kubiq/n-gauge/README.md

# N Gauge

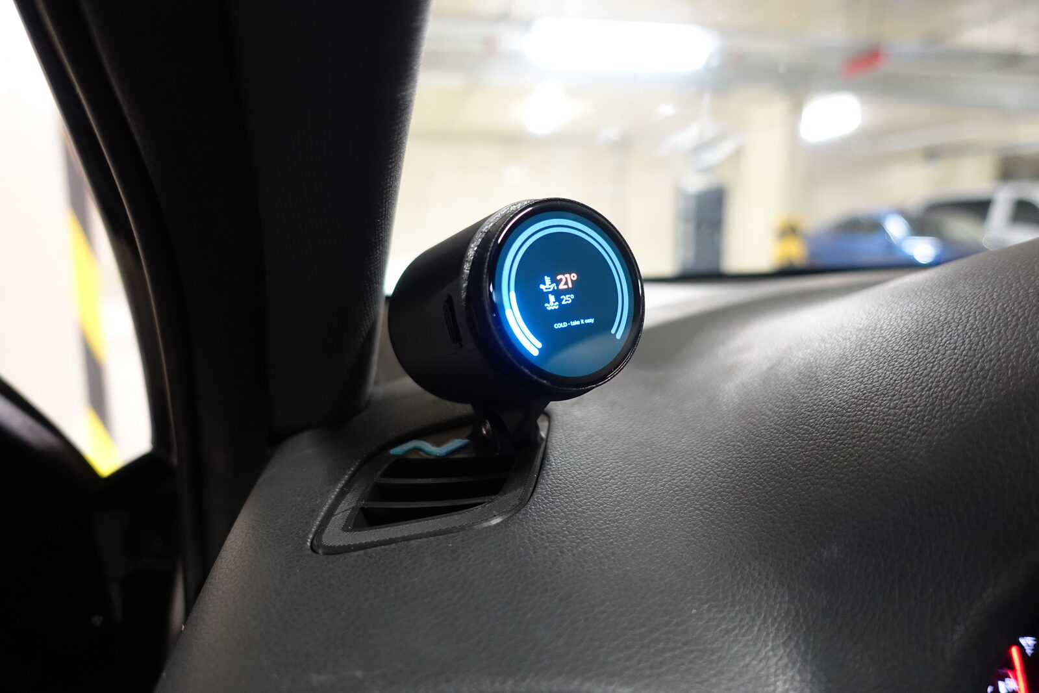
[picture p1: docs/photos/pod-on.jpg]
The pod on the dash, showing oil and coolant on a cold engine


A round AMOLED gauge that lives in the driver-side air vent of a **Hyundai
i30 N**, reading the car live over the OBD-II port: **oil temperature** - the
number the car's own dashboard hides behind a menu - plus coolant, boost, tyre
pressures, a g-meter, GPS speed and a lap timer. It logs every drive to an SD
card, uploads the logs home by itself as the car starts - over the phone's
hotspot and a WireGuard VPN - and a phone app pulls them off it and shows
each drive on a map.

Everything here was built for one car and is in daily use in it. It is a
hobby project, published in case the findings, the code or the approach help
someone with the same car or the same board.

<p>
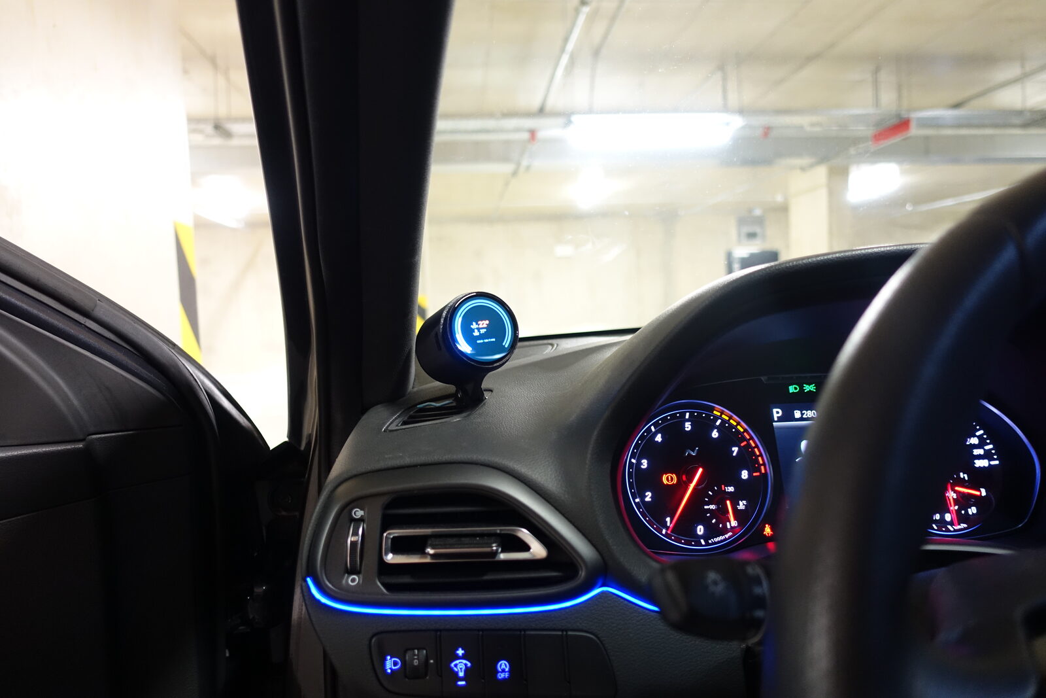
[picture p2: docs/photos/driver-view.jpg]
The driver's view: the pod above the left vent, beside the cluster

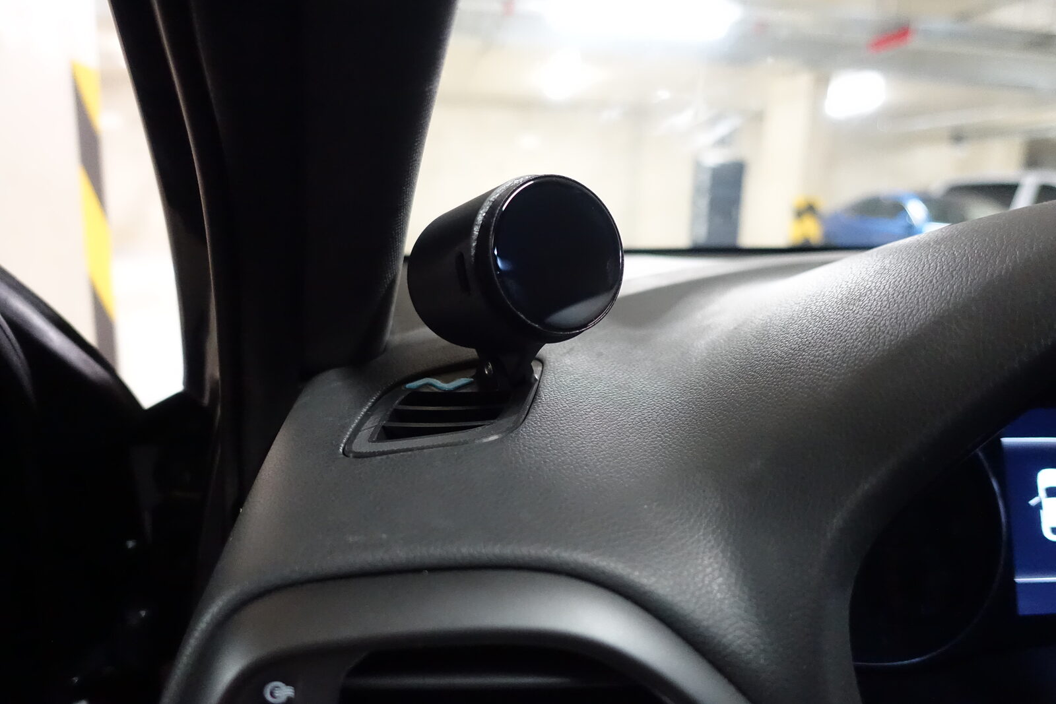
[picture p3: docs/photos/pod-off.jpg]
The pod switched off - a printed housing on the vent

</p>

*From the driver's seat, beside the car's own cluster; and switched off - the
3D-printed housing replaces the left air vent's surround.*

<p>
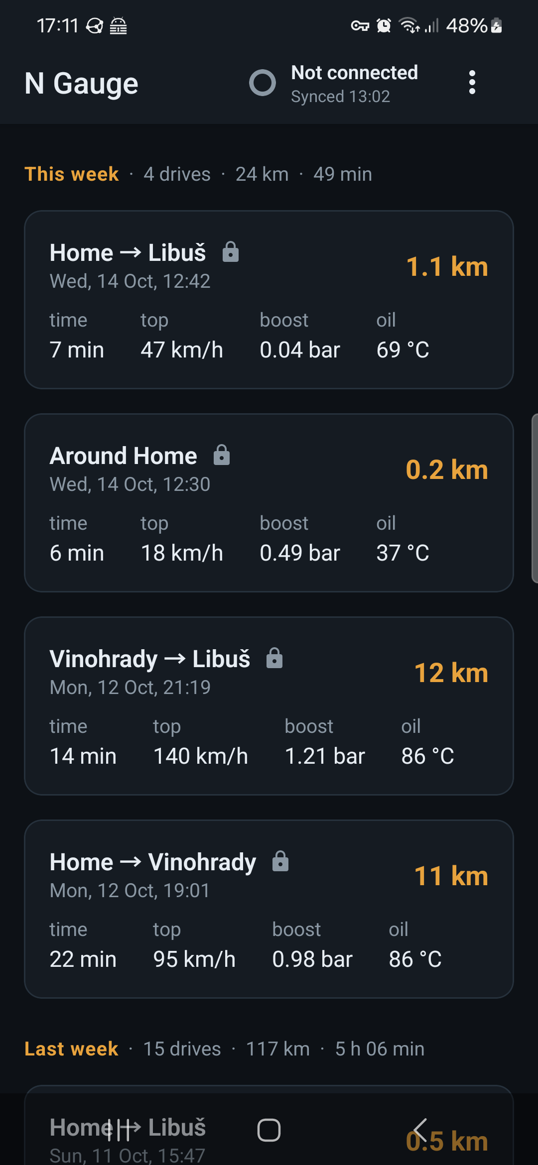
[picture p4: mobile/docs/screenshots/01-trips.png]

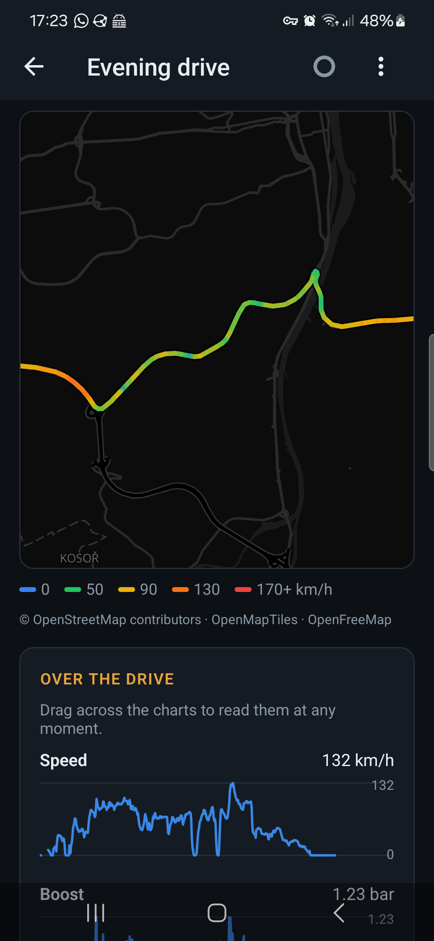
[picture p5: mobile/docs/screenshots/03-trip-map.png]

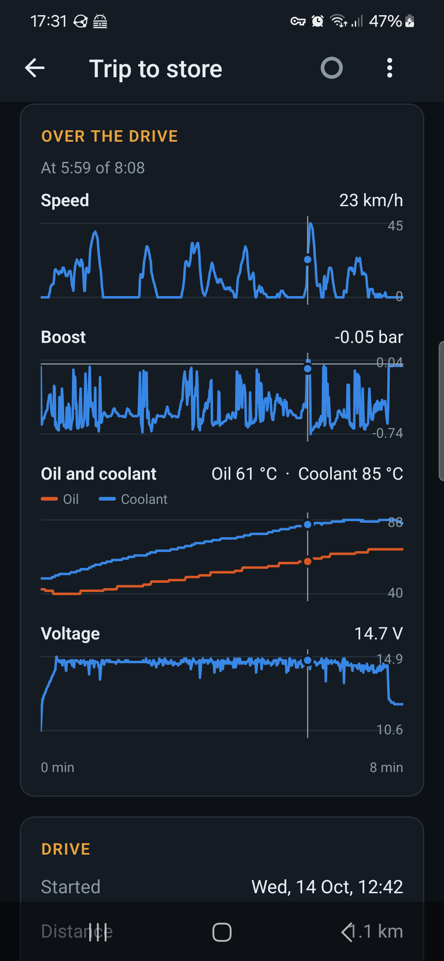
[picture p6: mobile/docs/screenshots/07-drive-charts.png]

</p>

*The phone app: every drive, named after where it went and grouped by week,
with the gauge in the header - its last sync, like a watch in Garmin
Connect; a tap on it syncs, then the phone is back on the internet. A drive
on the map, coloured by speed, and its speed, boost, temperatures and
voltage over time. More in [mobile/](mobile).*

<p>
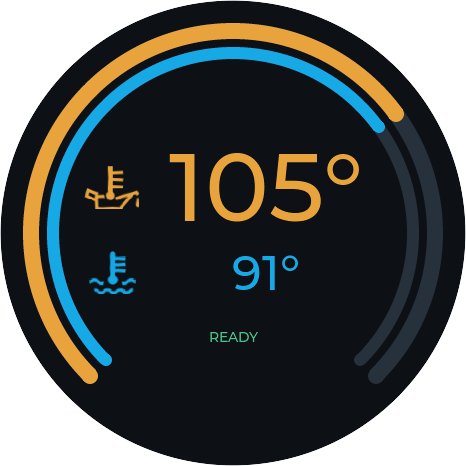
[picture p7: docs/gauge/01-oil.png]
Oil and coolant

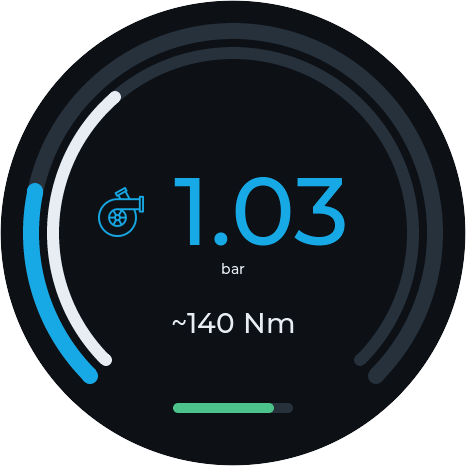
[picture p8: docs/gauge/02-boost.png]
Boost and torque

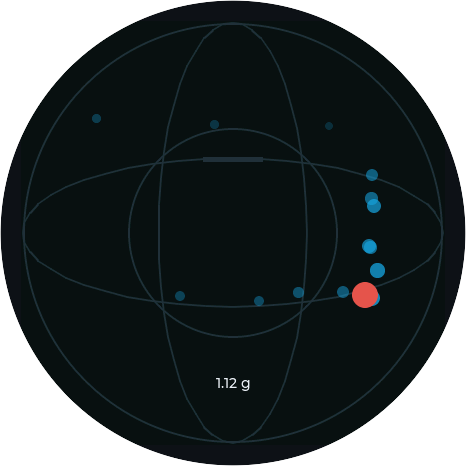
[picture p9: docs/gauge/03-gmeter.png]
The g-meter

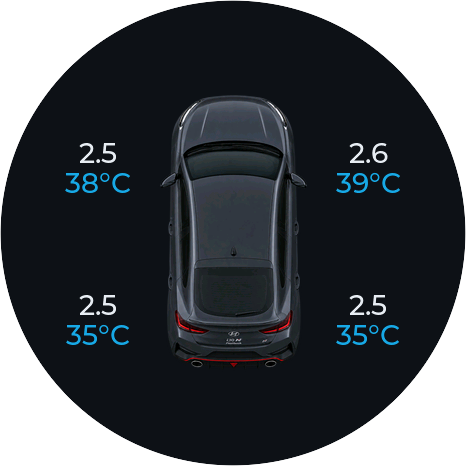
[picture p10: docs/gauge/04-tyres.png]
Tyre pressures and temperatures

</p>
<p>
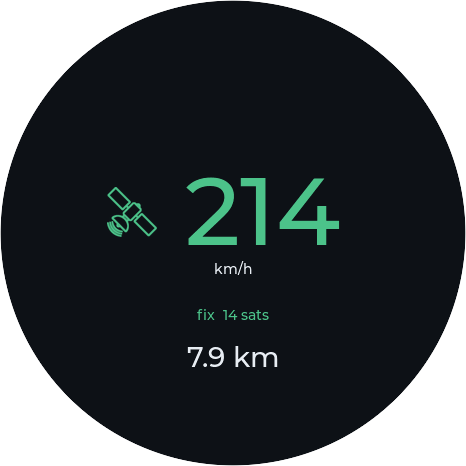
[picture p11: docs/gauge/05-gps.png]
GPS speed and trip

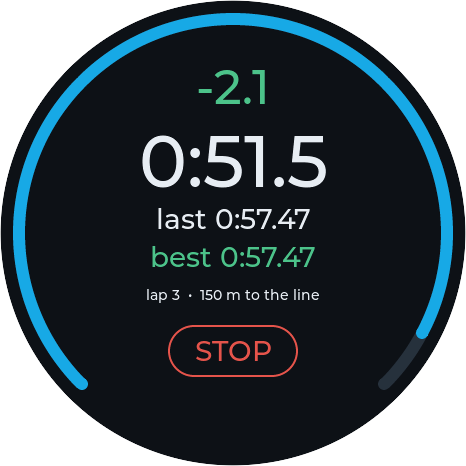
[picture p12: docs/gauge/06-track.png]
The lap timer, with the delta to the best lap

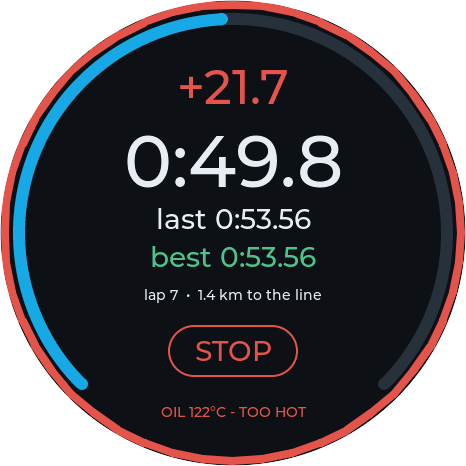
[picture p13: docs/gauge/07-oilhot.png]
The lap timer with the oil over-temperature warning around it

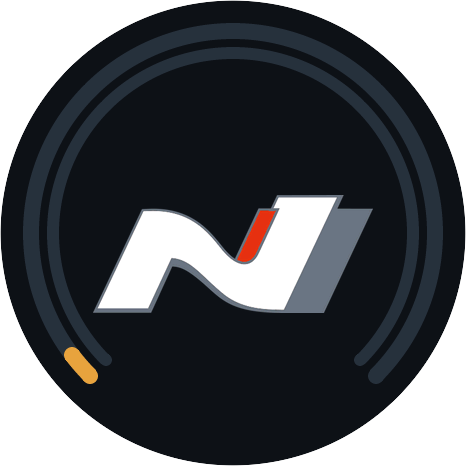
[picture p14: docs/gauge/00-wake.png]
Waking up: the N badge until the car answers

</p>

*The gauge's screens - oil and coolant, boost, the g-meter, tyres, GPS, and
the lap timer 1.8 s up on the best lap, the arc filling up to the line - then
the oil over its warning on the in-lap, a red rim over whichever screen is
up, and the N badge it wakes up with. Swiped through on the gauge; these are
from the [simulator](sim) on a made-up track session (`sim/screenshots.sh`).*

## What it does

- **Gauges:** oil and coolant (concentric arcs, with a cold-engine "not
  ready" state, and over-temperature warnings on every screen), boost, a
  g-meter, the four tyre pressures and temperatures, GPS speed and trip
  distance, a lap timer that finds the start/finish line by itself (tap START
  in the pit, then drive), with how far the line is and the live delta to the
  best lap.
- **Logging:** a CSV of every drive (2 Hz, decoded values - battery voltage,
  fuel rate, lambda, catalyst and fuel rail among them), a GPX track at
  25 Hz, a sleep log, and for each track session a Racelogic `.vbo` with
  every channel, which lap analysers open (HackTheTrack, Circuit Tools).
  Logs can be encrypted to a key only the phone holds, so a card taken out of
  the gauge gives nothing away. GPS points are kept only while the car talks
  or really moves, so a parked car's GPS drift is not a drive.
- **Upload home:** as the car starts - in the garage or setting off, where
  the GPS matters least - the gauge joins the phone's hotspot (a phone
  routine turns it on when it connects to the car's Bluetooth), opens a
  WireGuard tunnel into the home network and sends a small service on the
  home server ([server/](server)) whatever it lacks, resuming where the last
  upload stopped. The logs go as encrypted as they are on the card. Set up
  once in the app: the hotspot, the VPN (the gauge makes its own key; the app
  shows its public half for the router) and the server, with a time limit
  for how long the hotspot is the gauge's. Measured first, with a test build:
  transmitting costs ~6 dB of GNSS signal at any WiFi power, so it happens
  in the seconds an upload takes, not the whole drive. An optional status
  screen shows where it is - the hotspot, the VPN, the firmware download,
  the logs sent - and what came of the last one.
- **Waking up:** the N badge until the car answers, so the gauges never
  show a row of dashes; with a PC on USB, a status page for the desk.
- **Power:** deep sleep when the car goes quiet, ~11 mA parked (about 57
  days on the battery); wakes on CAN activity, the button, or the door
  opening (the IMU's wake-on-motion).
- **Firmware updates:** from the phone, the SD card or - by itself, after
  each upload of the logs, resuming a download that was cut off - the home
  server, signed (Ed25519) so it installs nothing else; on probation, rolled
  back if the new one fails.
- **Phone:** its own WiFi access point - with the upload set up, only once
  swiped to on the gauge, so the radio is free otherwise - with settings
  pages, OTA firmware
  updates with rollback, and an Android app ([mobile/](mobile)) that joins it
  from a QR code on the gauge, syncs the logs by itself and then lets go of
  the gauge's WiFi, so the phone is back on the internet. Each drive is
  named after where it started and ended (offline, from GeoNames - your own
  places like "Home" win), grouped by week, with its track on a map and its
  speed, boost, temperatures and voltage as charts. Delete a drive and it
  goes from the gauge too. A notification says when the gauge has a new
  drive (it puts a mark in its WiFi beacon), the synced drives can be saved
  to a folder by themselves, and the gauge's System card shows which part of
  it holds the internal RAM. English or Czech; dark themes or light.
- **Diagnostics:** a line per boot on the card (GPS rate, clock, CAN, RAM,
  why it last reset - and after a watchdog reset, which task it was), and
  the gauge's own WiFi repairs a join that got no address.

## Hardware

| Part | |
|---|---|
| Waveshare ESP32-S3-Touch-AMOLED-1.75 | 466×466 round AMOLED, touch, IMU, PMU, SD slot |
| SN65HVD230 | CAN transceiver, on OBD pins 6 and 14 |
| u-blox NEO-M9N | GNSS, 25 Hz |
| TPS5430 buck | 12 V → 5 V from OBD pin 16 |
| 3D-printed vent pod | replaces the left air vent; STLs in [mechanical/pod](mechanical/pod) |
| carrier PCB | KiCad, in [hardware/carrier](hardware/carrier) - replaces the breakout boards |

## Things worked out about the i30 N

Most of this took real drives and a lot of wrong turns; the reasoning, and
the wrong turns, are in [DECISIONS.md](DECISIONS.md).

- **Oil temperature is byte 34** of the Mode 22 reply to DID `0xE001` (engine
  ECU, `0x7E0`): `°C = raw × 0.7435 − 49.2`, matched against the dashboard up
  to 100 °C. Mode 01 PID `0x5C` is not supported. Byte 25 of the same reply
  *looks* like oil but is coolant-derived - and correlating bytes against the
  coolant curve picks it, which is how it was wrongly used for weeks.
- **Coolant as the dashboard shows it** is byte 25 of that reply, a few
  degrees below PID `0x05`.
- **Tyre pressures and temperatures** come from the TPMS module (`0x7A0`,
  DID `0xC00B`), not the ECU.
- **The OBD port is behind a gateway:** no broadcast traffic reaches it, only
  replies to requests - so brake, pedal and steering cannot be read passively
  there.
- **Gear** is derived from rpm ÷ speed; the measured ratios are in
  `config.h`.
- **Battery / charging voltage** is plain Mode 01 PID `0x42`: 14.4-15.0 V
  running, 9.9-10.6 V cranking, 12.1-12.7 V just after switching off. Then
  the ECU answers **0.00 V** for a few seconds before going quiet - drop
  it, it is not the battery.

## Repository

| Path | |
|---|---|
| [firmware/car_gauge_v1](firmware/car_gauge_v1) | the gauge firmware (Arduino, ESP32 core 3.x, LVGL 9) |
| [mobile](mobile) | the Android app (Expo / React Native) |
| [server](server) | the upload service the gauge sends its logs to (Python, Docker) |
| [sim](sim) | the gauge firmware on a PC: its screens in a window, fed a recorded drive |
| [tests](tests) | host tests of the firmware's pure logic |
| [hardware](hardware), [mechanical](mechanical) | carrier PCB, 3D-printed parts |
| [DECISIONS.md](DECISIONS.md) | why things are the way they are |
| [docs/flows.md](docs/flows.md) | how it decides, as diagrams: the logs' way, the upload, the WiFi, updates, screens, sleep |
| [PROTOTYPE_GUIDE.md](PROTOTYPE_GUIDE.md), [PRINTING_GUIDE.md](PRINTING_GUIDE.md) | wiring the prototype; printing the pod |

## Building

Firmware ([details](firmware/car_gauge_v1/README.md)):

```sh
./scripts/setup-libs.sh          # Arduino core, pinned libraries, lv_conf
./scripts/build.sh gauge flash   # compile and flash over USB
./scripts/test.sh                # host tests
./scripts/check.sh               # before a commit: tests, both firmware builds, the sim, the server
```

GitHub Actions ([.github/workflows/ci.yml](.github/workflows/ci.yml)) runs the
same checks but the simulator (it needs SDL2 from Ubuntu's mirrors, which
the runners could not reach for days), and the app's, on every push and pull
request. A version tag
(`git tag v2026.11.09 && git push --tags`) also makes a release: the firmware
as an update, and a full image for a first flash over USB. Releases carry the
public half of an update signing key if the repository variable `FW_SIGN_PUB`
holds one, and are signed if the secret `FW_SIGN_KEY` holds its private half
(64 hex digits) - the app then fetches the newest release by itself, checks
its signature against the gauge's key, and offers it in Gauge settings.

The upload server ([details](server/README.md)), on the home server:

```sh
cd server && echo "UPLOAD_TOKEN=$(openssl rand -hex 16)" > .env
docker compose up -d --build
```

With `FW_GITHUB_REPO=owner/name` in its `.env` it also passes that
repository's latest signed release on to the gauge, which then updates itself
([details](server/README.md#firmware-updates)). The signing key, once:

```sh
scripts/release-fw.py --init                 # then FW_SIGN_KEY and FW_SIGN_PUB on GitHub
```

The gauge on a PC ([details](sim/README.md)) - needs SDL2 and CMake:

```sh
sim/run.sh                       # the newest drive in data/, in a window
scripts/make_track_gpx.py        # a made-up track session to drive it with
sim/screenshots.sh               # these screenshots, into docs/gauge/
```

App ([details](mobile/README.md)):

```sh
cd mobile && ./scripts/build-apk.sh install   # release APK onto a phone over adb
```

## Caveats

- **Not affiliated with Hyundai.** "Hyundai", "i30 N" and the N badge used in
  the boot screen and the app icon are Hyundai's trademarks; they appear here
  only to say which car this is for.
- The gauge only **reads** - standard OBD and diagnostic requests, nothing
  that writes to the car. Still: it is your car, your OBD port and your
  responsibility, and a device on the dash must not distract from driving or
  sit in an airbag's path.
- Built and tested on one car, a European i30 N Fastback. Other model years
  or markets may answer differently.

## Licence

[MIT](LICENSE). Third-party assets keep their own licences - see
[firmware/assets/README.md](firmware/assets/README.md). The place names in
the app (`mobile/assets/places`) are from [GeoNames](https://www.geonames.org),
CC BY 4.0.
