kubiq/n-gauge/firmware/assets/coolant_temp.webp

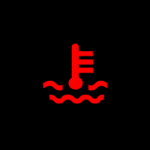
firmware/assets/coolant_temp.webp
