kubiq/n-gauge/firmware/assets/fastback.png

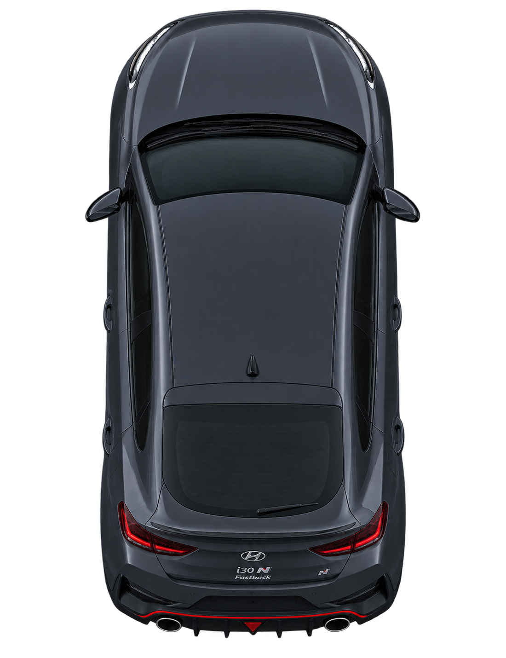
firmware/assets/fastback.png
