kubiq/n-gauge/firmware/assets/oil_temp.png

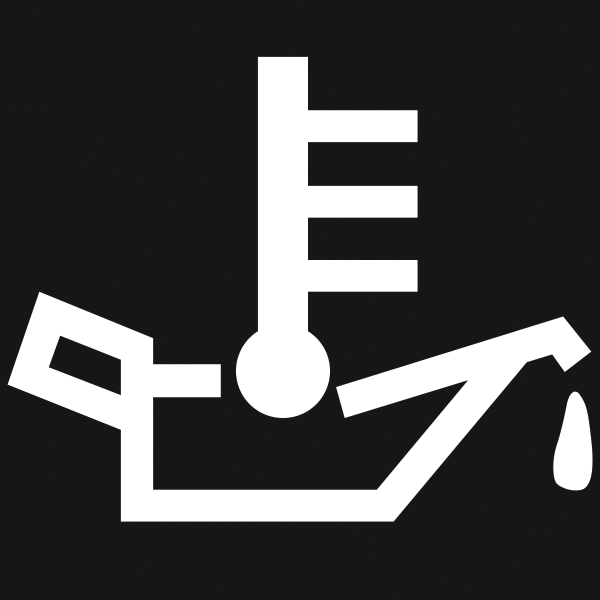
firmware/assets/oil_temp.png
