kubiq/n-gauge/firmware/assets/satellite.jpg

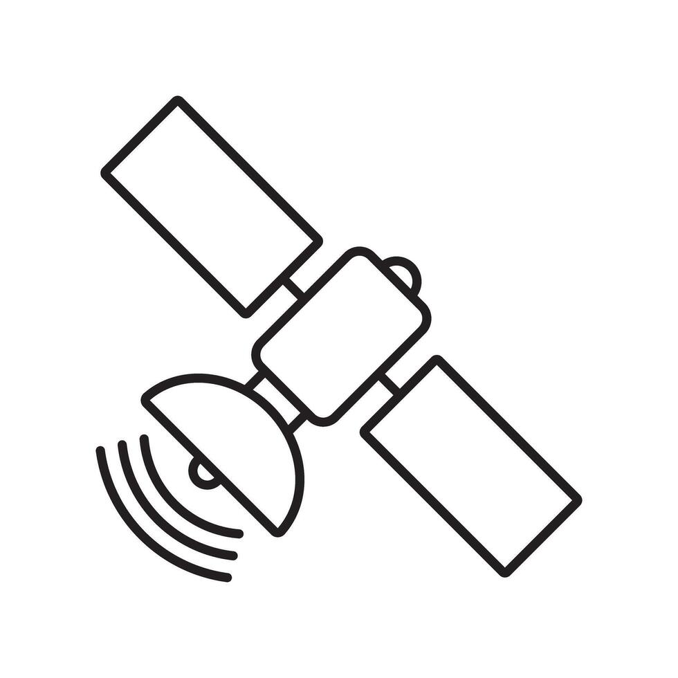
firmware/assets/satellite.jpg
