kubiq/n-gauge/firmware/assets/turbo.jpg

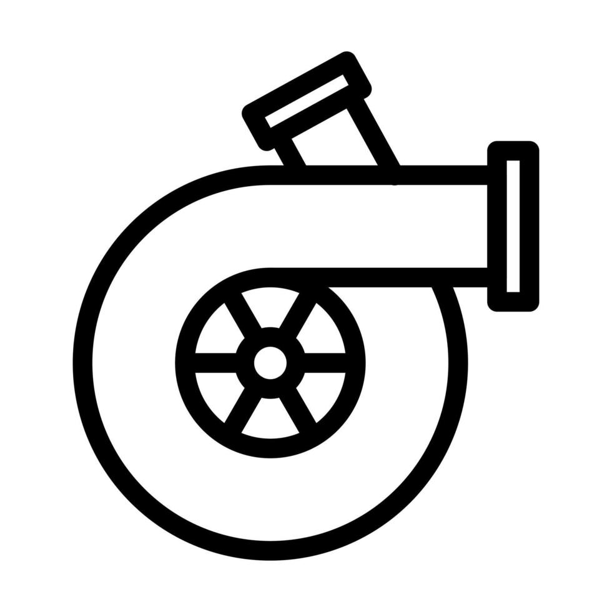
firmware/assets/turbo.jpg
