kubiq/n-gauge/mobile/docs/screenshots/01-pod.png

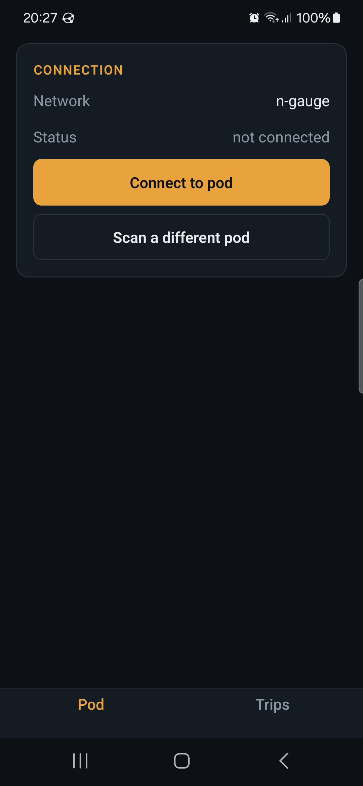
mobile/docs/screenshots/01-pod.png
