kubiq/n-gauge/mobile/docs/screenshots/02-server.png

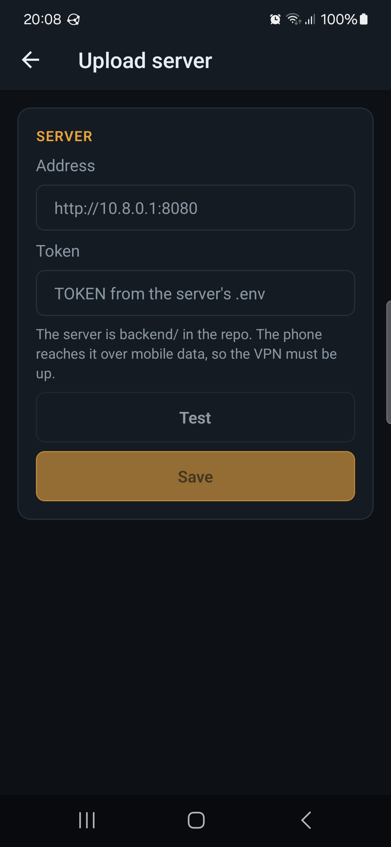
mobile/docs/screenshots/02-server.png
