kubiq/n-gauge/mobile/docs/screenshots/02-trips-menu.png

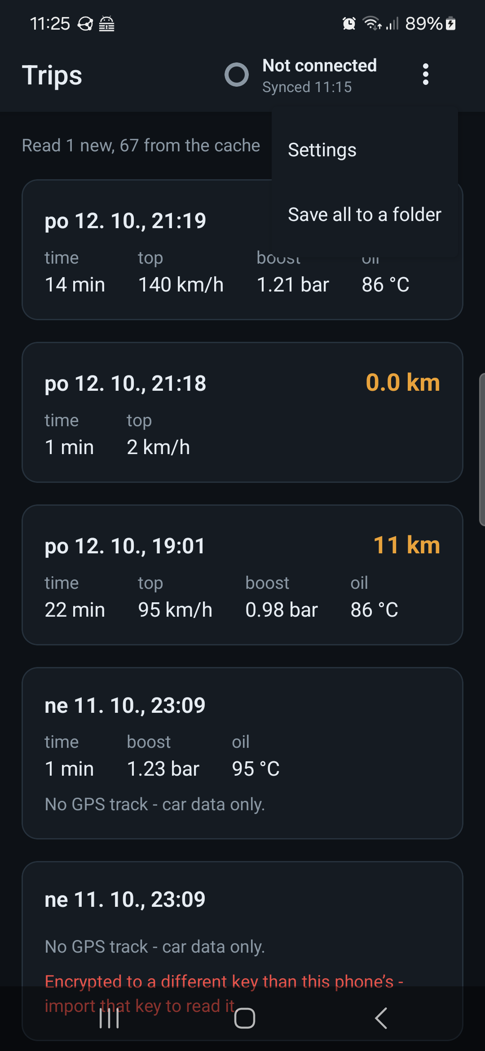
mobile/docs/screenshots/02-trips-menu.png
