kubiq/n-gauge/mobile/docs/screenshots/03-trips.png

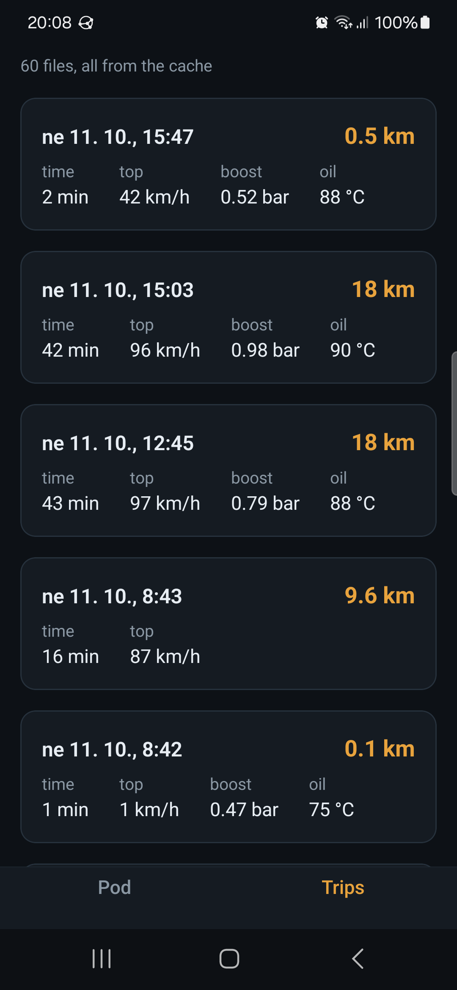
mobile/docs/screenshots/03-trips.png
