kubiq/n-gauge/mobile/docs/screenshots/04-gauge.png

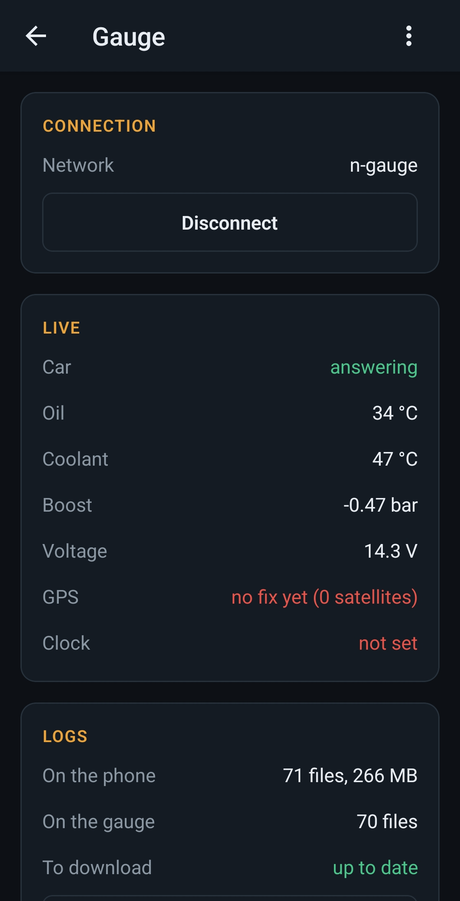
mobile/docs/screenshots/04-gauge.png
