kubiq/n-gauge/mobile/docs/screenshots/04-trip-map.png

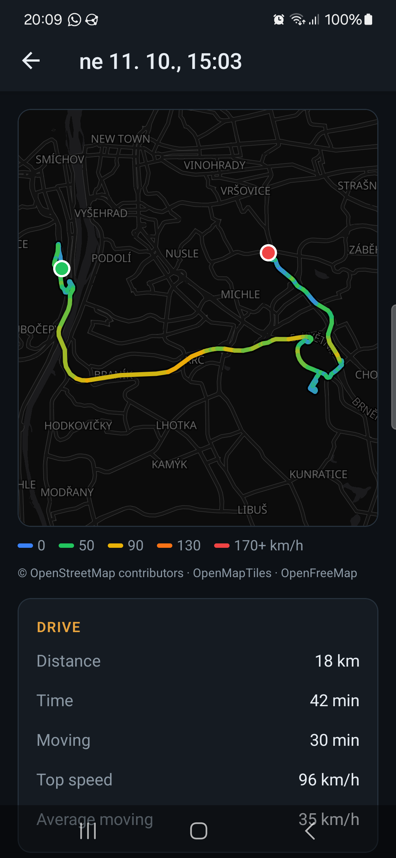
mobile/docs/screenshots/04-trip-map.png
