kubiq/n-gauge/mobile/docs/screenshots/05-settings.png

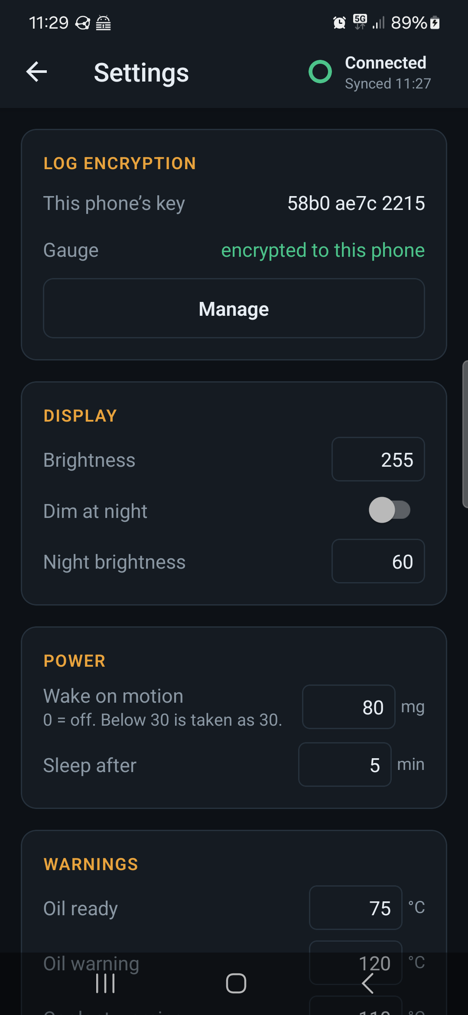
mobile/docs/screenshots/05-settings.png
