kubiq/n-gauge/mobile/docs/screenshots/05-trip-stats.png

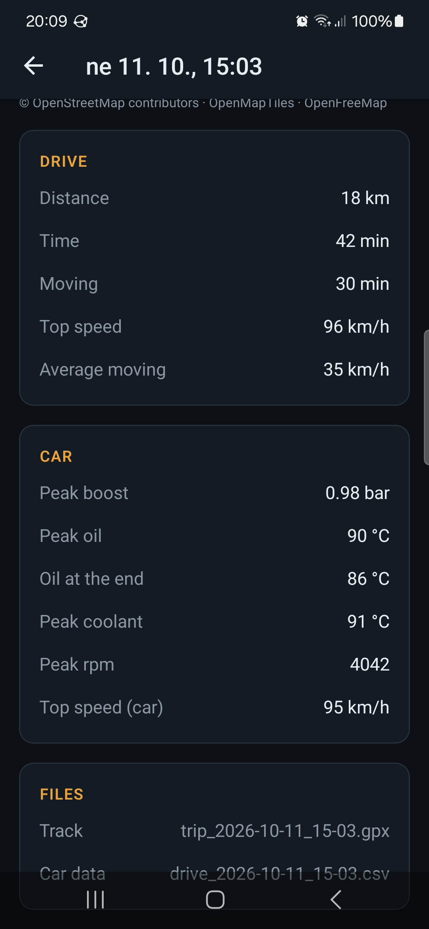
mobile/docs/screenshots/05-trip-stats.png
