kubiq/n-gauge/mobile/docs/screenshots/06-pod-live.png

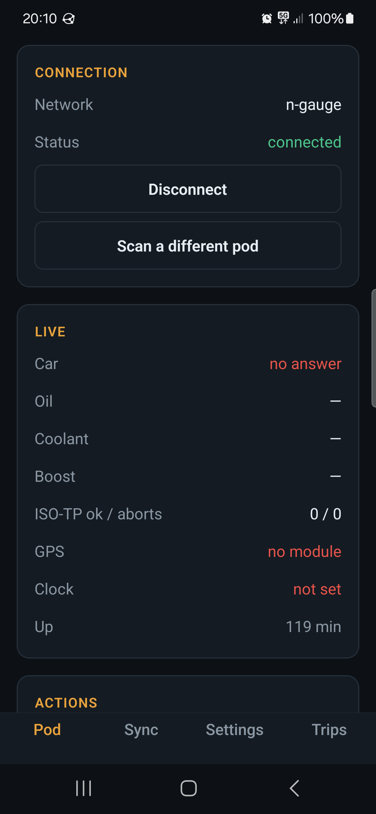
mobile/docs/screenshots/06-pod-live.png
