kubiq/n-gauge/mobile/docs/screenshots/06-settings-logging.png

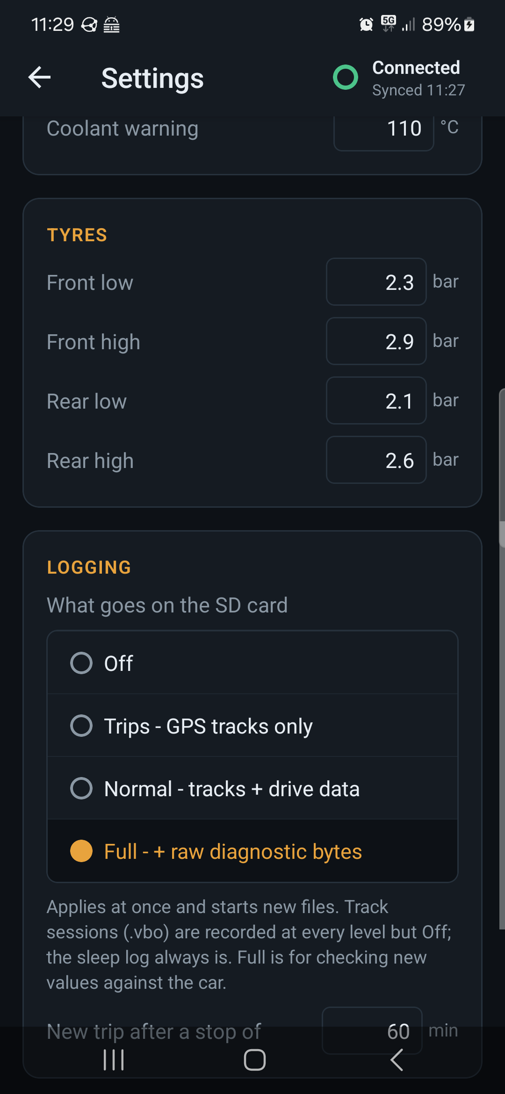
mobile/docs/screenshots/06-settings-logging.png
