kubiq/n-gauge/mobile/docs/screenshots/07-sync.png

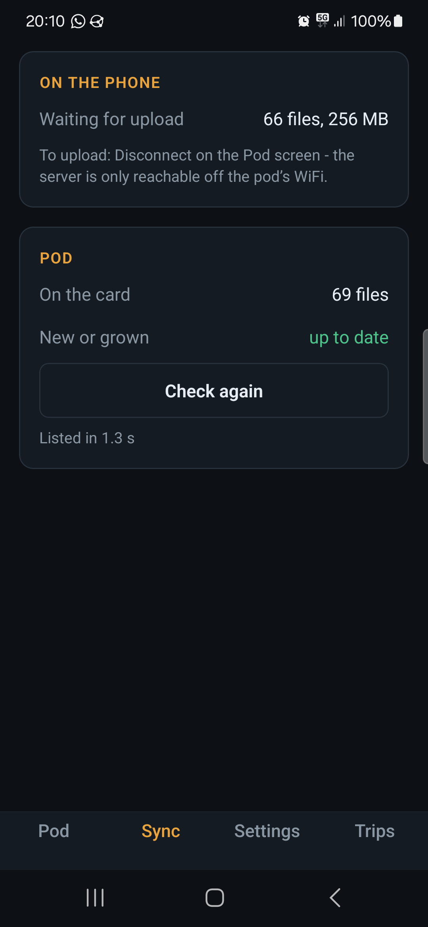
mobile/docs/screenshots/07-sync.png
