kubiq/n-gauge/mobile/docs/screenshots/08-settings.png

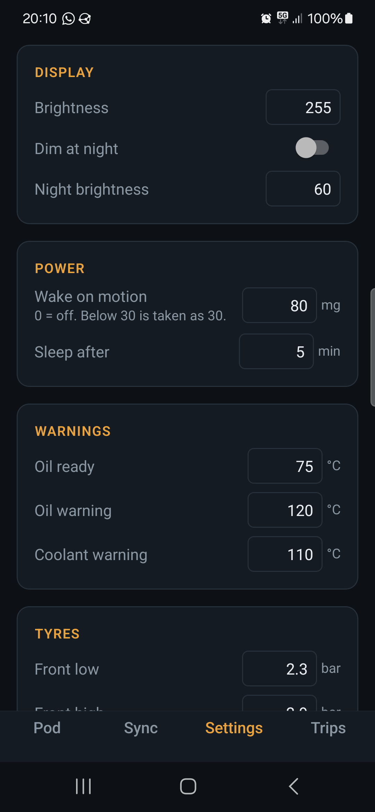
mobile/docs/screenshots/08-settings.png
