kubiq/n-gauge/mobile/docs/screenshots/09-settings-logging.png

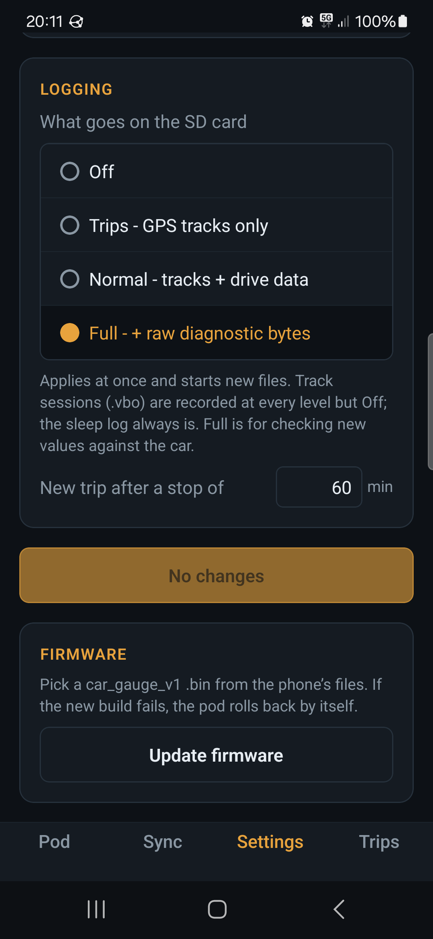
mobile/docs/screenshots/09-settings-logging.png
