kubiq/n-gauge/mechanical/grille_cover_v1.stl

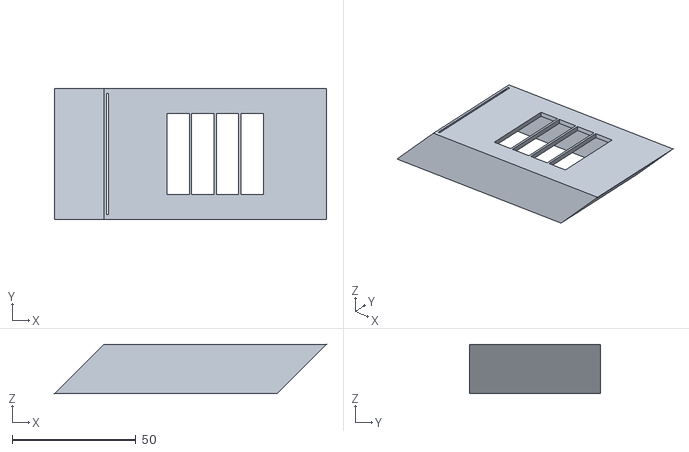
[picture p34: CAD file, 2026-10-11]
mechanical/grille_cover_v1.stl
110.0 x 53.0 x 20.0
