kubiq/n-gauge/mechanical/pod/i30n_internals.stl

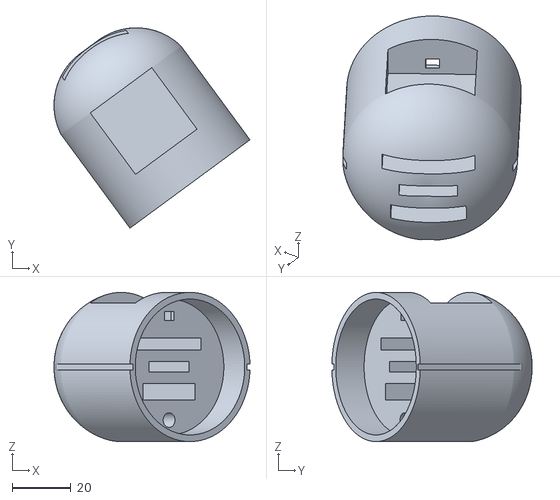
[picture p35: CAD file, 2026-10-11]
mechanical/pod/i30n_internals.stl
66.7 x 68.2 x 50.8
