kubiq/n-gauge/mechanical/pod/i30n_vent_left.stl

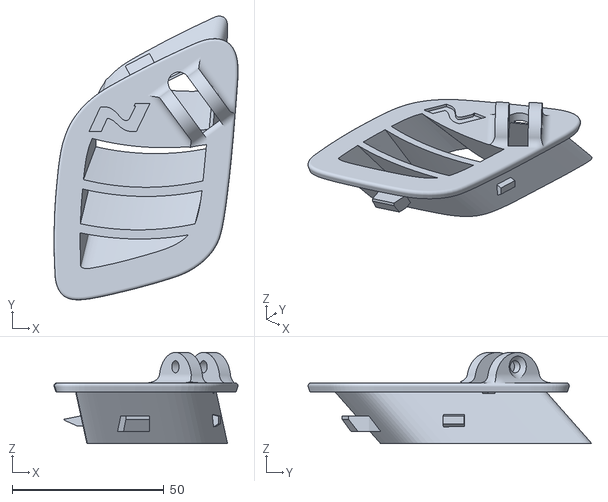
[picture p36: CAD file, 2026-10-11]
mechanical/pod/i30n_vent_left.stl
60.6 x 93.5 x 30.0
