kubiq/n-gauge/mechanical/pod/i30n_pod_left.stl

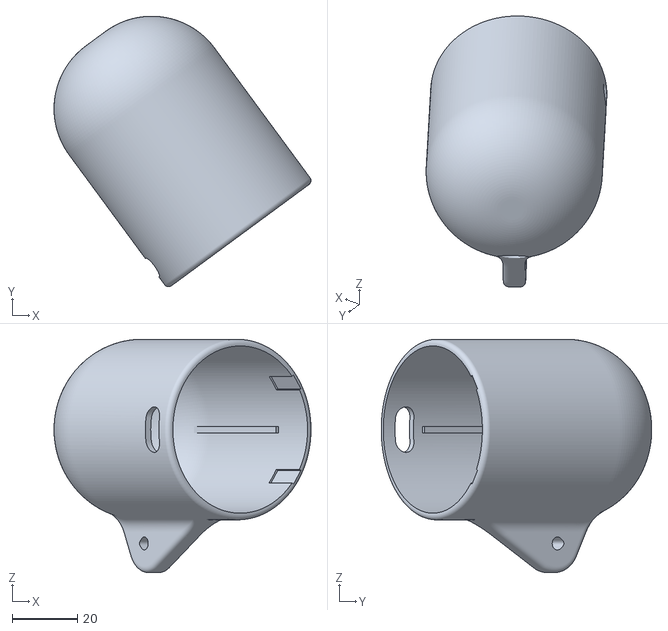
[picture p37: CAD file, 2026-10-11]
mechanical/pod/i30n_pod_left.stl
79.0 x 83.1 x 71.8
