kubiq/n-gauge/prototype-guide.html

Hyundai i30 N · Build Log

# Driver-Vent OBD Gauge — Prototype Guide

A round AMOLED reading oil temperature and boost live from the OBD-II port over CAN. This is the prototype phase — prove the values on a cheap ESP32 before buying the display.

Primary: Oil temp Secondary: Boost Bus: CAN 500 kbit/s MCU: ESP32 → ESP32-S3

98°C

Oil Temp

1.2 bar

Boost

Order list

Order now · in stock

- ✓ Classic ESP32 dev board (have)
- ✓ SN65HVD230 transceiver, 2-pack (ordered · remove 120 Ω)
- ✓ OBD-II male pigtail (flying leads)
- USB power bank (optional — laptop USB powers the ESP32)

Final build

- ✓ Waveshare ESP32-S3 1.75" AMOLED 466×466 — Standard (~$50 · ordered)
- ✓ 12 V→5 V buck (ordered) — ≥36 V input (TPS5430-based); not MP1584 (27 V max). Not needed to prototype.
- ✓ Inline blade-fuse holder (pigtail) + 2 A fuse for the OBD 12 V line (ordered · not an add-a-fuse tap)
- Filament: PETG / ASA (not PLA)

Later · v2

- ✓ GNSS — track pick: u-blox NEO-M9N (~$25–40 · ordered): 25 Hz, 4-constellation, ~1.5 m (≈1 m w/ EGNOS)
- Budget: NEO-M8N (10 Hz). Pro: ZED-F9P (cm, needs RTK feed). Use an active antenna + set dynamic model "Automotive". Wire: VCC · GND · TX→GPIO18

## 01 Parts for the prototype

Everything you need to read real values off the car before spending ~$50 on the round display.

Part | Notes
Classic ESP32 dev board | Has the built-in TWAI/CAN controller
SN65HVD230 transceiver (blue "VP230") | 3.3 V logic. Remove the 120 Ω terminator — see check 1
OBD-II male pigtail (flying leads) | Taps CAN-H / CAN-L / GND
USB power bank | Powers the ESP32 in the car, isolated
Multimeter | For the two checks below

## 02 Before wiring — two checks

Two minutes with a multimeter now saves a confusing first session in the car.

Check 1 · Remove the 120 Ω terminator

The car's CAN bus is already terminated; an extra 120 Ω can corrupt it. Measure resistance across CANH ↔ CANL on the transceiver board alone:

- ~120 Ω → it has a terminator (marked 121) → desolder that resistor.
- Open / very high → no terminator → leave it as is.

Both board variants work: AliExpress = header pins + CTX/CRX labels; Waveshare/Botland = screw terminal + CAN TX/CAN RX labels. Same SN65HVD230 chip, same wiring.

Check 2 · Find OBD pins 6 & 14 — don't trust wire colors

Cheap pigtails use random colors. In continuity / beep mode, touch one probe to a flying wire and the other to each metal pin in the OBD plug. Pin numbers are molded in: 1–8 top row, 9–16 bottom. Label the CAN-H and CAN-L wires once found.

OBD-II pin | Signal | Goes to
6 | CAN-H | transceiver CANH
14 | CAN-L | transceiver CANL
4 / 5 | Ground | ESP32 GND
16 | +12 V (optional, later) | —

## 03 Wiring

Bus speed 500 kbit/s · no extra terminator on our side · power the ESP32 from the power bank during testing.

wiring.txtESP32 GPIO5 (CAN TX) ──►  SN65HVD230 CTX
ESP32 GPIO4 (CAN RX) ──►  SN65HVD230 CRX
ESP32 3.3V           ──►  SN65HVD230 3V3
ESP32 GND            ──►  SN65HVD230 GND
SN65HVD230 CANH      ──►  OBD-II pin 6   (CAN-H)
SN65HVD230 CANL      ──►  OBD-II pin 14  (CAN-L)
ESP32 GND            ──►  OBD-II pin 4 or 5  (GND)

## 04 Flashing the sniffer

Sketch: firmware/can_sniffer/can_sniffer.ino

1. Arduino IDE with the ESP32 board package (Boards Manager → "esp32" by Espressif).
2. Tools → Board → ESP32 Dev Module (or your specific board).
3. Select the correct Port.
4. Open the sketch → Upload.
5. Open Serial Monitor at 115200 baud, line ending = Newline.

If GPIO4/5 clash with your board, change CAN_TX_GPIO / CAN_RX_GPIO at the top of the sketch. Avoid strapping pins 0 / 2 / 12 / 15 and input-only 34–39.

## 05 Test session in the car

1. Plug the pigtail into the OBD-II port (under the dash, driver side).
2. Power the ESP32 from your laptop's USB (the same cable shows the Serial Monitor).
3. Ignition ON (engine off is fine for sniffing; run it for real oil/boost values).
4. Open Serial Monitor.

### What you should see

A stream of [RX] xxx [8] .. lines = CAN frames. ✓ This confirms your tap works. If nothing streams, jump to Troubleshooting.

### Built-in commands

Type a command in the Serial Monitor and press Enter:

Command | Does
s | Toggle the live frame dump on/off (turn OFF to read replies clearly)
oil | Request standard oil temp (Mode 01 PID 5C)
boost | Request manifold pressure (Mode 01 PID 0B)
01 0C | Request RPM — sanity-check the request path
22 XXXX | Enhanced request, 2-byte DID (the real i30 N oil-temp DID)
help | Reprint commands

If oil returns a sensible temperature — great, standard PID works. If it returns a NEGATIVE response, the i30 N doesn't expose 015C → use the enhanced Mode 22 DID below.

## 06 The real oil temp — enhanced Mode 22

The i30 N's true oil temp (and true boost) live in enhanced PIDs requested with Mode 22 to ECU header 7E0. Don't guess the DID — use a community-validated list.

- Car Scanner ELM OBD2 app → the "Hyundai i30 N" custom-PID profile.
- Torque Pro extended-PID CSVs shared on i30 N forums / Reddit.

Each entry gives the request bytes (e.g. 22 XXXX) and a scaling formula. In the Serial Monitor, send the DID; the sketch prints the raw response bytes. Apply the formula — commonly A − 40 or (A·256 + B)/scale — to get °C.

Bring this back

Send me the raw bytes + the formula and we'll bake the oil-temp DID straight into the final firmware.

## 07 Troubleshooting

Symptom | Likely cause / fix
No [RX] frames at all | CAN-H / CAN-L swapped → swap pins 6/14. Or ignition off. Or GND not connected.
twai_start failed on boot | Wrong TX/RX GPIOs for your board, or pins already in use. Change them in the sketch.
Frames garbled / error bursts | Wrong bus speed (must be 500 kbit/s) or the 120 Ω terminator wasn't removed.
NEGATIVE (7F) responses | That PID/DID isn't supported → use the enhanced Mode 22 DID from the list.
A few frames, then silence | Bus went to sleep → turn ignition on / wake the car.

## 08 Power plan — Option B chosen

Powered from OBD-II pin 16 (+12 V) via a 12 V→5 V buck — the whole gauge stays a single OBD-port plug, no fuse-box wiring.

Pin 16 is constant battery power, so the firmware manages sleep to avoid parked drain:

- CAN bus watched → no frames for ~30 s → AMOLED off + esp_deep_sleep.
- Ignition on wakes the bus → ESP32 wakes and resumes the gauge.
- The i30 N diagnostic CAN bus sleeps after ignition-off, so this triggers cleanly.

⚠ Open TODO · measure quiescent draw

Once sleep is implemented, measure actual parked current on the 12 V feed — including the buck's own quiescent draw (cheap bucks pull several mA at no load). Target a few mA or less; if too high, use a low-Iq buck or a hard cutoff. Fallback: Option A — switched 12 V from a cabin fuse, which cuts power fully with the car.

## 09 After the prototype succeeds

1. Confirm oil temp + boost read correctly and update fast enough.
2. Order the Waveshare ESP32-S3 1.75" AMOLED Round Touch (466×466, ~$50).
3. Move CAN to the S3 header: GPIO17 = CAN TX, GPIO16 = CAN RX (GPIO18 free).
4. Build the LVGL gauge UI — oil-temp + boost, touch to switch, brightness.
5. Add sleep-on-bus-idle power management, then measure quiescent draw.
6. 3D-print the vent panel in PETG / ASA (not PLA — dash heat), keeping OEM louvers working.
7. Final power: OBD pin 16 → 12 V→5 V buck → display 5 V pin.

## 10 Mounting — vent cover + display pod

Location: the driver-side fixed side-window demister grille on the dash top by the A-pillar (part 97383-G3000-TRY). It blows up/out at the glass, so a pod mounted in front, angled inboard at the driver, sits out of the airflow path. Full demist kept, no trade-off.

1. Pop off the OEM demister grille (clips) and study its mounting + the grille opening.
2. Measure with calipers or 3D-scan the opening and the dash-top curvature.
3. Model a replacement cover that recreates the fixed grille slots (or reuses the OEM grille insert) — demist airflow to the side window untouched.
4. Add a low-profile display pod on the driver/inboard side, in front of the grille, angled at the eyes, with a recessed circular pocket + lip/gasket for the round AMOLED. Keep it clear of the outboard airflow.
5. Route the display FPC + wiring down behind the A-pillar trim / into the dash to the ESP32 and power.
6. Print in ASA / PETG (dash heat + UV); matte finish or wrap to match the dash.

⚠ Near the windscreen — keep it low

This spot is at the windscreen base: too tall blocks forward view and reflects in the glass. Keep the pod low, angle the face slightly down, and use auto-dim (day/night) + an anti-glare film to kill windscreen reflection.

### OEM part number (confirmed — PD / Elantra GT catalog)

Target = the fixed side-window demister grille: Nozzle Assy-Side Defroster, LH = 97383-G3000-TRY (driver side). RH = 97393-G3000-TRY.

- Single variant (-TRY, black) — no colour-suffix ambiguity.
- Order one as a donor to 3D-scan; keep the fitted one intact.
- Not this build: the adjustable louvered corner vent lower down = 97480-G3000-[color].

### Custom pod — fully bespoke

No usable OEM-vent STL exists, and off-the-shelf holders are RHD-only and sized for 52/60 mm gauges. So this is modeled from scratch, exactly for our ~46 mm display — which is the point: it's our part. (See References for a RHD holder worth eyeballing for the approach.)

1. Remove the OEM demister grille; note how it clips in and the grille opening pattern.
2. Capture geometry — phone 3D-scan of the removed grille + opening; fallback calipers + photos with a scale marker.
3. Design a two-part piece: a cover that recreates the fixed grille slots (keeps demist airflow), and a pod holding the ~46 mm AMOLED at driver angle with a bezel lip and rear cable exit.
4. Print test rings of just the opening profile first to dial in fit before the full part.
5. Final print in ASA / PETG, matte or wrapped to match the dash.

### 3D scanning (phone → cloud)

Using the RealityScan phone app (Epic cloud) — the Linux desktop build needs an NVIDIA ≥8 GB GPU we don't have, so cloud is the path. Photos, not video — ~40–60 stills, 70–80 % overlap, 3 heights all around, tap-to-focus.

⚠ Monotone black = blobby mesh → add features

Stipple the show face with a white paint marker (POSCA): many small ~1–2 mm dots, RANDOM spacing (never a grid), densely all over. White-on-black is ideal contrast; a grid confuses the matcher.

It's your car's part, so use a water-based paint pen → wipes off with isopropyl alcohol (test an edge first). Keep dots off the mounting/clip faces. Use soft diffuse light to avoid gloss hotspots. Avoid uniform white "scanning spray" — that's for laser scanners, not photogrammetry.

- Alignment/scale: textured background + a couple of printed coded targets; set scale from two dots a known distance apart.
- Flip the part to capture the mounting/clip side.
- Hybrid — don't scan the slots: caliper the grille slot width/spacing/count + mounting dims and model them parametrically; use the scan only for the curved shell. Export OBJ (meshes ~0.2–0.5 mm noisy).

### CAD on Linux

Fusion 360 isn't native on Linux → model in FreeCAD (parametric, native — pod + snap-fit, mesh as reference) or Blender (mesh cleanup / organic surfaces).

## 11 Feature roadmap

What the gauge grows into. Oil temp, cold-engine warning, boost and the over-temp guard are the v1 core; connectivity and the GPS track come much later.

Hardware note · GPS — buy the Standard version

The GPS variant is out of stock, and you don't need it. Add a GNSS module later (see order list — NEO-M9N for track), read-only into GPIO18 over UART. It sits in the tube by the vent opening near the windscreen → good sky view. CAN stays on GPIO16/17; buttons are onboard. Nothing about v1 changes.

v1 Core gauge · build first

- Oil temperature (Mode 22 DID) — the main goal
- Cold-engine warning — "take it easy" until oil ~90 °C, then green "ready"
- Boost gauge
- Audible over-temp guard — speaker alarm on oil/coolant limit
- G-force meter from the IMU (stretch)
- Buttons to switch screens without touching the display

v2 Data & connectivity · later

- Log OBD + GPS to TF card as GPX / CSV per drive
- Phone app over WiFi to download session files
- Google Maps track — the drive as a route, colored by speed / boost / oil-temp

v3 Nice-to-have

- DTC read & clear
- Shift light
- OTA updates
- Gauge themes · lap timer

## 12 Safety notes

- Reading CAN is passive/low-risk — but never leave anything transmitting garbage while driving.
- Don't power the display from OBD pin 16 (constant 12 V = battery drain) — use switched 12 V.
- Be careful pulling dash trim near the airbag; disconnect the battery for deeper work.
- Keep the screen glanceable and dimmable — driver-distraction rules.

## 13 Local sourcing (CZ / EU)

Fast options — days, not weeks. The prototype parts are all sourceable now; only the round display is a long-lead item, and it isn't needed to prototype.

### Prototype parts — order now

Part | Source | Price / stock
SN65HVD230 | Botland · Waveshare 3945 (https://botland.store/can-bus-modules/6960-sn65hvd230-can-board-waveshare-3945-5904422300715.html) | €4.50 · ✓ 24 h dispatch
SN65HVD230 (CZ alt) | pajenicko (https://pajenicko.cz/prevodnik-sn65hvd230-can-bus) | 58 Kč · ✗ out
OBD-II plug (solder-your-own) | GME · MOLEX 51115-1601 (https://www.gme.cz/v/1496582/molex-51115-1601-konektor-obd-ii-16pin) | verify on page
OBD-II ready cable | easydiag.cz (https://www.easydiag.cz/obd2-16-pin-male-female-60-cm-rozdvojka-konektor-obd-plne-zapojen) | 140 Kč · ✓ (min 2)

Not stocked: LaskaKit, Dratek, GME (bare TI chip only) — for the module.

### Later parts — no rush

Part | Where
Round AMOLED display | Not local — Waveshare direct / AliExpress, or ask LaskaKit to special-order
Compact buck (Recom R-78 / Pololu) | TME.eu or GME
GNSS M9N + antenna | AliExpress / Botland

### Shop search links

Swap the query at the end for any part:

- LaskaKit — laskakit.cz/vyhledavani/?string=…
- Dratek — dratek.cz/hledani.php?heureka=…
- GME — gme.cz/vyhledavani?query=… (https://www.gme.cz/vyhledavani?query=SN65HVD230)
- Botland — botland.store/search?s=… (https://botland.store/search?s=SN65HVD230)
- TME (buck/connectors) — tme.eu/en/katalog/?search=… (https://www.tme.eu/en/katalog/?search=recom%20r-78)

## 14 References & inspiration

Link | Why
Boosted Intl · Demister Vent Gauge Holder (https://boostedintl.com/product/hyundai-i30-i30n-demister-vent-gauge-holder/) | RHD / 52–60 mm — not usable, but good reference for the airflow-retaining, driver-angled vent replacement
PartSouq · i30 parts catalog (https://partsouq.com/en/catalog/genuine/pick?c=Hyundai&model=i30) | Verify the vent part number by VIN
OEM RH vent 97490-G4000 (https://www.ebay.co.uk/itm/387308639005) | Part reference — mirror of our LH part
Car Scanner "i30 N" profile · Torque Pro CSVs | Community-validated enhanced oil-temp & boost DIDs (Mode 22)

i30 N OBD Gauge · prototype phase · pairs with can_sniffer.ino and PROTOTYPE_GUIDE.md
