kubiq/n-gauge/hardware/carrier/carrier.kicad_pcb

## KiCad design hardware/carrier/carrier.kicad_pcb (2026-10-15)

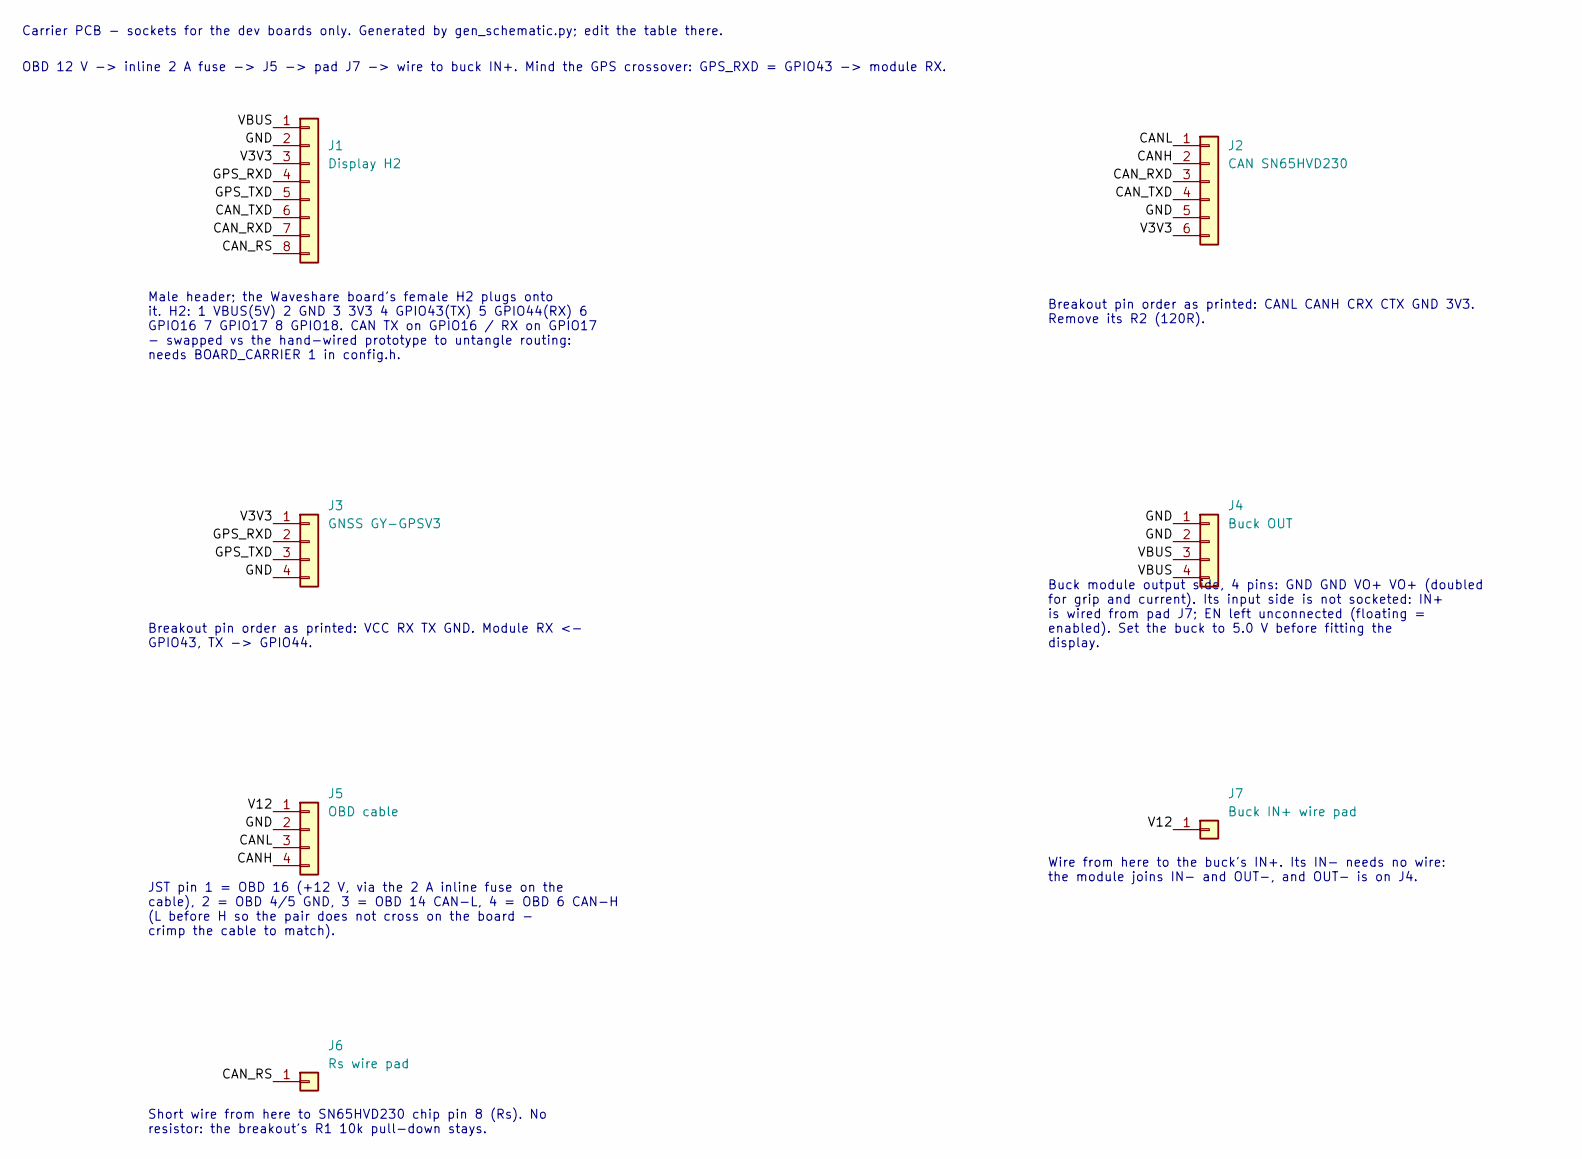
[picture p38: schematic carrier.kicad_sch, i30 N gauge pod - carrier]

Parts:
J1: Display H2; PinHeader_1x08_P2.54mm_Vertical
J2: CAN SN65HVD230; PinSocket_1x06_P2.54mm_Vertical
J3: GNSS GY-GPSV3; PinSocket_1x04_P2.54mm_Vertical
J4: Buck OUT; PinSocket_1x04_P2.54mm_Vertical
J5: OBD cable; JST_XH_B4B-XH-A_1x04_P2.50mm_Vertical
J6: Rs wire pad; TestPoint_THTPad_D2.0mm_Drill1.0mm
J7: Buck IN+ wire pad; TestPoint_THTPad_D2.0mm_Drill1.0mm

Connections:
CANH: J2.2, J5.4
CANL: J2.1, J5.3
CAN_RS: J1.8, J6.1
CAN_RXD: J1.7, J2.3
CAN_TXD: J1.6, J2.4
GND: J1.2, J2.5, J3.4, J4.1, J4.2, J5.2
GPS_RXD: J1.4, J3.2
GPS_TXD: J1.5, J3.3
V3V3: J1.3, J2.6, J3.1
V12: J5.1, J7.1
VBUS: J1.1, J4.3, J4.4

Notes on the sheet:
Male header; the Waveshare board's female H2 plugs onto it. H2: 1 VBUS(5V) 2 GND 3 3V3 4 GPIO43(TX) 5 GPIO44(RX) 6 GPIO16 7 GPIO17 8 GPIO18. CAN TX on GPIO16 / RX on GPIO17 - swapped vs the hand-wired prototype to untangle routing: needs BOARD_CARRIER 1 in config.h.
Breakout pin order as printed: CANL CANH CRX CTX GND 3V3. Remove its R2 (120R).
Breakout pin order as printed: VCC RX TX GND. Module RX <- GPIO43, TX -> GPIO44.
Buck module output side, 4 pins: GND GND VO+ VO+ (doubled for grip and current). Its input side is not socketed: IN+ is wired from pad J7; EN left unconnected (floating = enabled). Set the buck to 5.0 V before fitting the display.
JST pin 1 = OBD 16 (+12 V, via the 2 A inline fuse on the cable), 2 = OBD 4/5 GND, 3 = OBD 14 CAN-L, 4 = OBD 6 CAN-H (L before H so the pair does not cross on the board - crimp the cable to match).
Wire from here to the buck's IN+. Its IN- needs no wire: the module joins IN- and OUT-, and OUT- is on J4.
Short wire from here to SN65HVD230 chip pin 8 (Rs). No resistor: the breakout's R1 10k pull-down stays.
Carrier PCB - sockets for the dev boards only. Generated by gen_schematic.py; edit the table there.
OBD 12 V -> inline 2 A fuse -> J5 -> pad J7 -> wire to buck IN+. Mind the GPS crossover: GPS_RXD = GPIO43 -> module RX.

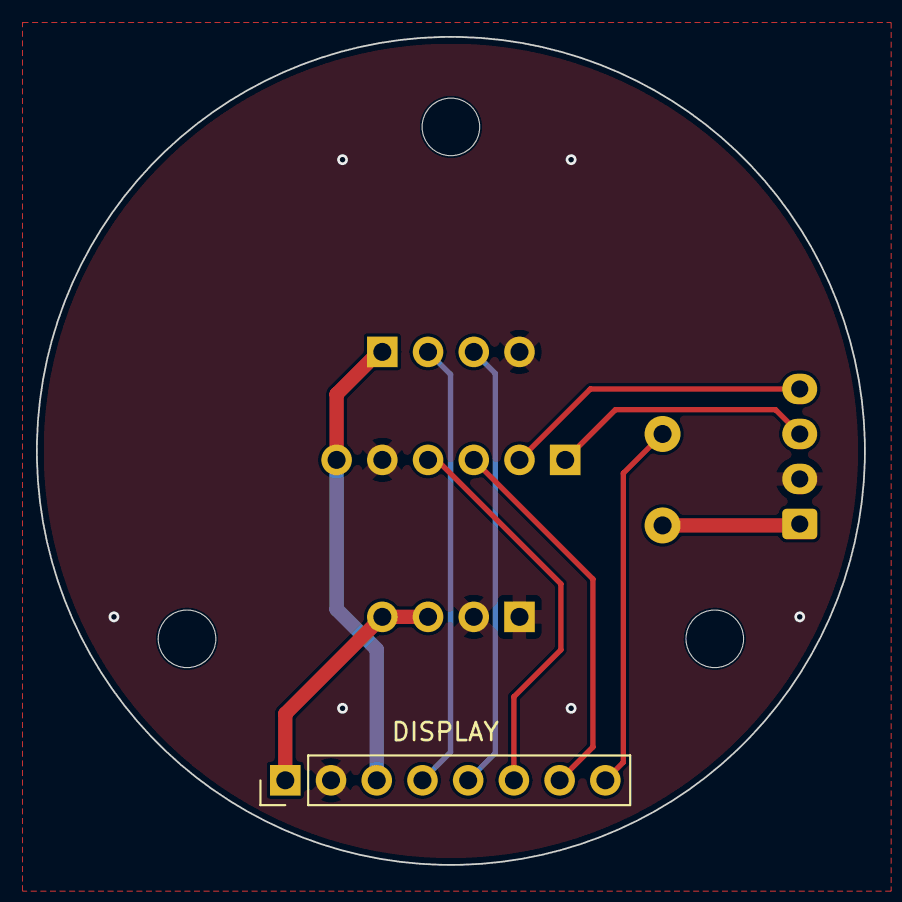
[picture p39: board carrier.kicad_pcb from above]

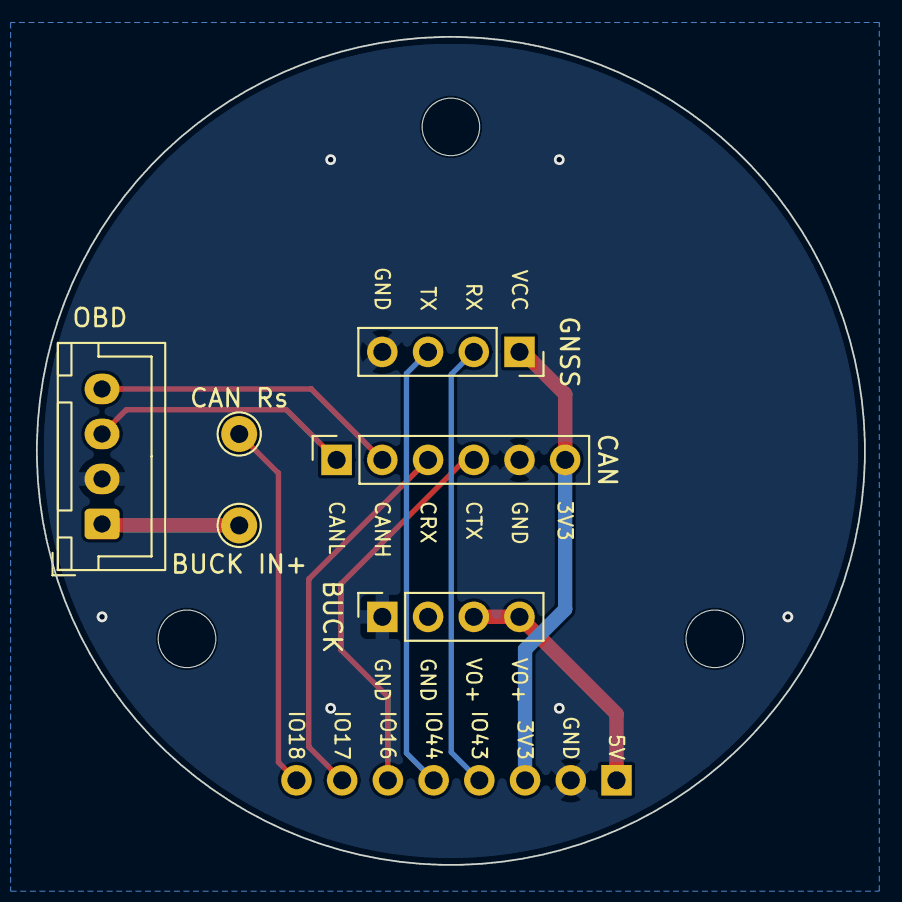
[picture p40: board carrier.kicad_pcb from below]

Board: 2 copper layers, 46.0 x 46.0 mm, 10 parts (6 on the bottom side), 11 nets.

Other parts of the board:
H1, H2, H3: M3 to pod; MountingHole_3.2mm_M3
