kubiq/n-gauge/firmware/car_gauge_v1/upload.cpp

// ============================================================================
// upload.cpp  —  see upload.h.
// ============================================================================
#include <Arduino.h>
#include <HTTPClient.h>
#include <Preferences.h>
#include <SD_MMC.h>
#include <WiFi.h>
#include <WireGuard-ESP32.h>
#include <esp_app_desc.h>   // the running firmware's hash: is the server's newer?
#include <esp_heap_caps.h>
#include <esp_ota_ops.h>    // the app slot's size: the most a firmware may be
#include <esp_random.h>
#include <esp_system.h>     // esp_reset_reason: no upload in a wake begun by a crash
#include <lwip/dns.h>    // dns_setserver: the server's name by public resolvers
#include <lwip/tcpip.h>  // LOCK_TCPIP_CORE around it
#include <lwip/netif.h>  // netif_set_down: the hotspot's interface, before the radio goes
#include <esp_netif.h>   // ... found by its key
#include <esp_netif_net_stack.h>  // esp_netif_get_netif_impl: its lwIP netif
#include <mbedtls/base64.h>
#include <mbedtls/sha256.h>  // the downloaded firmware's, for its signature
#include <time.h>
#include "upload.h"
#include "config.h"     // OTA_SD_PATH, OTA_SD_NEW: where a firmware from the server goes
#include "logger.h"    // LoggerSdLock, logger_card_ok, logger_note_boot
#include "monocypher.h" // crypto_x25519_public_key: the gauge's WireGuard key
#include "monocypher-ed25519.h" // crypto_ed25519_check: a firmware's signature
#include "ota.h"        // ota_sign_pub: who a firmware from the server must be signed by
#include "podstate.h"   // the car is on: the time to go
#include "rtc.h"        // clock_valid: the handshake carries a timestamp
#include "webapi.h"     // web_is_up, web_clients

// ---- timings ---------------------------------------------------------------
#define UP_JOIN_MS       90000   // the hotspot comes up after the phone's BT does
#define UP_HANDSHAKE_MS  30000   // the tunnel's first request waits for it
// The whole upload, at most: a setting (upMaxMin, the app's Upload card),
// so the phone's hotspot is not held longer than its owner wants. What is
// left goes the next time, from where this one stopped.
#define UP_MAX_MIN_DEFAULT  10
#define UP_MAX_MIN_TOP      60
#define UP_HTTP_MS       10000
// A failed try (no hotspot yet, no answer) is tried again this much later,
// up to UP_TRIES per wake. A minute (asked 2026-11-11; was 5 min, 3
// tries): the garage's signal fails the tunnel's handshake, and leaving it
// takes about a minute - by the third try at 5 min apart the phone's
// hotspot, up ~10 min after the car starts, was gone. A try takes ~1-2
// min itself (a join, the 30 s handshake wait), so 8 cover those 10 min
// and a little more; a failed one costs a few KB of mobile data.
#define UP_RETRY_MS      60000
#define UP_TRIES             8
#define UP_CHUNK          4096   // a card read, under the lock (internal: SD DMA)
#define UP_PLAN_MAX    (48 * 1024)
#define UP_TASK_STACK     8192

// ---- the settings, NVS namespace "upload" ----------------------------------
struct UpConfig {
  char     ssid[33], pass[64];        // the hotspot
  char     url[96];                   // the server, as seen inside the tunnel
  char     token[65];
  char     wgAddr[16];                // the gauge's address in the tunnel
  char     wgPeer[45];                // the router's public key, base64
  char     wgHost[64];                // the router, from outside
  char     wgDns[16];                 // a DNS inside the tunnel, for the server's name; "" = the hotspot's
  uint16_t wgPort;
  uint8_t  maxMin;                    // the time limit, minutes
  uint8_t  autoUpdate;                // firmware from the server after the logs (1 = yes)
  uint8_t  wgPriv[32];                // made here, never leaves
};
static UpConfig cfg;
static char wgPub[45];                // its public half, base64

static const char *NS = "upload";
const char *const UPLOAD_KEYS[] = {"upSsid", "upPass", "upUrl", "upToken", "wgAddr",
                                   "wgPeer", "wgHost", "wgPort", "wgDns", "upMaxMin", "upAuto", "wgNewKey", nullptr};

static void b64(char *out, size_t n, const uint8_t *in, size_t len) {
  size_t olen = 0;
  if (mbedtls_base64_encode((unsigned char *)out, n, &olen, in, len) != 0) olen = 0;
  out[olen] = '\0';
}

static void newKey() {
  esp_fill_random(cfg.wgPriv, sizeof(cfg.wgPriv));
  cfg.wgPriv[0] &= 248;                // Curve25519's clamping, as wg genkey
  cfg.wgPriv[31] = (cfg.wgPriv[31] & 127) | 64;
}

static void derivePub() {
  uint8_t pub[32];
  crypto_x25519_public_key(pub, cfg.wgPriv);
  b64(wgPub, sizeof(wgPub), pub, sizeof(pub));
}

static void save() {
  Preferences p;
  if (!p.begin(NS, false)) return;
  p.putString("ssid", cfg.ssid);
  p.putString("pass", cfg.pass);
  p.putString("url", cfg.url);
  p.putString("token", cfg.token);
  p.putString("wgAddr", cfg.wgAddr);
  p.putString("wgPeer", cfg.wgPeer);
  p.putString("wgHost", cfg.wgHost);
  p.putString("wgDns", cfg.wgDns);
  p.putUShort("wgPort", cfg.wgPort);
  p.putUChar("maxMin", cfg.maxMin);
  p.putUChar("auto", cfg.autoUpdate);
  p.putBytes("wgPriv", cfg.wgPriv, sizeof(cfg.wgPriv));
  p.end();
}

static void getStr(Preferences &p, const char *k, char *out, size_t n) {
  String s = p.getString(k, "");
  strlcpy(out, s.c_str(), n);
}

// WireGuard.cpp's step in end(), kept across a reset: 0x5747000N.
extern volatile uint32_t wg_end_step;
static uint8_t endStepSeen = 0;         // printed from upload_task, after USB is up

// The gauge's own WiFi is asked for (upload_give_way): every wait in the
// upload stops on it, and it ends with UP_STOPPED - not a failed try.
static volatile bool giveWay = false;
#define UP_STOPPED "stopped for the gauge's WiFi"

// No upload in a wake that began with a crash (2026-11-12): two in a row
// came closing a failed upload's tunnel, and each fresh boot tried again -
// a loop holding the radio, the gauge's WiFi never up.
static bool afterCrash = false;

// ---- the result, for /api/upload and the boot log --------------------------
struct UpResult {
  uint32_t at;                        // epoch s, 0 = none yet / no clock
  bool     ok;
  uint16_t files;
  uint32_t bytes, ms;
  char     msg[72];
};
// The last try's result, kept in NVS ("last") since 2026-11-07: in RAM only,
// it was gone by the time the app could ask - the gauge sleeps after the
// drive the upload was tried on.
static UpResult last = {};

static void saveLast() {
  Preferences p;
  if (!p.begin(NS, false)) return;
  p.putBytes("last", &last, sizeof(last));
  p.end();
}

void upload_init() {
  if ((wg_end_step & 0xFFFFFFF0u) == 0x57470000u) endStepSeen = wg_end_step & 0xF;
  wg_end_step = 0;
  afterCrash = esp_reset_reason() == ESP_RST_PANIC;
  if (afterCrash) Serial.println(F("[..] upload: none this wake - it began with a crash"));
  memset(&cfg, 0, sizeof(cfg));
  cfg.wgPort = 51820;
  cfg.maxMin = UP_MAX_MIN_DEFAULT;
  cfg.autoUpdate = 1;                  // on, once a server is set up (asked 2026-11-09)
  bool haveKey = false;
  Preferences p;
  if (p.begin(NS, true)) {
    getStr(p, "ssid", cfg.ssid, sizeof(cfg.ssid));
    getStr(p, "pass", cfg.pass, sizeof(cfg.pass));
    getStr(p, "url", cfg.url, sizeof(cfg.url));
    getStr(p, "token", cfg.token, sizeof(cfg.token));
    getStr(p, "wgAddr", cfg.wgAddr, sizeof(cfg.wgAddr));
    getStr(p, "wgPeer", cfg.wgPeer, sizeof(cfg.wgPeer));
    getStr(p, "wgHost", cfg.wgHost, sizeof(cfg.wgHost));
    getStr(p, "wgDns", cfg.wgDns, sizeof(cfg.wgDns));
    cfg.wgPort = p.getUShort("wgPort", 51820);
    cfg.maxMin = p.getUChar("maxMin", UP_MAX_MIN_DEFAULT);
    cfg.autoUpdate = p.getUChar("auto", 1);
    haveKey = p.getBytes("wgPriv", cfg.wgPriv, sizeof(cfg.wgPriv)) == sizeof(cfg.wgPriv);
    if (p.getBytes("last", &last, sizeof(last)) != sizeof(last)) last = {};
    last.msg[sizeof(last.msg) - 1] = '\0';
    p.end();
  }
  if (!haveKey) {                      // first boot with this: the gauge's own key
    newKey();
    save();
    Serial.println(F("[OK] upload: made the gauge's WireGuard key"));
  }
  derivePub();
}

static bool configured() {
  return cfg.ssid[0] && cfg.url[0] && cfg.wgAddr[0] && cfg.wgPeer[0] && cfg.wgHost[0];
}

// Saved whatever it is (2026-11-06: refusing a value made it typed again
// and again) - cleaned up where the usual forms differ, and a word on what
// still looks wrong. Spaces and newlines at the ends go (a pasted key often
// has one); too long is cut; a character outside printable ASCII is dropped.
static void put(char *field, size_t n, const char *v) {
  while (*v == ' ' || *v == '\t') v++;
  size_t len = strlen(v);
  while (len && (v[len - 1] == ' ' || v[len - 1] == '\n' || v[len - 1] == '\r' || v[len - 1] == '\t')) len--;
  size_t o = 0;
  for (size_t i = 0; i < len && o + 1 < n; i++)
    if ((uint8_t)v[i] >= 32 && (uint8_t)v[i] <= 126) field[o++] = v[i];
  field[o] = '\0';
}

const char *upload_setting(const char *key, const char *v) {
  const char *note = nullptr;
  if (!strcmp(key, "upSsid")) {
    put(cfg.ssid, sizeof(cfg.ssid), v);
  } else if (!strcmp(key, "upPass")) {
    put(cfg.pass, sizeof(cfg.pass), v);
    if (strlen(cfg.pass) < 8) note = "the hotspot password is under 8 characters";
  } else if (!strcmp(key, "upUrl")) {
    // "192.168.1.10:8650" is taken as http://; a trailing / goes.
    char u[sizeof(cfg.url)];
    put(u, sizeof(u), v);
    if (u[0] && !strstr(u, "://")) snprintf(cfg.url, sizeof(cfg.url), "http://%s", u);
    else strlcpy(cfg.url, u, sizeof(cfg.url));
    size_t l = strlen(cfg.url);
    while (l && cfg.url[l - 1] == '/') cfg.url[--l] = '\0';
    if (cfg.url[0] && strncmp(cfg.url, "http://", 7)) note = "the server must be http:// (the tunnel encrypts)";
  } else if (!strcmp(key, "upToken")) {
    put(cfg.token, sizeof(cfg.token), v);
  } else if (!strcmp(key, "wgAddr")) {
    put(cfg.wgAddr, sizeof(cfg.wgAddr), v);
    char *slash = strchr(cfg.wgAddr, '/');      // "10.0.0.7/32", as the router shows it
    if (slash) *slash = '\0';
    IPAddress ip;
    if (cfg.wgAddr[0] && !ip.fromString(cfg.wgAddr)) note = "the tunnel address is not an IP address";
  } else if (!strcmp(key, "wgPeer")) {
    put(cfg.wgPeer, sizeof(cfg.wgPeer), v);
    if (cfg.wgPeer[0] && strlen(cfg.wgPeer) != 44) note = "the router's public key is not 44 characters";
  } else if (!strcmp(key, "wgDns")) {
    put(cfg.wgDns, sizeof(cfg.wgDns), v);
    IPAddress ip;
    if (cfg.wgDns[0] && !ip.fromString(cfg.wgDns)) note = "the DNS in the tunnel is not an IP address";
  } else if (!strcmp(key, "wgHost")) {
    put(cfg.wgHost, sizeof(cfg.wgHost), v);
    char *colon = strrchr(cfg.wgHost, ':');     // "vpn.example.org:51820": the port goes to wgPort
    if (colon && atol(colon + 1) > 0) {
      cfg.wgPort = (uint16_t)atol(colon + 1);
      *colon = '\0';
    }
  } else if (!strcmp(key, "wgPort")) {
    const long port = atol(v);
    if (port > 0 && port < 65536) cfg.wgPort = (uint16_t)port;
    else note = "the router port is not 1-65535";
  } else if (!strcmp(key, "upAuto")) {
    cfg.autoUpdate = (!strcmp(v, "0") || !strcmp(v, "false")) ? 0 : 1;
  } else if (!strcmp(key, "upMaxMin")) {
    const long m = atol(v);
    cfg.maxMin = (uint8_t)(m < 1 ? 1 : m > UP_MAX_MIN_TOP ? UP_MAX_MIN_TOP : m);
    if (m < 1 || m > UP_MAX_MIN_TOP) note = "the time limit is 1-60 minutes";
  } else if (!strcmp(key, "wgNewKey")) {
    newKey();
    derivePub();
  } else {
    return nullptr;
  }
  save();
  return note;
}

// ---- the result, for /api/upload (UpResult, above) -------------------------
static const char *jsonSafe(const char *s, char *out, size_t n) {
  size_t o = 0;
  for (; *s && o + 2 < n; s++) {
    if (*s == '"' || *s == '\\') out[o++] = '\\';
    out[o++] = *s;
  }
  out[o] = '\0';
  return out;
}

int upload_json(char *out, size_t n) {
  char ssid[70], url[200], host[130], msg[150], addr[34], peer[92], dns[34];
  const int len = snprintf(out, n,
      "{\"configured\":%s,\"ssid\":\"%s\",\"passSet\":%s,\"url\":\"%s\",\"tokenSet\":%s,"
      "\"wgAddr\":\"%s\",\"wgPeer\":\"%s\",\"wgHost\":\"%s\",\"wgPort\":%u,\"wgDns\":\"%s\","
      "\"maxMin\":%u,\"autoUpdate\":%s,\"fwKey\":%s,\"wgPub\":\"%s\","
      "\"last\":{\"at\":%lu,\"ok\":%s,\"files\":%u,\"bytes\":%lu,\"ms\":%lu,\"msg\":\"%s\"}}",
      configured() ? "true" : "false", jsonSafe(cfg.ssid, ssid, sizeof(ssid)),
      cfg.pass[0] ? "true" : "false", jsonSafe(cfg.url, url, sizeof(url)),
      cfg.token[0] ? "true" : "false", jsonSafe(cfg.wgAddr, addr, sizeof(addr)),
      jsonSafe(cfg.wgPeer, peer, sizeof(peer)),
      jsonSafe(cfg.wgHost, host, sizeof(host)), cfg.wgPort, jsonSafe(cfg.wgDns, dns, sizeof(dns)),
      cfg.maxMin, cfg.autoUpdate ? "true" : "false", ota_sign_pub()[0] ? "true" : "false", wgPub,
      (unsigned long)last.at, last.ok ? "true" : "false", last.files,
      (unsigned long)last.bytes, (unsigned long)last.ms, jsonSafe(last.msg, msg, sizeof(msg)));
  return (len > 0 && (size_t)len < n) ? len : 0;
}

// ---- the card, read a chunk at a time under the logger's lock ---------------
// For HTTPClient's PUT: the logger keeps writing the drive's files meanwhile.
class CardStream : public Stream {
 public:
  CardStream(File &f, uint32_t len, uint8_t *buf) : f_(f), left_(len), buf_(buf) {}
  // What is still to come. -1 once a read failed: HTTPClient's send loop
  // runs while this is > -1, and 0 would keep it waiting.
  int available() override { return failed_ ? -1 : (int)(have_ - pos_ + left_); }
  int read() override { return fill() ? buf_[pos_++] : -1; }
  int peek() override { return fill() ? buf_[pos_] : -1; }
  size_t readBytes(char *out, size_t n) override {
    size_t got = 0;
    while (got < n && fill()) {
      const size_t take = min(n - got, have_ - pos_);
      memcpy(out + got, buf_ + pos_, take);
      pos_ += take;
      got += take;
    }
    return got;
  }
  size_t write(uint8_t) override { return 0; }
  bool failed() const { return failed_; }
 private:
  bool fill() {
    if (pos_ < have_) return true;
    if (!left_ || failed_) return false;
    if (giveWay) { failed_ = true; return false; }   // a file mid-way stops too
    size_t got;
    {
      LoggerSdLock lock(SD_LOCK_WEB_MS);
      if (!lock || logger_card_shared()) { failed_ = true; return false; }
      got = f_.read(buf_, left_ < UP_CHUNK ? left_ : UP_CHUNK);
    }
    // The lock let go, and the turn given away: the logger, and the other
    // upload workers, wait for it at the same priority (listCard's lesson).
    taskYIELD();
    if (!got) { failed_ = true; return false; }
    have_ = got;
    pos_ = 0;
    left_ -= got;
    return true;
  }
  File &f_;
  uint32_t left_;
  uint8_t *buf_;
  size_t have_ = 0, pos_ = 0;
  bool failed_ = false;
};

// The logs: what the gauge writes, by their endings. Not firmware.bin, not
// a folder, nothing a name the server would refuse.
static bool isLog(const char *n) {
  const size_t len = strlen(n);
  if (!len || len > 95 || n[0] == '.') return false;
  for (size_t i = 0; i < len; i++)
    if (!isalnum((unsigned char)n[i]) && n[i] != '_' && n[i] != '.' && n[i] != '-') return false;
  static const char *const ends[] = {".nge", ".csv", ".gpx", ".vbo", ".txt"};
  for (const char *e : ends) {
    const size_t el = strlen(e);
    if (len > el && !strcmp(n + len - el, e)) return true;
  }
  return false;
}

// "name size" per line, into plan; its length, 0 if the card was not there.
static size_t listCard(char *plan, size_t cap, uint16_t *count) {
  size_t n = 0;
  *count = 0;
  File root;
  {
    LoggerSdLock lock(SD_LOCK_WEB_MS);
    if (!lock || !logger_card_ok() || logger_card_shared()) return 0;
    root = SD_MMC.open("/");
  }
  if (!root) return 0;
  // A tick between entries, with the lock let go: the logger waits for it
  // at the same priority on the same core, and a lock given back and taken
  // again at once never let it in - ~230 files of openNextFile() starved it
  // past the watchdog (2026-11-07: "wdt: logger", the upload's resets).
  for (;;) {
    bool more = false;
    {
      LoggerSdLock lock(SD_LOCK_WEB_MS);
      if (!lock) break;
      File e = root.openNextFile();
      if (e) {
        more = true;
        if (!e.isDirectory() && isLog(e.name()) && n + 120 < cap) {
          n += snprintf(plan + n, cap - n, "%s %lu\n", e.name(), (unsigned long)e.size());
          (*count)++;
        }
        e.close();
      }
    }
    if (!more) break;
    vTaskDelay(1);
  }
  LoggerSdLock lock(SD_LOCK_WEB_MS);
  root.close();
  return n;
}

// ---- the upload, on its own task ------------------------------------------
// IDLE -> WAIT_AP (the radio asked for; apTask takes the AP down) -> RUNNING
// (the task has it) -> IDLE once the task says done. Loop-side only, but
// the task's `taskDone`.
enum UpState : uint8_t { UP_IDLE, UP_WAIT_AP, UP_RUNNING };
static UpState state = UP_IDLE;
static volatile bool taskDone = false;
static bool requested = false;
// Per wake: done (uploaded, or stopped by its time limit - the rest goes
// next time), or how many tries failed and when the next may start. A
// failure used to end it for the wake: on 2026-11-07 a try at the door,
// before the phone's hotspot was up, left the drive with none.
static bool doneThisWake = false;
static uint8_t triesFailed = 0;
static uint32_t retryAtMs = 0;

// Where a running upload is, for the status screen (upload_status): set by
// the task as it goes, read by the loop.
enum UpStep : uint8_t { STEP_JOIN, STEP_TUNNEL, STEP_SERVER, STEP_FW, STEP_PLAN, STEP_LOGS, STEP_CLOSE };
static volatile uint8_t step = STEP_JOIN;
static volatile uint32_t fwGot = 0, fwTotal = 0;   // bytes of the firmware download

static void finish(UpResult &r, uint32_t t0, bool ok, const char *msg) {
  r.ok = ok;
  r.ms = millis() - t0;
  r.at = clock_valid() ? (uint32_t)time(nullptr) : 0;
  strlcpy(r.msg, msg, sizeof(r.msg));
}

static void authorise(HTTPClient &http, const UpConfig &c) {
  if (!c.token[0]) return;
  char h[80];
  snprintf(h, sizeof(h), "Bearer %s", c.token);
  http.addHeader("Authorization", h);
}

// ---- the server's address ---------------------------------------------------
// Looked up once per upload, before the tunnel, by public resolvers - not
// the hotspot's. On mobile data (2026-11-07) the carrier's DNS answered the
// server's name with a public address, 1.1.1.1 and 8.8.8.8 with the LAN one
// the home DNS gives: through the tunnel only the LAN one leads to the
// server, so four uploads ended "tunnel up, server not reached". At home,
// on a hotspot sharing the home WiFi, the router answered - and it worked.
// Then each request connects to that address itself and hands HTTPClient
// the open connection with the name: the name still goes as Host (a proxy
// in front of the server routes by it), and no lookup happens inside the
// tunnel. HTTPClient will not take a Host header otherwise.
struct UpServer {
  char host[64];
  char base[48];                      // a path the URL has after the host, or ""
  IPAddress ip;
  uint16_t port;
};
static UpServer server;

// "http://host[:port][/base]" -> server, false if there is no host.
static bool parseServer(const char *url) {
  memset(&server, 0, sizeof(server));
  const char *p = strstr(url, "://");
  p = p ? p + 3 : url;
  size_t n = strcspn(p, ":/");
  if (!n || n >= sizeof(server.host)) return false;
  memcpy(server.host, p, n);
  p += n;
  server.port = 80;
  if (*p == ':') {
    server.port = (uint16_t)atoi(p + 1);
    p += 1 + strcspn(p + 1, "/");
  }
  strlcpy(server.base, p, sizeof(server.base));
  size_t b = strlen(server.base);
  while (b && server.base[b - 1] == '/') server.base[--b] = '\0';
  return server.port != 0;
}

// Through the tunnel, by `dns` - a DNS on the VPN's side (the Upload card's
// "DNS in the tunnel"), which knows the server's LAN address - or by the
// hotspot's DNS where none is set. Not by public resolvers before the
// tunnel (tried 2026-11-07): the router's own name then came out its public
// address, which from inside the home network (a hotspot sharing the home
// WiFi) does not answer - "no handshake from the router".
static bool resolveServer(const char *dns) {
  if (dns[0]) {
    ip_addr_t d;
    if (!ipaddr_aton(dns, &d)) return false;
    LOCK_TCPIP_CORE();
    dns_setserver(0, &d);
    dns_setserver(1, nullptr);
    UNLOCK_TCPIP_CORE();
  }
  return WiFi.hostByName(server.host, server.ip) == 1;
}

static bool isLan(const IPAddress &ip) {
  return ip[0] == 10 || (ip[0] == 192 && ip[1] == 168) || (ip[0] == 172 && (ip[1] & 0xF0) == 16);
}

// A request to the server: the connection to its address, the name as Host.
static bool openRequest(HTTPClient &http, NetworkClient &tcp, const char *path,
                        int32_t connectMs = UP_HTTP_MS) {
  if (!tcp.connect(server.ip, server.port, connectMs)) return false;
  char uri[180];
  snprintf(uri, sizeof(uri), "%s%s", server.base, path);
  http.setReuse(true);
  return http.begin(tcp, server.host, server.port, uri);
}

// POST /plan once: the HTTP code (200: `todo` is the answer), -1 without
// a connection.
static int askPlan(const UpConfig &c, const char *plan, size_t len, String &todo, int32_t connectMs);

// One file's missing bytes [from, size now). 0 on success, else a reason.
static const char *putFile(const UpConfig &c, const char *name, uint32_t from, uint8_t *buf,
                           uint32_t *sent) {
  char path[100];
  snprintf(path, sizeof(path), "/%s", name);
  File f;
  uint32_t size = 0;
  {
    LoggerSdLock lock(SD_LOCK_WEB_MS);
    if (!lock || logger_card_shared()) return "card busy";
    f = SD_MMC.open(path, FILE_READ);
    if (f) size = f.size();
    if (f && from && !f.seek(from)) { f.close(); return "seek failed"; }
  }
  if (!f) return "file gone";
  const char *err = nullptr;
  if (size > from) {
    char path[140];
    snprintf(path, sizeof(path), "/f/%s?offset=%lu", name, (unsigned long)from);
    NetworkClient tcp;
    HTTPClient http;
    http.setConnectTimeout(UP_HTTP_MS);
    http.setTimeout(UP_HTTP_MS);
    CardStream s(f, size - from, buf);
    int code = -1;
    if (openRequest(http, tcp, path)) {
      authorise(http, c);
      http.addHeader("Content-Type", "application/octet-stream");
      code = http.sendRequest("PUT", &s, size - from);
    }
    if (code == 200 && !s.failed()) *sent += size - from;
    else err = code == 409 ? "server holds another size" : s.failed() ? "card read failed" : "PUT failed";
    http.end();
  }
  LoggerSdLock lock(SD_LOCK_WEB_MS);
  f.close();
  return err;
}

// ---- several files at once ----------------------------------------------------
// A TCP connection here keeps at most the stack's send buffer in flight
// (~5.7 KB, fixed in the core's build of lwIP), so its speed is that over
// the round trip: through the tunnel on mobile data ~90 ms, ~64 KB/s -
// measured so, 2026-11-07, against several MB/s from the gauge's own WiFi.
// UP_WORKERS files go at once, each its own connection: that many times
// as much in flight. Each worker takes the next "name offset" line of the
// plan, under a lock, until there are none, the time is up, or one failed.
// Three, not more: five (2026-11-07) took free internal RAM down to 8 KB -
// each connection's own buffers in lwIP - and one PUT failed. The workers'
// stacks are in PSRAM (they read the card and talk to the network, and
// never write flash, the one thing a PSRAM stack must not).
#define UP_WORKERS        3
#define UP_WORKER_STACK   6144

static struct {
  const UpConfig *c;
  const String *todo;
  int from;                           // where the next plan line starts
  uint32_t deadline;                  // millis()
  bool stop;                          // a worker failed: no new files
  uint16_t files;
  uint16_t total;                     // files in the plan: the status screen's n / total
  uint32_t bytes;
  char err[72];                       // the first failure, "name: why"
  uint8_t running;                    // workers not done yet; all of it under lock
  SemaphoreHandle_t lock;
} work;

static uint8_t workersRunning() {
  xSemaphoreTake(work.lock, portMAX_DELAY);
  const uint8_t n = work.running;
  xSemaphoreGive(work.lock);
  return n;
}

// The next file to send, false when there is none (or no more is wanted).
static bool nextFile(char *name, size_t n, uint32_t *offset) {
  xSemaphoreTake(work.lock, portMAX_DELAY);
  bool got = false;
  const String &todo = *work.todo;
  while (!work.stop && !giveWay && !got && work.from < (int)todo.length() &&
         (int32_t)(millis() - work.deadline) < 0) {
    int nl = todo.indexOf('\n', work.from);
    if (nl < 0) nl = todo.length();
    const String l = todo.substring(work.from, nl);
    work.from = nl + 1;
    const int sp = l.indexOf(' ');
    if (sp <= 0 || sp >= (int)n || !isLog(l.substring(0, sp).c_str())) continue;
    strlcpy(name, l.substring(0, sp).c_str(), n);
    *offset = (uint32_t)l.substring(sp + 1).toInt();
    got = true;
  }
  xSemaphoreGive(work.lock);
  return got;
}

static void workerTask(void *) {
  uint8_t *buf = (uint8_t *)heap_caps_malloc(UP_CHUNK, MALLOC_CAP_INTERNAL | MALLOC_CAP_DMA);
  char name[100];
  uint32_t offset;
  while (buf && nextFile(name, sizeof(name), &offset)) {
    uint32_t sent = 0;
    const char *err = putFile(*work.c, name, offset, buf, &sent);
    xSemaphoreTake(work.lock, portMAX_DELAY);
    if (err) {
      if (!work.err[0]) snprintf(work.err, sizeof(work.err), "%s: %s", name, err);
      work.stop = true;
    } else {
      work.files++;
      work.bytes += sent;
    }
    xSemaphoreGive(work.lock);
  }
  free(buf);
  xSemaphoreTake(work.lock, portMAX_DELAY);
  if (!buf && !work.err[0]) {
    strlcpy(work.err, "no memory for a worker", sizeof(work.err));
    work.stop = true;
  }
  work.running = (uint8_t)(work.running - 1);   // under the lock: workers run on either core
  xSemaphoreGive(work.lock);
  // Not deleting itself: its stack is in PSRAM, and vTaskDeleteWithCaps()
  // is to be called from another task - sendAll() does, once it is here.
  vTaskSuspend(nullptr);
}

// The plan's files, UP_WORKERS at a time, until done; into r.
static void sendAll(const UpConfig &c, const String &todo, uint32_t t0, UpResult &r) {
  memset(&work, 0, sizeof(work));
  work.c = &c;
  work.todo = &todo;
  work.deadline = t0 + c.maxMin * 60000UL;
  for (int i = 0; i < (int)todo.length(); i++)
    if (todo[i] == '\n' || i == (int)todo.length() - 1) work.total++;
  step = STEP_LOGS;
  work.lock = xSemaphoreCreateMutex();
  if (!work.lock) { finish(r, t0, false, "no memory"); return; }
  TaskHandle_t worker[UP_WORKERS] = {};
  for (int i = 0; i < UP_WORKERS; i++) {
    xSemaphoreTake(work.lock, portMAX_DELAY);
    work.running = (uint8_t)(work.running + 1);
    xSemaphoreGive(work.lock);
    if (xTaskCreatePinnedToCoreWithCaps(workerTask, "upwork", UP_WORKER_STACK, nullptr, 1, &worker[i],
                                        tskNO_AFFINITY, MALLOC_CAP_SPIRAM | MALLOC_CAP_8BIT) != pdPASS) {
      worker[i] = nullptr;
      xSemaphoreTake(work.lock, portMAX_DELAY);
      work.running = (uint8_t)(work.running - 1);
      xSemaphoreGive(work.lock);
    }
  }
  while (workersRunning()) delay(100);
  // Each has suspended itself (workerTask); deleted from here, stacks freed.
  for (TaskHandle_t h : worker) {
    if (!h) continue;
    while (eTaskGetState(h) != eSuspended) delay(10);
    vTaskDeleteWithCaps(h);
  }
  vSemaphoreDelete(work.lock);
  r.files = work.files;
  r.bytes = work.bytes;
  if (giveWay) finish(r, t0, false, UP_STOPPED);
  else if (work.err[0]) finish(r, t0, false, work.err);
  else if (work.from < (int)todo.length()) finish(r, t0, false, "time limit - the rest goes next time");
  else finish(r, t0, true, "");
}

static int askPlan(const UpConfig &c, const char *plan, size_t len, String &todo, int32_t connectMs) {
  NetworkClient tcp;
  HTTPClient http;
  http.setConnectTimeout(connectMs);
  http.setTimeout(UP_HTTP_MS);
  if (!openRequest(http, tcp, "/plan", connectMs)) return -1;
  authorise(http, c);
  http.addHeader("Content-Type", "text/plain");
  const int code = http.POST((uint8_t *)plan, len);
  if (code == 200) todo = http.getString();
  http.end();
  return code;
}

// ---- a new firmware from the server (2026-11-09) ------------------------------
// After the logs (before them until 2026-11-11), when time is left and the
// Upload card's "Automatic updates" is on (the
// default) and the build has a signing key (ota_sign_pub): the server's
// /fw/latest says which firmware it holds ("<app hash> <size> <build time> <commit>",
// the latest GitHub release's, passed through by the server). One built after this one (no downgrade to an
// older signed release), not tried before, is downloaded to OTA_SD_NEW,
// checked against its signature and only then renamed to OTA_SD_PATH -
// where ota_check_sd() installs it, before the next sleep (power.cpp) or at
// the next boot, with the usual probation and rollback. Nothing here ever
// fails the upload: the logs go either way.
// The signature (/fw/sig, 64 bytes): standard Ed25519 (RFC 8032 - what
// minisign, signify, OpenSSL and Python make) over 40 bytes: the image's
// SHA-256, then its build time as 8 bytes little-endian. The build time is
// signed, so a server cannot pass an old release off as a new one.
static bool fwStaged = false;           // OTA_SD_PATH holds a checked one, this wake
static uint8_t fwStagedHash[32];
static char fwStagedName[16];           // its commit, as the status screen says it

bool upload_fw_staged() { return fwStaged; }

static bool unhex(const char *s, uint8_t *out, size_t n) {
  for (size_t i = 0; i < n; i++) {
    unsigned v;
    if (!isxdigit((unsigned char)s[2 * i]) || !isxdigit((unsigned char)s[2 * i + 1]) ||
        sscanf(s + 2 * i, "%2x", &v) != 1) return false;
    out[i] = (uint8_t)v;
  }
  return true;
}

// GET a small answer (at most n bytes) into out: the HTTP code, -1 without
// a connection; *len what came - short of the whole answer, 0.
static int getSmall(const UpConfig &c, const char *path, uint8_t *out, size_t n, size_t *len) {
  NetworkClient tcp;
  HTTPClient http;
  http.setConnectTimeout(UP_HTTP_MS);
  http.setTimeout(UP_HTTP_MS);
  *len = 0;
  if (!openRequest(http, tcp, path)) return -1;
  authorise(http, c);
  const int code = http.GET();
  const int size = http.getSize();
  if (code == 200 && size > 0 && (size_t)size <= n &&
      http.getStreamPtr()->readBytes(out, size) == (size_t)size) *len = size;
  http.end();
  return code;
}

// /fw/bin into OTA_SD_NEW, `size` bytes, its SHA-256 into digest: "" or a reason.
// A download cut off goes on next time from where it stopped (asked
// 2026-11-11): the garage's mobile signal cut two in a row, and each try
// started the 2 MB over. OTA_SD_NEW stays on the card, and NVS "fwPart"
// says which release it is of - another release, and it starts over.
// The upload's time limit, for the download (millis()): it comes after the
// logs, with what time they left; stopped there, it goes on next time.
static uint32_t fwDeadlineMs = 0;

static bool partOf(const uint8_t hash[32]) {
  uint8_t h[32];
  Preferences p;
  if (!p.begin(NS, true)) return false;
  const bool is = p.getBytes("fwPart", h, sizeof(h)) == sizeof(h) && !memcmp(h, hash, 32);
  p.end();
  return is;
}

static void setPart(const uint8_t *hash) {   // nullptr: none
  Preferences p;
  if (!p.begin(NS, false)) return;
  if (hash) p.putBytes("fwPart", hash, 32);
  else      p.remove("fwPart");
  p.end();
}

// /fw/bin into OTA_SD_NEW, `size` bytes, its SHA-256 into digest: "" or a
// reason. What the card already holds of this release is read back into the
// hash - the signature is over the whole image - and only the rest asked for
// (Range); *from says how much that was.
static const char *downloadFirmware(const UpConfig &c, uint32_t size, uint8_t *buf, uint8_t digest[32],
                                    const uint8_t hash[32], uint32_t *from) {
  mbedtls_sha256_context sha;
  mbedtls_sha256_init(&sha);
  mbedtls_sha256_starts(&sha, 0);
  File f;
  uint32_t had = 0;
  {
    LoggerSdLock lock(SD_LOCK_WEB_MS);
    if (!lock || logger_card_shared()) { mbedtls_sha256_free(&sha); return "card busy"; }
    if (partOf(hash) && SD_MMC.exists(OTA_SD_NEW)) {
      f = SD_MMC.open(OTA_SD_NEW, FILE_READ);
      had = f ? f.size() : 0;
    }
  }
  if (had > size) had = 0;              // not this image after all
  for (uint32_t left = had; left;) {
    size_t got = 0;
    {
      LoggerSdLock lock(SD_LOCK_WEB_MS);
      if (lock && !logger_card_shared()) got = f.read(buf, left < UP_CHUNK ? left : UP_CHUNK);
    }
    if (!got) {                         // unreadable: from the start
      had = 0;
      mbedtls_sha256_starts(&sha, 0);
      break;
    }
    mbedtls_sha256_update(&sha, buf, got);
    left -= got;
    taskYIELD();
  }
  {
    LoggerSdLock lock(SD_LOCK_WEB_MS);
    if (f) f.close();
    if (lock && !logger_card_shared()) {
      if (!had) SD_MMC.remove(OTA_SD_NEW);
      f = SD_MMC.open(OTA_SD_NEW, had ? FILE_APPEND : FILE_WRITE);
    }
  }
  *from = had;
  fwGot = had;
  if (!f) { mbedtls_sha256_free(&sha); return "card not writable"; }
  setPart(hash);
  if (had == size) {                    // all there already: only the signature was missing
    mbedtls_sha256_finish(&sha, digest);
    mbedtls_sha256_free(&sha);
    LoggerSdLock lock(SD_LOCK_WEB_MS);
    f.close();
    return "";
  }
  NetworkClient tcp;
  HTTPClient http;
  http.setConnectTimeout(UP_HTTP_MS);
  http.setTimeout(UP_HTTP_MS);
  const char *err = "";
  uint32_t got = had;
  if (!openRequest(http, tcp, "/fw/bin")) {
    err = "server not reached";
  } else {
    authorise(http, c);
    if (had) {
      char range[32];
      snprintf(range, sizeof(range), "bytes=%lu-", (unsigned long)had);
      http.addHeader("Range", range);
    }
    const int code = http.GET();
    if (code != (had ? 206 : 200)) err = "download refused";
    else if (http.getSize() != (int)(size - had)) err = "the server's size differs";
    else {
      NetworkClient *s = http.getStreamPtr();
      uint32_t lastData = millis();
      while (got < size && millis() - lastData < UP_HTTP_MS) {
        if ((int32_t)(millis() - fwDeadlineMs) >= 0) { err = "time limit"; break; }
        if (giveWay) { err = UP_STOPPED; break; }
        const int avail = s->available();
        if (avail <= 0) {
          if (!s->connected()) break;
          delay(5);
          continue;
        }
        uint32_t want = size - got;
        if (want > (uint32_t)avail) want = avail;
        if (want > UP_CHUNK) want = UP_CHUNK;
        const int n = s->read(buf, want);
        if (n <= 0) continue;
        mbedtls_sha256_update(&sha, buf, n);
        {
          LoggerSdLock lock(SD_LOCK_WEB_MS);
          if (!lock || logger_card_shared() || f.write(buf, n) != (size_t)n) { err = "card write failed"; break; }
        }
        got += n;
        fwGot = got;
        lastData = millis();
        taskYIELD();                    // the logger has the card next
      }
      if (!err[0] && got != size) err = "download cut short";
    }
    http.end();
  }
  mbedtls_sha256_finish(&sha, digest);
  mbedtls_sha256_free(&sha);
  LoggerSdLock lock(SD_LOCK_WEB_MS);
  f.close();
  // Cut short, it stays for next time. Refused, or of another size: what
  // the card holds is no good - from the start then.
  if (err[0] && strcmp(err, "download cut short") && strcmp(err, "server not reached") &&
      strcmp(err, "card write failed") && strcmp(err, "time limit") && strcmp(err, UP_STOPPED)) {
    SD_MMC.remove(OTA_SD_NEW);
    setPart(nullptr);
  }
  return err;
}

// The whole step: a few words for the result line in note, "" when there
// was nothing new.
static void fetchFirmware(const UpConfig &c, uint8_t *buf, char *note, size_t n) {
  note[0] = '\0';
  const char *pubHex = ota_sign_pub();
  uint8_t pub[32];
  if (!c.autoUpdate || strlen(pubHex) != 64 || !unhex(pubHex, pub, 32)) return;

  char latest[100];
  size_t len = 0;
  const int code = getSmall(c, "/fw/latest", (uint8_t *)latest, sizeof(latest) - 1, &len);
  if (code == 404) return;              // the server holds none
  latest[len] = '\0';
  uint8_t hash[32];
  char *rest = nullptr;
  const unsigned long size = len > 65 ? strtoul(latest + 65, &rest, 10) : 0;
  char *after = nullptr;
  const unsigned long long built = rest ? strtoull(rest, &after, 10) : 0;
  if (code != 200 || len < 66 || latest[64] != ' ' || !unhex(latest, hash, 32) || !size || !built) {
    snprintf(note, n, "firmware check failed (%d)", code);
    return;
  }
  // What it is called where people see it: its git commit, the fourth
  // field (release-fw.py since 2026-11-11) - the same as the build stamp
  // the gauge's settings show. Without one, the image hash's first digits.
  char name[16];
  if (!after || sscanf(after, " %15s", name) != 1) {
    memcpy(name, latest, 8);
    name[8] = '\0';
  }

  // Not the one running, nor one handled before: installed and rolled back
  // (ota.cpp's "seen" - put there before each install), refused here
  // (a bad signature, "fwBad"), or downloaded already this wake.
  if (!memcmp(hash, esp_app_get_description()->app_elf_sha256, 32)) return;
  if (built <= ota_build_time()) return;  // older: this one is newer (a USB build, say)
  if (fwStaged && !memcmp(hash, fwStagedHash, 32)) return;
  uint8_t seen[32];
  Preferences p;
  if (p.begin("ota", true)) {
    const bool tried = p.getBytes("seen", seen, sizeof(seen)) == sizeof(seen) && !memcmp(seen, hash, 32);
    p.end();
    if (tried) return;
  }
  if (p.begin(NS, true)) {
    const bool bad = p.getBytes("fwBad", seen, sizeof(seen)) == sizeof(seen) && !memcmp(seen, hash, 32);
    p.end();
    if (bad) return;
  }
  const esp_partition_t *slot = esp_ota_get_next_update_partition(nullptr);
  if (!slot || size > slot->size) {
    snprintf(note, n, "firmware %s too big", name);
    return;
  }

  const uint32_t t = millis();
  fwGot = 0;
  fwTotal = size;
  step = STEP_FW;
  uint8_t signedMsg[40], sig[64];       // the image's SHA-256, its build time
  uint32_t from = 0;                    // already on the card from an earlier try
  const char *err = downloadFirmware(c, size, buf, signedMsg, hash, &from);
  for (int i = 0; i < 8; i++) signedMsg[32 + i] = (uint8_t)(built >> (8 * i));
  if (!err[0]) {
    if (getSmall(c, "/fw/sig", sig, sizeof(sig), &len) != 200 || len != sizeof(sig)) {
      err = "no signature";             // the image stays: next time only this
    } else if (crypto_ed25519_check(sig, pub, signedMsg, sizeof(signedMsg)) != 0) {
      err = "bad signature";
      if (p.begin(NS, false)) {         // not downloaded again: only a new release
        p.putBytes("fwBad", hash, sizeof(hash));
        p.end();
      }
      setPart(nullptr);
      LoggerSdLock lock(SD_LOCK_WEB_MS);
      SD_MMC.remove(OTA_SD_NEW);
    }
  }
  if (!err[0]) {
    LoggerSdLock lock(SD_LOCK_WEB_MS);
    if (!lock || logger_card_shared()) err = "card busy";
    else {
      SD_MMC.remove(OTA_SD_PATH);
      if (!SD_MMC.rename(OTA_SD_NEW, OTA_SD_PATH)) err = "card rename failed";
      else setPart(nullptr);
    }
  }
  if (err[0]) {
    snprintf(note, n, "firmware %s: %s (%lu of %lu KB)", name, err,
             (unsigned long)(fwGot / 1024), size / 1024);
  } else {
    fwStaged = true;
    memcpy(fwStagedHash, hash, sizeof(hash));
    strlcpy(fwStagedName, name, sizeof(fwStagedName));
    snprintf(note, n, "firmware %s ready (%lu KB in %lu s%s)", name, (size - from) / 1024,
             (unsigned long)(millis() - t) / 1000, from ? ", resumed" : "");
  }
  Serial.printf("[..] upload: %s\n", note);
}

// The hotspot's interface down in lwIP, by hand, before the radio stops.
// 2026-11-14 16:40 the gauge crashed ~30 s after an upload's close
// (InstrFetchProhibited, pc 0): lwIP's ARP timer re-asked for the router
// through the station interface (etharp_tmr -> etharp_request ->
// low_level_output) whose WiFi driver was already gone. Stopped this
// quickly, the driver can go before lwIP takes the interface down; an ARP
// entry in use is re-asked shortly before it expires, so it strikes only
// now and then. Down, the interface's ARP entries are cleared with it
// (netif_set_down: etharp_cleanup_netif), and nothing is left to re-ask.
// The station is brought up again by the next connect, as always.
static void staNetifDown() {
  esp_netif_t *sta = esp_netif_get_handle_from_ifkey("WIFI_STA_DEF");
  struct netif *n = sta ? (struct netif *)esp_netif_get_netif_impl(sta) : nullptr;
  if (!n) return;
  LOCK_TCPIP_CORE();
  netif_set_link_down(n);
  netif_set_down(n);
  UNLOCK_TCPIP_CORE();
}

static void uploadTask(void *arg) {
  UpConfig &c = *(UpConfig *)arg;
  UpResult r = {};
  const uint32_t t0 = millis();
  char line[224];
  uint8_t *buf = (uint8_t *)heap_caps_malloc(UP_CHUNK, MALLOC_CAP_INTERNAL | MALLOC_CAP_DMA);
  char *plan = (char *)heap_caps_malloc(UP_PLAN_MAX, MALLOC_CAP_SPIRAM);
  WireGuard wg;
  bool wgUp = false;
  size_t planLen = 0;
  uint16_t onCard = 0;
  String todo;
  char fwNote[80] = "";

  step = STEP_JOIN;
  if (!buf || !plan) { finish(r, t0, false, "no memory"); goto out; }

  // Its name in the phone's hotspot list (asked 2026-11-11), not the
  // ESP32's "esp32s3-xxxxxx": DHCP sends it as it joins. Set before the
  // interface starts - after, it is not used until the next start.
  WiFi.setHostname(WIFI_STA_HOSTNAME);
  WiFi.mode(WIFI_STA);
  WiFi.begin(c.ssid, c.pass);
  while (WiFi.status() != WL_CONNECTED && millis() - t0 < UP_JOIN_MS && !giveWay) delay(250);
  if (giveWay) { finish(r, t0, false, UP_STOPPED); goto out; }
  if (WiFi.status() != WL_CONNECTED) { finish(r, t0, false, "no hotspot"); goto out; }
  Serial.printf("[..] upload: joined the hotspot in %lu ms, RSSI %d\n",
                (unsigned long)(millis() - t0), WiFi.RSSI());
  // The server's name is looked up through the tunnel, once it is up
  // (resolveServer); here only taken apart.
  if (!parseServer(c.url)) { finish(r, t0, false, "the server address is not a URL"); goto out; }

  // (The clock is valid: upload_task() starts none without - the handshake
  // carries a timestamp the router checks.)

  planLen = listCard(plan, UP_PLAN_MAX, &onCard);
  if (!planLen) { finish(r, t0, false, "card not readable"); goto out; }

  // Always through the tunnel (decided 2026-11-07): the hotspot is the
  // phone's mobile data - the garage has no WiFi. A first try straight at
  // the server, for a hotspot sharing the home WiFi, only ever helped on
  // the bench, and cost each real upload a lookup and up to 3 s. (From
  // inside the home network the router's public address, the tunnel's
  // endpoint, does not answer: "no handshake from the router".)
  {
    {
      IPAddress addr;
      addr.fromString(c.wgAddr);
      char priv[45];
      b64(priv, sizeof(priv), c.wgPriv, sizeof(c.wgPriv));
      Serial.println(F("[..] upload: starting the tunnel"));
      step = STEP_TUNNEL;
      wgUp = wg.begin(addr, priv, c.wgHost, c.wgPeer, c.wgPort);
      memset(priv, 0, sizeof(priv));
    }
    if (!wgUp) { finish(r, t0, false, "tunnel did not start"); goto out; }
    Serial.printf("[..] upload: tunnel up, %u B internal free\n",
                  (unsigned)heap_caps_get_free_size(MALLOC_CAP_INTERNAL | MALLOC_CAP_8BIT));

    // The server's address, through the tunnel: tried until the handshake
    // has been done and the DNS answers. Which kind it is (not the
    // address) on the console.
    {
      step = STEP_SERVER;
      const uint32_t td = millis();
      bool resolved = false;
      while (!giveWay && !(resolved = resolveServer(c.wgDns)) && millis() - td < UP_HANDSHAKE_MS) delay(1000);
      if (giveWay) { finish(r, t0, false, UP_STOPPED); goto out; }
      if (!resolved) {
        finish(r, t0, false, wg.is_peer_up() ? "the server's name did not resolve" : "no handshake from the router");
        goto out;
      }
      Serial.printf("[..] upload: the server's name resolved to a %s address in %lu ms\n",
                    isLan(server.ip) ? "private" : "public", (unsigned long)(millis() - td));
    }
  }

  {
    // Through the tunnel the first request may wait for the handshake:
    // tried until it answers.
    step = STEP_PLAN;
    const uint32_t tw = millis();
    int code = -1;
    while (millis() - tw < UP_HANDSHAKE_MS && !giveWay) {
      code = askPlan(c, plan, planLen, todo, 5000);
      Serial.printf("[..] upload: %u logs on the card, the server through the tunnel -> %d after %lu ms\n",
                    onCard, code, (unsigned long)(millis() - tw));
      if (code > 0) break;
      delay(2000);
    }
    if (giveWay) { finish(r, t0, false, UP_STOPPED); goto out; }
    if (code != 200) {
      // No answer at all: did the router even do the handshake? Four
      // "server not reached" in a row (2026-11-07, hotspot on mobile data)
      // could not say which end it was.
      snprintf(line, sizeof(line), code == 401 ? "server refused the token"
                                   : code > 0  ? "plan answered %d"
                                   : wg.is_peer_up() ? "tunnel up, server not reached"
                                                     : "no handshake from the router", code);
      finish(r, t0, false, line);
      goto out;
    }
  }

  // "name offset" per line: each file's missing part, several at once.
  // Out of time only with files still to go - the next upload sends them.
  sendAll(c, todo, t0, r);

  // Then a new firmware, with the time the logs left (2026-11-11 - first
  // until then): a download the garage's mobile signal cut off took the
  // logs with it. Cut off now, it goes on from there next time.
  if (r.ok && !giveWay) {
    fwDeadlineMs = t0 + c.maxMin * 60000UL;
    fetchFirmware(c, buf, fwNote, sizeof(fwNote));
  }

out:
  step = STEP_CLOSE;
  Serial.printf("[..] upload: closing (%s)\n", r.ok ? "done" : r.msg);
  if (wgUp) wg.end();
  Serial.println(F("[..] upload: tunnel closed"));
  staNetifDown();
  WiFi.disconnect(true);
  Serial.println(F("[..] upload: hotspot left"));
  WiFi.mode(WIFI_OFF);
  Serial.println(F("[..] upload: radio off"));
  free(buf);
  free(plan);
  snprintf(line, sizeof(line), "upload: %s - %u files, %lu KB in %lu ms (%u logs on the card)%s%s",
           r.ok ? "done" : r.msg, r.files, (unsigned long)(r.bytes / 1024), (unsigned long)r.ms,
           onCard, fwNote[0] ? "; " : "", fwNote);
  Serial.println(line);
  // A few tries: the card may be busy a moment (logger_note_boot).
  for (int i = 0; i < 5 && !logger_note_boot(line); i++) delay(2000);
  last = r;
  taskDone = true;
  vTaskDelete(nullptr);
}

// ---- when ------------------------------------------------------------------
void upload_now() {
  requested = true;
  doneThisWake = false;
  triesFailed = 0;
  retryAtMs = 0;
}

uint8_t upload_last_close_step() { return endStepSeen; }

void upload_give_way(bool yes) { giveWay = yes; }

bool upload_holds_radio() { return state != UP_IDLE; }
bool upload_busy() { return state != UP_IDLE; }
bool upload_configured() { return configured(); }

// ---- the status screen -------------------------------------------------------
void upload_status(UpStatus *s) {
  memset(s, 0, sizeof(*s));
  if (last.at || last.msg[0]) {
    char when[8] = "";
    if (last.at) {
      const time_t t = last.at;
      struct tm tm;
      localtime_r(&t, &tm);
      strftime(when, sizeof(when), "%H:%M", &tm);
    }
    if (last.ok)
      snprintf(s->last, sizeof(s->last), "last %s: %u files, %lu KB", when, last.files,
               (unsigned long)(last.bytes / 1024));
    else
      snprintf(s->last, sizeof(s->last), "last %s: %s", when, last.msg);
  }
  if (fwStaged)
    snprintf(s->fw, sizeof(s->fw), "firmware %s ready - installs when parked", fwStagedName);

  const auto say = [s](uint8_t tone, const char *head, const char *detail) {
    s->tone = tone;
    strlcpy(s->head, head, sizeof(s->head));
    strlcpy(s->detail, detail, sizeof(s->detail));
  };
  if (!configured()) return say(0, "Not set up", "the app's Home server card");
  if (afterCrash) return say(3, "Off", "this wake began with a crash");
  if (giveWay && state == UP_IDLE) return say(0, "Waiting", "the gauge's WiFi is in use");
  if (state == UP_WAIT_AP) return say(1, "Starting", "the gauge's WiFi goes off for it");
  if (state == UP_RUNNING) {
    char d[64];
    switch (step) {
      case STEP_JOIN:   strlcpy(d, "joining the phone's hotspot", sizeof(d)); break;
      case STEP_TUNNEL: strlcpy(d, "opening the VPN", sizeof(d)); break;
      case STEP_SERVER: strlcpy(d, "finding the server", sizeof(d)); break;
      case STEP_FW:
        snprintf(d, sizeof(d), "new firmware %lu of %lu KB", (unsigned long)(fwGot / 1024),
                 (unsigned long)(fwTotal / 1024));
        break;
      case STEP_PLAN:   strlcpy(d, "asking what the server lacks", sizeof(d)); break;
      case STEP_LOGS:
        snprintf(d, sizeof(d), "logs %u of %u, %lu KB", work.files, work.total,
                 (unsigned long)(work.bytes / 1024));
        break;
      default:          strlcpy(d, "closing", sizeof(d)); break;
    }
    return say(1, "Uploading", d);
  }
  const bool timeUp = !strncmp(last.msg, "time limit", 10);
  if (doneThisWake) {
    if (last.ok || timeUp) return say(2, "Done", timeUp ? "the rest goes next time" : "until the next drive");
    return say(3, "Failed", "again on the next drive");
  }
  if (triesFailed) {
    char d[64];
    const int32_t left = (int32_t)(retryAtMs - millis());
    snprintf(d, sizeof(d), "again in %ld s", (long)(left > 0 ? left / 1000 : 0));
    return say(3, "Failed", d);
  }
  say(0, "Waiting",
      podstate().car != PS_CAR_RUNNING          ? "for the engine"
      : !clock_valid()                          ? "for the clock (the first GPS fix)"
      : !logger_card_ok() || logger_card_shared() ? "for the card"
      : web_clients() > 0                       ? "a phone is on the gauge's WiFi"
                                                : "about to start");
}

void upload_task(uint32_t now) {
  static UpConfig taskCfg;            // the task's copy: /save may change cfg
  static bool stepSaid = false;       // kept for the boot line (upload_last_close_step)
  if (endStepSeen && !stepSaid && now > 10000) {
    stepSaid = true;
    Serial.printf("[..] upload: the last tunnel close reached step %u of 6\n", endStepSeen);
  }
  if (state == UP_RUNNING) {
    if (!taskDone) return;
    state = UP_IDLE;                  // the radio goes back to the AP
    saveLast();                       // for the app, after the gauge has slept
    if (!strcmp(last.msg, UP_STOPPED)) {
      // Not a failed try: the gauge's WiFi was wanted. Again once it is not
      // (upload_give_way), a minute on.
      retryAtMs = now + UP_RETRY_MS;
      if (!triesFailed) triesFailed = 1;   // so the retry time holds
      Serial.println(F("[..] upload: stopped for the gauge's WiFi"));
    } else if (last.ok || !strncmp(last.msg, "time limit", 10)) {
      doneThisWake = true;
    } else if (++triesFailed >= UP_TRIES) {
      doneThisWake = true;
      Serial.printf("[..] upload: %u tries failed - not again this wake\n", triesFailed);
    } else {
      retryAtMs = now + UP_RETRY_MS;
      Serial.printf("[..] upload: failed (%s) - again in %u s\n", last.msg, UP_RETRY_MS / 1000);
    }
    return;
  }
  if (state == UP_WAIT_AP) {
    if (giveWay) { state = UP_IDLE; return; }   // asked for the WiFi meanwhile: not now
    if (web_is_up()) return;          // apTask takes it down: it sees the hold
    taskCfg = cfg;
    taskDone = false;
    state = UP_RUNNING;
    if (xTaskCreatePinnedToCore(uploadTask, "upload", UP_TASK_STACK, &taskCfg, 1, nullptr, 0) != pdPASS) {
      state = UP_IDLE;
      Serial.println(F("[ERR] upload: no task"));
    }
    return;
  }
  if (doneThisWake || afterCrash) return;
  if (giveWay && !requested) return;    // the gauge's WiFi first
  if (triesFailed && (int32_t)(now - retryAtMs) < 0 && !requested) return;
  // The engine running, a valid clock, the card in and the gauge's own, and
  // nobody on the AP. Or the bench says now - and is told what stops it, once.
  // The clock: the handshake carries a timestamp the router checks. Waited
  // for (the GNSS's first fix, in the car), not fetched: NTP over the
  // hotspot right after the car started failed, and the retry five minutes
  // later reset the gauge mid-drive (2026-11-08). A wait for it is no try.
  // The engine, not just the car talking (2026-11-07): a door opened wakes
  // the bus too, long before the phone joins the car's Bluetooth and turns
  // its hotspot on - each such try held the AP down a minute for nothing.
  const bool running = podstate().car == PS_CAR_RUNNING;
  if (!running && !requested) return;
  const char *why = !configured()                          ? "not set up (the app's Upload card)"
                    : !clock_valid()                        ? "no clock yet (the GNSS's first fix)"
                    : !logger_card_ok() || logger_card_shared() ? "no card, or it is lent to a PC"
                    : web_clients() > 0                     ? "a phone is on the gauge's WiFi"
                                                            : nullptr;
  if (why) {
    if (requested) Serial.printf("[..] upload: not now - %s\n", why);
    requested = false;
    return;
  }
  requested = false;
  state = UP_WAIT_AP;
  Serial.println(F("[..] upload: the engine runs - the radio is the upload's"));
}
