kubiq/n-gauge/(commit log)

2026-10-11 N Gauge: an OBD gauge for the Hyundai i30 N, with its phone app
    A round AMOLED gauge in the driver-side vent, reading the car over the
    OBD-II port's CAN bus: oil temperature, coolant, boost, tyres, a g-meter,
    GPS and a lap timer, logging every drive to SD. An Android app syncs the
    logs and shows each drive on a map; an optional backend stores them.
    - firmware/car_gauge_v1: ESP32-S3 (Waveshare 1.75" AMOLED), Arduino + LVGL
    - mobile: the Android app (Expo)
    - backend: a small log store (Node, Docker)
    - hardware, mechanical: the carrier PCB and the printed vent pod
    - DECISIONS.md: why things are the way they are
    History before this commit was development on one car and is not
    published.
2026-10-11 gitignore: keep data/ and new pod STLs local
    The repo is public: pictures and scratch files dropped into data/, and
    new or work-in-progress STL exports in mechanical/pod/, are ignored so a
    git add -A cannot publish them. Tracked files are unaffected; a new one
    goes in with git add -f, deliberately.
2026-10-11 App: share a drive's GPX to other apps; pulls continue over a GPX's tail
    "Share the track (GPX)" on a trip's screen opens Android's share sheet
    (expo-sharing) with a cleaned copy of the track: only whole trkpt lines
    and one closing tail (cleanGpx, tested). The inbox file itself is never
    handed out.
    Found on the way: the pod keeps a GPX valid by writing its closing tags
    after every batch and seeking back over them for the next. A GPX the phone
    pulled while it was still being written, and then continued from that
    size, kept the old tags in the middle and a trackpoint cut short after
    them - invalid XML for other apps. pull() now continues 22 bytes earlier,
    over the tail, writing in place; clea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
2026-10-11 App: stack screens keep clear of Android's navigation buttons
    The app draws edge to edge, and the trip, server and scan screens have no
    tab bar under them, so their last card ran under the navigation buttons.
    Screen's underHeader now adds the bottom inset as scroll padding (content
    still scrolls behind the transparent bar, but its end stops above it); the
    scan screen's floating hint moves up by the inset, and its permission
    prompt no longer adds a second top inset under the header.
2026-10-11 Log encryption, part 1: the format, the pod's writer, the app's reader
    Not wired into the logger yet. Design in DECISIONS.md.
    - firmware/car_gauge_v1/logcrypt.h: the encrypted log format, pure (no
    Arduino, no RNG). A file is type|length|body blocks: a header per segment
    (magic, version, the ephemeral X25519 public key) and XChaCha20-Poly1305
    records, nonce = record index, AD = the header. Segment key =
    BLAKE2b-256(X25519 shared | eph_pub | recipient_pub | "n-gauge log v1");
    the ephemeral secret is wiped inside logcrypt_begin(). Plus a reader for
    the tests, and a 12-hex-digit key fingerprint.
    - Monocypher 4.0.2 vendored (BSD-2/CC0): the core's prebuilt mbedTLS has
    ChaCha20/Poly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
2026-10-11 Log encryption, part 2: the pod writes encrypted logs once it has a key
    - settings: logKey + logPub (NVS blob); settings_set_log_key() takes 64 hex
    digits (calc_parse_hex, tested) or "off". /save accepts logPub, under the
    SD lock so no file opens on a half-copied key; /api/settings reports the
    key's fingerprint as logKey; the Device page shows it.
    - logger: the CSV, the GPX and the .vbo go through a Sink - plain as before
    with no key, otherwise a segment header at open (and at reopen: the
    rename-to-dated path) and one sealed record per batch. The CSV is now
    staged in 4 KB and written on each 2 s flush, so a flush is one record.
    Headers (CSV, GPX, VBO) go through the same path.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
2026-10-11 Log encryption, part 3: the app's key, the pod's key, reading .nge logs
    - logkey.ts: this phone's X25519 key - created from expo-crypto's secure
    random source, kept in SecureStore, exported as one line
    ("ngauge-log-key-v1:<hex>") for KeePass and imported back. Copying clears
    the clipboard after a minute, as Android cannot be told it is sensitive.
    - A "Log encryption" screen: create / copy / import the key (with a warning
    before replacing one), and - connected - the pod's state compared by
    fingerprint (not encrypted / to this phone / to another key), "Encrypt
    the pod's logs with this key" and "Stop encrypting" (setPodLogKey ->
    /save logPub). A card on the Pod screen leads there,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
2026-10-11 App: the Log encryption card shows what the pod does while connected
    "Pod: encrypted to this phone / not encrypted / encrypted to another key",
    compared by fingerprint, on the Pod screen itself - before, it was only on
    the Log encryption screen. Re-read on connecting and on every return.
    One key per phone stays the model: the private key is the phone's, and any
    number of pods can be given its public half.
2026-10-12 README: photos of the pod in the car
    Three, resized to 1600 px and stripped of all metadata: the pod lit (oil
    and coolant on a cold engine) as the header, the driver's view beside the
    cluster, and the pod switched off.
2026-10-12 App: a header with a ⋮ menu on every screen; Settings always there
    - OverflowMenu: the native Material dropdown (@expo/ui jetpack-compose)
    behind a ⋮ icon (Material "more_vert" as a vector drawable), in the
    header. The tab screens now have headers (title + menu).
    - The rarer actions moved into it: Trips "Save all to a folder" (was a
    button above the list); a drive's share GPX / share CSV / save to a
    folder (were buttons in its Files card); Pod "Scan a different pod".
    - Settings is always visible: this phone's log encryption at the top (the
    key is needed off the pod's WiFi too), the pod's settings and firmware
    below when connected. The Log encryption card left the Pod screen.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
2026-10-12 Laps: find the start/finish line by itself (loop closure)
    SET meant stopping on the line, which is not possible on a real track,
    and starting from the pit made the first "lap" the drive out of it.
    Now START is tapped once, parked anywhere, and nothing while driving.
    loopfind.h drops a breadcrumb every 10 m (PSRAM, 96 KB, ~40 km before
    giving up). Once 500 m are driven, a new crumb within 20 m of an older
    one and heading the same way (30 deg) closes the loop: that crumb is the
    gate, across its heading, and lap 1 is timed from when the car first
    passed it. The pit exit is never driven again, so it never matches; the
    heading test and the minimum length keep figure-8 crossovers, U-turns
    and out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
2026-10-12 USB drive: share the SD card read-only
    Even with nothing copied, the PC writes to a mounted FAT card: the
    "in use" flag at mount and unmount, and access dates of the files a file
    manager previews. Over the pod's USB drive those writes made unmounting
    slow (the desktop warned it was still writing), never all landed (every
    mount logged "Volume was not properly unmounted"), and on 2026-10-12 an
    eject ended in a reset loop: the PC's next read of sector 0 went
    unanswered, and its SCSI error handling reset the USB device - and with
    it the pod - every ~9 s for five minutes until it gave up.
    Write-protected, the PC mounts the card read-only and writes nothing.
    Deleting logs stays with the app and t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
2026-10-13 USB drive: answer reads with "medium not present", not "busy"
    The reset loop after ejecting the shared card (2026-10-12 23:40, and
    again on 10-13 with the drive read-only, so PC writes were never the
    cause): the core's USBMSC answers a READ while the medium is absent
    with 0, which TinyUSB defines as "busy, call again with the same
    parameters". A read from the PC arriving after an eject had cleared
    the medium - the kernel's partition scan of sector 0 - was retried
    forever. The spin starved loop() into the 8 s watchdog, the pod came
    back with the medium still absent, the PC's retried read spun again,
    and the PC reset the device every ~9 s until its SCSI layer gave up.
    It depended on whether th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
2026-10-13 App: the pod's connection and sync in every tab's header
    Like Garmin Connect shows its watch: a chip left of the ⋮ with the
    pod's round face as a ring - grey not connected, green connected, red
    when the last sync failed, a spinner while connecting or syncing - and
    two short lines: the connection, then "Checking…", "Syncing 2/5" or
    "Synced 14:02". A tap connects, or, connected, opens the Pod tab where
    Disconnect is.
    The sync provider now exposes the file being pulled of how many, and
    when a sync last left nothing to pull - kept in last-sync.txt, so the
    chip says how long ago the phone last synced while away from the pod.
    HeaderActions (the chip, then the ⋮ menu) is every tab's default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
2026-10-13 App: tabs are the phone's features; the gauge opens from the header
    Tabs are now Trips (first) and Settings. Everything about the gauge -
    connection and first-time QR scan, the log sync, live data, the clock
    and g-meter actions - is one Gauge screen, opened by tapping the gauge
    in any header, which also connects when not connected. The Sync tab
    and its "off the gauge's network, back to Pod" redirect are gone; the
    screen syncs on each visit as the tab did.
    And the app calls it the gauge, not the pod, wherever it is shown:
    titles, buttons, notes, errors, the native WiFi module's message. Code
    names (usePod, pod.ts, the firmware) stay.
2026-10-13 App: no tabs - Trips is the app, Settings in its ⋮ menu
    With the gauge moved to the header, the tabs were down to Trips and
    Settings. Trips is now the one main screen; its ⋮ menu holds Settings
    and "Save all to a folder", and the header the gauge, as before.
    Settings is a stack screen with the gauge in its header too, since its
    gauge half needs the connection.
    Screen loses its tabBar option: every screen now clears Android's
    navigation buttons itself.
2026-10-13 README: new app screenshots - no tabs, the gauge in the header
    The old set showed the Pod and Sync tabs. The new one (2026-10-13):
    Trips with the gauge in the header and its ⋮ menu, a drive's map (the
    10.10. 17:47 drive, replacing the 11.10. 15:03 one), the Gauge screen
    connected and synced, and Settings connected. The upload server shot
    goes: the feature is switched off.
    mobile/README describes the app as it is now - the screens, the sync
    on every connect, pairing by session - and says gauge, as the app
    does. The top README's feature list gains the self-finding lap line.
2026-10-13 App: a lock on encrypted trips in the list
    A Trips row whose GPX or CSV is encrypted (.nge) shows a lock beside its
    date: grey, or red when this phone cannot read it - the row already
    says why (no key, or another key). Material's "lock" as an Android
    vector drawable, drawn with @expo/ui's Icon like the ⋮ menu.
2026-10-13 Gauge: the WiFi screen last in the cycle
    It sat between Track and the g-meter. It is for set-up and the phone,
    not something to read while driving, so it goes after every gauge.
2026-10-13 Gauge: the g-meter is always there - drop FEATURE_GMETER
    It was always 1; the switch only added #if blocks around the screen,
    its place in the cycle, the IMU read in loop() and the bench frame.
    The build is unchanged.
2026-10-13 Gauge: remove the brake lights
    The tyre screen's car lit its tail lights from the IMU's deceleration -
    a guess, not a brake signal - and was seen lit when it should not have
    been. A brake light that is sometimes wrong is worse than none.
    Gone with it: the VBO track log's "Brake IMU" channel (header, unit,
    column name and the value in each row - one channel fewer, the rest in
    the same order), calc_brake_update and its six host tests, and BRAKE_*
    in config.h. The OBD speed stays: the gear and the CSV use it.
    DECISIONS.md records why, and that the CAN brake signal behind the
    gateway would be the way back.
2026-10-13 App: "Save to a folder" remembers the folder
    It asked with Android's folder picker every time. The picker already
    takes a persistable permission on the folder, so its URI is now kept
    (logs-folder.txt) and reused by both saves - a drive's and Trips' "Save
    all". It asks again only when none is kept, or when the kept one no
    longer lists (deleted, permission revoked); that one is forgotten.
    Settings has a "Logs folder" card: where saves go, Change (the picker
    opens at the current folder), and "Ask every time" to forget it.
2026-10-13 App: About - the gauge's build without the image hash
    "Gauge firmware" with the hash was too long for the row and wrapped the
    label letter by letter. The build time and commit identify it; the hash
    stays on the gauge's Device page.
2026-10-13 Gauge: the WiFi screen no longer redraws itself whole every frame
    Swipes on the WiFi screen were often missed unless started at the edge.
    Measured (FRAME_STATS): on that screen the loop ran at 7 Hz against
    121 Hz elsewhere, each frame redrawing ~199 KPx in ~140 ms - so touch
    was read every ~143 ms, and a quick swipe could start and end between
    two reads. Logging the invalidated areas showed the whole countdown arc
    (10,10..455,455) marked dirty on every step.
    The cause: ui_update_wifi_countdown() cleared LV_OBJ_FLAG_HIDDEN on each
    step, and lv_obj_remove_flag() invalidates the whole object for HIDDEN
    even when it is already shown. The flag is now changed only when the
    arc's visibility does;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
2026-10-13 Gauge: the button only wakes it - no press handling
    Screens change by swiping, and touching the WiFi screen restarts its
    countdown, so the button's short press (next screen) and long press
    (toggle the AP) had nothing left to do - and the button cannot be
    reached with the pod mounted anyway.
    Removed: the press handling in loop(), web_toggle(),
    bsp_button_down(), BTN_LONG_PRESS_MS, and apManualHold - the long press
    while driving was the only way to hold the AP up against AP_DRIVE_OFF.
    The AP now just follows the car: up when awake, down while driving
    unless a phone is connected.
    The button stays a deep-sleep wake source (power.cpp), like the door.
2026-10-13 Gauge: "Stop sharing SD card" on the gauge itself
    While shared, the WiFi screen's button read "SD on PC: eject there" and
    did nothing - only the PC's eject or pulling the cable gave the card
    back, and it looked like a button that did not work.
    That rule was for a PC that could write: taking the card mid-write could
    corrupt it. Since the drive is read-only and answers MEDIUM NOT PRESENT
    once taken back, the gauge can end a share safely - the worst a PC can
    lose is a copy still running, which it reports as failed. So the button
    now reads "Stop sharing SD card" and takes the card back
    (usbdisk_unshare); the PC's eject and the cable still work too.
2026-10-13 Gauge: the card listing newest first, really
    /files (and /api/files) took FAT directory order as age order. Once
    files are deleted, a new one takes a freed slot earlier in the
    directory, so the newest log could sit mid-list or on page 2.
    Now every name is read into one PSRAM table (a card of logs can be
    thousands of names; internal RAM is what WiFi runs on), sorted with
    calc_card_order - a log by what follows drive_/trip_/track_, newest
    first, so a session's CSV, GPX and VBO sit together; numbered logs
    after the dated; other files last - and the page sliced from that.
    Host-tested.
2026-10-13 The gauge's resources in the app: RAM, PSRAM, SD, firmware, temperature
    /api/live carries a "sys" block: internal RAM free, total and lowest
    since boot (WiFi needs ~46 KB of it to start), PSRAM free and total,
    SD used and total in KB, the firmware's size against its partition,
    the chip temperature, and why the gauge last started (power on, wake,
    restart, crash, watchdog, supply dip). SD space is cached for a minute
    and taken under the logger's lock: usedBytes() can walk the whole FAT.
    The reply now fails loudly (500) if it ever outgrows its buffer rather
    than going out cut short.
    The app's Gauge screen shows them in a System card: a bar each for RAM,
    PSRAM, SD and firmware - red when RAM's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
2026-10-13 App: UX pass - fixes 1-11 of the review
    Broken or misleading:
    - The gauge in the header of every screen that says "tap it at the top"
    (Log encryption, a drive); compact - the ring alone - where the
    title needs the room.
    - Row: the label keeps its width and a long value wraps on the right;
    file names squeezed labels into "Tra / ck", "C / ar / da / ta".
    - A disabled Button looks disabled: no colour, dim text - a faded
    orange "No changes" still read as pressable.
    Noise:
    - No debug lines: Trips says "Reading new drives… 2 of 5" only while
    it reads; the sync's "Listed in 0.9 s" is gone.
    - Restart fragments and blips are not listed (isStub: under 200 m and
    3 min, or car data under 1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
2026-10-13 App: drop bad GPS fixes from the map, the ends and the top speed
    Logs from before the firmware's quality gate (sats / hdop) carry bad
    fixes with nothing to tell them by. The 23.9. drive ended on a fix
    13.5 km away (drawn as the end, with a straight line out to it), and
    after a tunnel sat 2.6 km off the road for ten seconds claiming 260 km/h
    - its top speed read 261. Others end on garage multipath (21-62 m jumps
    within one second) or hold one-point spikes. The old reader only kept
    such jumps out of the distance; the track, the bounds, the ends and the
    top speed still used them.
    parseGpx now works in two passes: the drive is cut into runs at jumps
    (over 30 m at more than 300 km/h - 25 Hz jitt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
2026-10-13 App: no note at the bottom of a drive's screen
    "⋮ shares the track or the car data..." / "Encrypted by the gauge..."
    repeated what the ⋮ menu and the Trips row's lock already say.
2026-10-13 App: read the bare <speed> of September's tracks
    The gauge wrote <speed> before it moved to the gpxtpx extension
    (2026-09-23). The parser only knew the extension, so those drives had
    no speed: top speed 0 km/h, moving time guessed from 20 Hz points
    stamped to the second (7 min of a 32 min drive), and 185 km/h average.
    Both tags are read now; the cache version goes to 3 so the old
    summaries are redone. The cache type takes any version number - its
    literal 1 no longer type-checked after the bump to 2.
2026-10-13 App: a spinner while the map loads
    The drive screen showed an empty dark box while MapLibre fetched its
    script, the style and the tiles, and only a line of text while the
    track was read. Now the map's box is there from the start with a
    spinner in it: first while the track is read, then over the WebView
    until the map is first idle (the tiles drawn). A load error replaces
    the spinner with its note, as before.
2026-10-13 Gauge: the N logo until the car answers, a status page on the bench
    A wake showed the gauge screens before any CAN data existed, all
    reading "--" - it looked broken. The boot splash now stays up after
    its sweep until a reading is fresh (oil, coolant, boost, rpm or
    speed), or until the "no car" fault would show anyway (the CAN grace,
    up to 60 s on a motion wake), or at a touch. A wake that goes back to
    sleep never shows a gauge at all.
    With a PC on USB the held splash is a status page instead, refreshed
    every second and with no timeout: firmware build, WiFi, SD space,
    GPS, CAN, RAM and PSRAM, chip temperature, uptime and why it last
    started. A touch, or car data, goes to the gauges. The sepa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
2026-10-14 App: the Gauge screen says what connecting does
    Not connected, the screen was a network name and a Connect button -
    everything else appears only once connected. A note under the button
    now says what a tap gets you (new drives come over, live readings and
    the system), that the gauge must be awake, and that the phone has no
    internet meanwhile, so maps will not load.
2026-10-14 App: drives named after where they went, and your own places
    A drive is titled by the places nearest its two ends - "Kolín →
    Příbram", "Around Kolín" for a loop - with the date under it; without
    a track the date stays the title.
    The names come from GeoNames lists shipped with the app (CZ and its
    neighbours: SK AT DE PL HU, ~1.9 MB in the APK), built by
    scripts/make-places.ts. Offline on purpose: no coordinates leave the
    phone, and drives are summarised right after a sync, on the gauge's
    WiFi, which has no internet. Every populated place is kept, the ones of
    100 people or more marked known: a known place within 3 km wins over a
    nearer hamlet (in a city, the quarter people say), while v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
2026-10-14 App: one tap on a button while typing
    With the keyboard up, the first tap on Save only closed the keyboard -
    naming a drive or a place, or a number in Gauge settings, took two
    taps. The screens' ScrollView now passes a tap through to the button
    it lands on (keyboardShouldPersistTaps="handled").
2026-10-14 Log the car's voltage, and show it in the app
    PID 0x42, control module voltage - the ECU's own supply: the battery
    with the engine off, the charging voltage running. In the ECU's
    supported list since the 2026-10-03 probe. Polled once a second on its
    own (VOLTS_POLL_MS): added to the slow request its two bytes would push
    that reply past one CAN frame.
    Logged as the CSV's last column, volts, so every column before keeps
    its place. /api/live carries can.volts (null while not fresh; the
    answer's buffer grows to 1500 bytes), and the app's Live card shows
    it. Not on the gauge's screens, for now.
    Not yet seen in the car: the bench has no ECU.
2026-10-14 Gauge: a voltage under 5 V is no reading
    Switching off, the ECU answered PID 0x42 with 0.00 V for ~11 s before
    going silent (first drive with voltage, 2026-10-14) - its shutdown, not
    the battery - and the log took it as a value. Under VOLTS_MIN_V (5 V)
    is now dropped; the lowest real reading, cranking, was 9.9 V. Running
    read 14.4-15.0 V, so September's "16.6 V" was the meter.
2026-10-14 Decisions: brought up to date, with a section for the app
    Two entries were wrong, not just old: "no delete endpoint,
    deliberately" now records its reversal and what still guards it, and
    log encryption, "not built yet", is built and working.
    Added since 2026-10-04: the logger on core 0 (the cost was saves, not
    writes), the settings table, no library swaps, logging levels, session
    ids, the gear from rpm and speed, voltage, SD firmware by hash; Lap
    timing and USB share sections; in UI the held splash and bench page,
    the update notice, the screen order, the button only waking, and the
    flag that invalidates a whole object; the AP down while driving and no
    hidden SSID; and The phone app - its sha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
2026-10-14 App: a drive's readings over time, as charts
    Speed, boost, oil and coolant, and voltage, as small multiples on one
    time axis - one y-axis each, never two scales on one chart; oil and
    coolant share a chart, being one unit, with a key. Drag across them:
    one cursor runs through all and each heading shows its value at that
    moment; untouched, the peak (voltage: its range). Boost keeps its
    vacuum below the drawn zero. A channel a log lacks has no chart.
    Colours from the dataviz palette's dark steps (blue, orange - oil as on
    the gauge), checked against the card: CVD separation 26.8.
    The CSV is cut to at most 600 buckets (series.ts, node-tested; peaks
    for speed and boost, means for the rest; a mid-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
2026-10-14 App: themes - three darks by accent, Light, or follow the phone
    A Theme card at the top of Settings: Dark – orange (the default, as
    before), Dark – N blue, Dark – red, Light, or Follow the phone (Light
    by day, Dark – orange by night, switching live). Applies at once and is
    kept on the phone, read synchronously at start so the first frame is
    already in it.
    Colours come from useColors(), styles from themed() - a StyleSheet made
    at import would keep the first theme's colours - across every screen,
    the headers and status bar, the ⋮ menus, the map (OpenFreeMap's
    positron style in Light) and the charts (the dataviz palette's light
    steps, validated on the light card: CVD 24.7). Every tex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
2026-10-15 App: an empty last CSV column is no reading, not 0
    The gauge writes CRLF and voltage is the CSV's last column. Split on
    "\n" alone, a row without a voltage - the first of a drive, any
    dropout - left "\r" there, and Number("\r") is 0: the chart's first
    point averaged 0 and 10.6 into 5.3 V. Lines now split on CRLF in the
    series and in the summary alike; a test with CRLF lines and an empty
    last column. Cache version 5, so the series are worked out again.
2026-10-15 READMEs: up to date, with fresh screenshots
    The main README's list of what it does gains drive names, weeks,
    charts, delete, themes, Czech, log encryption, the N badge on waking
    and the bench page; the voltage finding (PID 0x42, and its 0.00 V at
    switch-off); GeoNames under the licence. The app's README: its screens
    and files as they are now, /api/delete and how deleting works, and a
    section on adding text (t(), the Czech test) and colours (useColors,
    themed).
    Screenshots from 2026-10-14: the list, Settings, a drive's map and its
    charts, the Gauge screen in the car. Place names in them are made-up
    ones and the map is zoomed away from both ends; a key fingerprint is
    blurred. The gauge settin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
2026-10-15 App: the charts' cursor on the map; one drive, not two, after a rename
    The chart's cursor as a dot on the map. Drag across a drive's charts
    and the map marks where the car was then, without reloading: the
    series knows its start from the log's utc column, track points keep
    their seconds from the start, and pointAt() finds the one nearest the
    moment - standing at lights between two close points it is the
    earlier, after the track's end it is the last, in a gap (a tunnel) none.
    A drive log synced before the gauge renamed it - numbered while the
    clock was not set, dated at the first fix - stayed on the phone under
    both names; the GPX paired with the minute-long numbered copy and the
    whole log st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
2026-10-15 Gauge: Share SD card on the bench page
    The bench page - the held splash with a PC on USB - gains the WiFi
    screen's button: "Share SD card with PC", then "Stop sharing SD card"
    while lent. Its tap is the same as the WiFi screen's (shareTapped ->
    ui_take_share_tap()), so sharing stays in one place in the loop. A press
    on it does not end the page - LVGL gives it to the button, not to the
    page's press handler - while a touch elsewhere still goes to the
    gauges. The text is rebuilt once a second; the button follows the
    share state on every pass, comparing first.
    48 px tall: a touch just off a 34 px one landed on the page and went to
    the gauges. Replaces the idea of jumping to the WiFi screen when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
2026-10-15 App: moving the map no longer scrolls the page
    Panning or pinching the map with two fingers scrolled the drive screen
    instead: the screen's ScrollView took the gesture from the map's
    WebView. Now a finger down on the map holds the screen still until it
    lifts - useHoldScroll(), a switch in Screen any view with gestures of
    its own can use - and the WebView is marked nestedScrollEnabled.
2026-10-15 App: the map's speed colours fit the drive
    The scale was fixed - 0 / 50 / 90 / 130 / 170+ km/h - so a town drive
    was all blue-green under a legend of speeds never reached. Now its five
    stops run from 0 to just over the drive's top speed (from its cleaned
    track), in equal steps of a whole 5 km/h - 47 km/h gives 0/15/30/45/60,
    132 gives 0/35/70/105/140 - with the same five colours spread over
    them, and the legend labelled with them. The line's speed bands are a
    fifth of a step, so a slow drive gets as many shades as a fast one.
    speedStops() in its own module, node-tested.
2026-10-15 App: naming - the keyboard up once the screen is in, nothing moving under it
    Renaming a place, a tap on Save's empty side was once ignored while one
    on its text worked; and opening the naming screen, the keyboard did
    not always come up (autoFocus is asked while the modal still slides in,
    and Android ignored it at times). Not reproduced from adb, so two
    changes against the likely causes:
    - The window no longer resizes when the keyboard opens
    (softwareKeyboardLayoutMode "pan"): nothing moves under a finger as
    it slides up. A field low on a long screen is still panned into view.
    - The field is focused when the slide-in has ended (transitionEnd, a
    timer behind it), afresh - blurred first -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
2026-10-15 Gauge: how far the line is, on the track screen
    Once a lap is done, the track screen shows how much of the next is
    left against the best lap's length: an arc round the edge emptying
    towards the line, as the WiFi screen's countdown, and "lap 3 · 350 m
    to the line". The distance is summed from the fixes while a lap is
    timed - the step over the line split where its time is - with a step
    faster than 360 km/h adding none (calc_lap_step_m); never below 0, so
    a shorter lap reaches the line early and its crossing resets it. The
    best lap's length survives sleep, as its time does.
    tests/replay: the real laps.cpp built for the PC, Arduino and the heap
    stood in for, fed a recorded GPX fix by fix. On t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
2026-10-15 Gauge: one swipe, one screen; the lap arc fills up to the line
    A swipe could go past two or three screens. The finger is still down
    when the next screen is loaded, and LVGL takes what is under it there
    for a fresh press - so the rest of the same swipe was another gesture.
    After a screen change the touch is now ignored until it lifts
    (lv_indev_wait_release), which also keeps a swipe from tapping a
    button on the screen it lands on.
    The track screen's arc counted down the part of the lap still to
    drive; now it fills up with the part driven, full at the line, and is
    blue and as thick as the other screens' inner arcs (12 px).
2026-10-15 Sim: the gauge firmware on the PC
    sim/run.sh builds the firmware's own setup() and loop() - the .ino,
    ui.cpp, laps.cpp, settings.cpp as they are - against LVGL's SDL
    driver, and runs it in a 466x466 window fed a recorded drive: the CSV
    into ObdState as the CAN task fills it, the GPX into the GPS state
    and gps_read_fix(). The board is stood in for in sim_hw.cpp and
    stubs/ (Arduino, Preferences in memory, the ESP-IDF heap); millis()
    is the simulation's clock.
    The mouse is the finger. Keys: space pause, 1/2/3 for 1x/5x/20x,
    arrows 30 s back/forward, u a PC on USB, q quit. The window is a
    fixed-size dialog, so tiling window managers (i3) float it.
    On the 2026-10-11 loops it finds the line afte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
2026-10-15 Gauge: a bigger Share SD card button on the WiFi screen
    It was 180x30 px, small for a finger. Now 190x44 - as big as fits
    between the countdown arc and the QR code - with the touch area 8 px
    beyond it, close to the bench page's 48 px button.
2026-10-15 Gauge: the WiFi screen's QR code 20 px lower
    With the bigger Share SD card button the QR sat right against it. The
    QR and the lines under it (network, passphrase, address, phones) are
    20 px lower, leaving a gap under the button; the lowest line is at
    +122, still clear of the arc's ends and the fault notice.
2026-10-15 Tests: a made-up track session as a GPX
    The recorded drives are city loops - traffic lights, a different route
    each lap - not a track day. scripts/make_track_gpx.py writes one: a
    closed, smooth 2.7 km circuit (made up, over an empty field), driven at
    25 Hz with speeds from the corners (grip, braking, acceleration) and a
    little wandering GNSS noise. An out-lap from standstill, five timed
    laps a few percent apart - one with a corner taken far too slowly -
    and an in-lap to a stop. It prints each lap's true time, line to line.
    Through tests/replay the lap timer gets all five within 0.02 s.
2026-10-15 Gauge: the live delta to the best lap, on the track screen
    While a lap is timed against a best one, the track screen shows how far
    ahead or behind it the lap is, in the flag's place and as big as the
    lap time: "-1.2" green, ahead; "+0.8" red, behind. It compares the lap
    time at the same distance along the lap: each lap's time is kept every
    20 m (calc_lap_prof_add), and the best lap's becomes the reference -
    1024 marks, a 20 km lap, 2 KB kept across sleep as the best time is.
    Past the end of the best lap's length the flag is back.
    Lap 1, found by loop closure only when it ends, is filled in from the
    search's breadcrumbs (every 10 m, with their times). As one straight
    run, line to here, it wa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
2026-10-15 Tests: the made-up track session gets a drive log too
    scripts/make_track_gpx.py now also writes the car's side of the session
    as the gauge logs it (its CSV columns, 2 Hz): gear and rpm from the
    speed, pedal, load and boost from accelerating or not, oil and coolant
    warming through the session, the tyres heating up, and the g-forces of
    the corners and the braking - so the simulator shows a car, not "not
    connected to CAN bus".
    The session starts with 20 s idling in the pit lane: the gauge zeroes
    its g-meter on a car that is still, and a session starting at full
    throttle zeroed it on the launch - the dot sat at the edge.
2026-10-15 Sim: screenshots of the gauge's screens, in the README
    gauge-sim --shots DIR drives a session as a person would - the boot
    screen, START on the track screen, then once a lap is timed against a
    best one, every screen in turn at a moment that shows it at work
    (boost while the turbo pushes, the g-meter in a hard corner) - and
    quits. Each screen is rendered straight from its objects (lv_snapshot)
    into a buffer of its own: 870 KB is far more than LVGL's 128 KB pool,
    kept as the gauge's so the sim runs out where the gauge would.
    sim/screenshots.sh runs it on the made-up track session and cuts the
    pictures round like the panel, into docs/gauge/; the README shows them
    under the app's, and sim/READM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
2026-10-15 App: the drive list fills in order
    While new drives were being read the list looked shuffled. The files
    were read top to bottom already; it was the list: every unread drive
    was shown at once, "Reading…" on each, and a blip vanished when its
    summary landed - the rows below jumping up - while a row's week and
    title moved from the file name's stamp to the track's.
    A drive is now listed once it has been read (or failed to be, with
    why), under the one "Reading new drives… i of n" line, so the list
    grows in order and nothing moves once it is there.
2026-10-15 Carrier: J1 1 mm left, and the parts named on the silkscreen
    The display's header sat 1 mm too far right: J1 is now at -9.20 mm
    from the centre (front view), its eight tracks re-routed from the pads
    up to their first bend, and the GND pour refilled. gen_pcb.py's
    J1_PIN1 and the board's note say so.
    The back now says what goes where: the display's H2 pin names over
    J1's pads (5V GND 3V3 IO43 IO44 IO16 IO17 IO18), and every part by
    name instead of its J number - DISPLAY, GNSS, CAN, BUCK, OBD, CAN Rs,
    BUCK IN+. The references are only hidden, so the schematic still
    matches. Four names sit away from where the reference was, which
    collided or ran off the edge. DRC: no new violations.
2026-10-16 Decisions: no oil pressure - the engine has a switch, not a sender
    The i30 N's G4KH has an on/off oil pressure switch (94750-37100, 0.3
    bar), which lights the dash lamp and has no value behind it; Mode 01
    has no oil pressure PID. In the logged E001 payload the one
    pressure-like value (bytes 31-32) rises with rpm and falls as the oil
    warms, but trails rpm by a second and reads 280-510 with the engine
    off: modelled, not measured. Written down with the test any future
    candidate has to pass.
2026-10-16 Gauge: fuel rate, lambda, outside air, fuel level, catalyst and rail in the logs
    Seven more values from the engine ECU's supported list (the 2026-10-03
    probe), not yet seen answering, into the drive CSV (after volts, so no
    column moves) and the track session's .vbo (as channels with units):
    - 0x5E engine fuel rate, L/h - in the fast request, in the place of
    0x05, the raw coolant sensor that is only logged;
    - once a second, a request of their own: 0x05, 0x34 lambda measured by
    the wideband O2 sensor, 0x44 the lambda the ECU asks for, 0x46
    outside air, 0x2F the fuel tank, 0x3C the catalyst;
    - 0x59 fuel rail pressure, with the voltage (still one frame).
    Formulas per SAE J1979. A value th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
2026-10-16 App: "Save all to a folder" takes the track sessions too
    The track sessions' .vbo files came over from the gauge with the drives
    but were never saved out: "Save all" took only the drives' GPX and CSV.
    Now every .vbo the phone holds goes too, decrypted under its plain name,
    for Circuit Tools, HackTheTrack and other lap analysers. Saved as
    octet-stream: given text/plain, the folder picker names it .vbo.txt.
2026-10-16 Gauge: the .vbo has been opened by lap analysers
    The track log's note said it had never been opened in Circuit Tools. A
    session with laps (2026-10-16) now has: Circuit Tools 3.2 reads it, and
    HackTheTrack finds the laps. Circuit Tools takes no [laptiming] line for
    a circuit it does not know - neither from a real Racelogic file - and
    asks for one; lapvisor 0.3 misreads that section in both. A comment
    only.
2026-10-16 App: "Save all to a folder" saves the drives synced since
    It said everything was already in the folder while new drives were not:
    the header's ⋮ keeps the function it was given when it last updated -
    when the list first had drives, or a save started or ended - and with
    it that moment's list. The drives are now read when Save is tapped, so
    the ones synced since are saved too. (The lint rule that would have
    caught it was switched off on that line; it is on again.)
2026-10-18 Gauge: oil and coolant over-temperature on every screen
    The warning showed only on the oil screen's state line, and the gauge has
    no speaker - so on the track screen, where a track day is spent, nothing
    said the oil was at 132 C (2026-10-17, 9 minutes over 125 C).
    Over-temperature is now a fault of the notification rim, which is drawn
    over every screen: the whole rim red and "OIL 126°C - TOO HOT" (or
    COOLANT) at the bottom, the reading as it changes. The most important
    fault, ahead of the CAN bus; the same latched states as the oil screen,
    so the same hysteresis. A degree's change redraws the line but keeps the
    fault tapped to.
2026-10-18 Gauge: the WiFi AP comes back after a drive again
    From 2026-10-12 the AP, taken down while driving (AP_DRIVE_OFF), never
    came back once stopped - on every drive, until a reboot (the drive CSVs'
    apUp; the track day of 2026-10-17 ended with the pod unplugged to reach
    it). Two faults together:
    - Internal RAM. web_start() declines below AP_MIN_INTERNAL_HEAP (80 KB),
    as esp_wifi panics rather than failing when it runs short. The log
    writer held 32 KB of internal RAM for good: the CSV, GPX and .vbo
    batches and, since log encryption, a 12 KB sealing buffer. The batches
    are now in PSRAM, which only the CPU fills; every card write goes
    through one 4 KB internal buffer, since the SD driver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
2026-10-18 Sim: screenshots show the warning rim; one of the oil over its limit
    The rim and its line live on LVGL's top layer, over every screen, and a
    screenshot rendered only the screen: --shots now lays the top layer over
    it, as the panel shows them. A last shot is the track screen with the oil
    over its warning - the made-up session's oil now climbs to ~126 C by the
    in-lap, as a real track day's did (132 C), so it waits for the gauge's own
    120 C, no threshold changed for it.
2026-10-18 README: fresh screenshots of the gauge, with the over-temperature warning
    All eight retaken in the simulator on the made-up track session: the
    track screen now has the live delta and the arc filling up to the line,
    and a new one shows the oil over its warning on the in-lap, the red rim
    over the screen. The feature list catches up: warnings on every screen,
    how far the line is and the delta, fuel rate, lambda, catalyst and rail
    in the logs, the track session's .vbo for lap analysers, and the app
    letting go of the gauge's WiFi once synced.
2026-10-18 App: a tap on the gauge syncs; Gauge settings is its one screen; no upload
    Once the phone left the gauge's WiFi after every sync (cb647a0), the
    Gauge screen - reached only by tapping the gauge in the header while
    connected - and Gauge settings in its ⋮ were out of reach.
    - The gauge in the header syncs: a tap connects, the sync runs, the
    phone lets go, and a toast says what came over - or why it stopped,
    when a tap tries again. With no gauge yet it opens the setup.
    - Gauge settings is in the main ⋮, under Settings, and is the gauge's
    one screen: setting it up, its settings, screen order and firmware,
    its build and system (read once, no polling), the clock and the
    g-meter zero,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
2026-10-18 Gauge: an 'h' bench command for internal RAM
    In the FRAME_STATS build, 'h' prints internal RAM free, the least it
    has been since boot, the largest free block, whether the WiFi AP is up
    and how often it was refused - what decides whether the AP starts
    (AP_MIN_INTERNAL_HEAP). Used to check b86666a on the bench: logging,
    driving 109 KB free, the AP back a minute after stopping.
2026-10-18 Gauge: built for the carrier PCB
    The gauge is on the carrier now (hardware/carrier), soldered and fitted.
    It routes the CAN pair the other way round from the hand-wired
    prototype - TX on GPIO16, RX on GPIO17 - which BOARD_CARRIER already
    chose; it is 1 by default now. Every use of the pins goes through
    CAN_TX_GPIO / CAN_RX_GPIO, the deep-sleep wake on RX included, and
    GPIO17 is RTC-capable and no strapping pin.
    On the bench: boots, the GNSS answers on GPIO43/44, the SD card mounts.
    CAN is to see on the first drive.
2026-10-19 Gauge: ui.cpp split into one file per screen
    ui.cpp was ~2000 lines holding seven screens, the notification rim, the
    boot splash, the bench page and the render benchmark, with every
    widget pointer a file-level static visible to all of them. Each now has
    its own file and owns its own widgets:
    ui_temps, ui_boost, ui_gmeter, ui_tyres, ui_gps, ui_track, ui_wifi
    ui_notice the fault rim and its text, on the top layer
    ui_boot the splash, the bench page, ui_show_notice
    ui_bench the FRAME_STATS render timings
    ui_widgets the builders every screen uses, and the swipe handler
    ui_priv.h the palette and what the files share
    ui.cpp keeps ui_init(), which calls ui_build_<screen>()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
2026-10-19 Gauge: logger.cpp split; the CSV is a table of columns
    logger.cpp was ~1400 lines: three log writers, their file naming, the
    encryption, the task and the card, with each writer's batch handled by
    its own copy of the same code. Now:
    log_sink LogFile - a file, its batch in PSRAM, its encryption; one
    append (logfile_printf) and one drain for all three writers
    log_names the session id, and dated or numbered names: one
    lognames_new() where three writers each spelled it out
    log_csv the drive CSV
    log_gpx the GPX track and the trip distance
    log_vbo the .vbo track session
    logger.cpp the task, the SD lock, mount/suspend/resume, closing, the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
2026-10-19 Gauge: loop() as a list of named steps
    loop() was 425 lines in one function, with the bench console, the
    splash, the faults, the gauges, the g-meter, the view timeout, the USB
    share, the AP and the render all inline. It is now a list of calls,
    each step a function beside it with its comments:
    passTiming, benchCommands (FRAME_STATS), updateTempStates,
    bootSplashTask + benchPageText, faultsTask, gaugesTask, gmeterTask,
    viewTask, usbTask, apTask, lvglTask
    The code is moved, not changed, except:
    - the bench console's 'b' (render benchmark), 'r' and 's' are handled
    with the other commands at the top of the pass, not where each was
    used; 'r' and 's' set benchNoRim / benchSynth, read by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
2026-10-19 Gauge: bench tools out of the loop; BENCH=1 builds; scripts/check.sh
    The serial console, the frame stats and the wake-on-motion test were
    #if blocks through loop(), bsp.cpp's flush and the UI, and a bench build
    meant editing config.h and remembering to set it back.
    - bench.cpp / bench.h: the console, the OBD rate print and the WoM
    test. loop() calls bench_task(now); bench_synth(), bench_no_rim() and
    bench_ap_kmh() are empty inlines in the car's build, so the code that
    asks them needs no #if.
    - prof.h: PROF_SCOPE(stat) times its block into a ProfStat (count, sum,
    max), PROF_ADD(var, n) counts; both are nothing with FRAME_STATS 0,
    arguments included. The flush, the loop pass and lv_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
2026-10-19 Gauge: the web API's file-name checks into calc.h, with tests
    The two checks that decide which card file the phone may open or delete
    - the character whitelist (safeName) and the drive-log filter of
    /api/delete - were inline in webapi.cpp, as String code no test could
    reach. They are the file pages' security boundary, so they now live in
    calc.h as calc_safe_name() and calc_is_drive_log() and are tested on
    the host (tests/test_names.cpp): every name the firmware writes passes;
    separators, "..", an embedded NUL, CR/LF and over-long names do not;
    only trip_/drive_/track_ .gpx/.csv/.vbo, plain or encrypted once, are
    deletable.
    Same rules as before, moved: webapi.cpp calls them.
2026-10-19 Gauge: obd_*_fresh() in one place, shared with the sim
    "Is this reading current?" was written twice: in obd.cpp, and as a copy
    in the simulator (which compiles without the CAN driver). The copy had
    already fallen behind - none of the seven readings added 2026-10-16.
    The functions now live in obd_fresh.cpp, apart from obd.cpp and the
    TWAI driver, and the sim compiles that file. The test itself is
    calc_fresh() in calc.h, host-tested: ages out at max age, never-arrived
    is stale, and the age holds across the millis() wrap.
2026-10-19 Gauge: OBD reply parsing into calc.h, with tests
    ISO-TP reassembly, the multi-PID walk and the Mode 01 formulas were in
    obd.cpp, tangled with the CAN driver, and untested - while the
    reassembly has had two field bugs: a TPMS First Frame resetting the oil
    transfer mid-way (engine bytes then decoded as tyre pressures), and a
    short last frame splicing in the previous frame's stale tail.
    Now in calc.h:
    - calc_isotp_rx(): one frame in, an event out - single-frame payload,
    First Frame (send Flow Control), completed transfer, abort, nothing.
    calc_isotp_expire() for the timeout. obd.cpp sends the Flow Control
    and counts isoOk / isoAborts, as before.
    - calc_mode01_walk(): the multi-PID reply,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
2026-10-19 Gauge: the GPX gate into calc.h, with tests
    Which fixes become track points and trip distance - the rate limit,
    the fix-quality check, the jump check with its escape hatch, the
    segment break, distance only while moving - was ~100 lines inside the
    GPX writer, untested, although DECISIONS.md calls it load-bearing and
    each rule in it is the fix for a real drive gone wrong.
    It is now calc_gpx_gate(): state in, one fix in, accept or not, and
    what an accepted point means (metres for the trip, "same trip" by
    millis, a segment break before it). log_gpx.cpp keeps the writing, the
    trip total and its wall-clock reset. The rate limiter's and the jump
    check's "last point" times were set together, always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
2026-10-19 Gauge: the boost arc's full scale is 1.4 bar
    It was 2.00 bar, while the car peaks at 1.26-1.34 (track day
    2026-10-17, per session; 1.34 the most it would give) - so full boost
    filled two thirds of the arc and the gauge never looked full.
    BOOST_ARC_MAX_BAR in config.h, beside the torque arc's scale. Above it
    the arc stays full; the number is unchanged.
2026-10-19 Gauge: dead build switches deleted
    Three config.h switches had one side that cannot work on this car:
    - OIL_USE_MODE22 0 polled Mode 01 PID 0x5C, which the car never
    answers (193 requests, no reply) - and, since the dashboard's coolant
    comes from the same Mode 22 DID, would have silently lost coolant too.
    Gone, with OIL_TEMP_FROM_MODE01 and its test.
    - BOOST_USE_MODE22 1 read DID 0x0000 with a "TODO formula". Gone, with
    BOOST_MODE22_DID; boost is MAP (PID 0x0B) against baro, as it was.
    Boost now goes through calc_mode01_value() like every other PID, so
    handlePid() is one switch. COOLANT_FROM_E001 stays: both of its sides
    work.
2026-10-19 Gauge: an over-temperature degree no longer redraws the whole panel
    With oil or coolant over its limit the rim's text names the
    temperature, so each new degree redraws the notice - and the redraw
    restyled all 48 rim segments and un-hid the full-panel container every
    time, both of which invalidate the entire screen. A degree cost a full
    re-flush (since e68860d, which put the hot faults on the rim).
    The rim colour, the text colour and the visibility are now applied only
    when they change, and the text only when it differs. Measured with the
    real UI on the simulator's LVGL, counting flushed pixels: 125 -> 126 C
    was 217156 px (the whole panel), now 3850 (the text line).
2026-10-19 Gauge: tyre limits changed on the phone recolour the tyres at once
    The tyre screen redrew only when a reading changed, but whether a
    pressure is red also depends on the limits from the settings page - so
    a new limit showed up at the next TPMS reply, up to a minute later. The
    guard now compares what is shown, red-or-not included. Checked on the
    real UI: same readings, front limit raised to 2.6 bar - the fronts turn
    red on the next pass; unchanged, nothing is redrawn.
2026-10-19 Gauge: no card is an error to the app, not an empty card
    Two answers made the app forget deletes it still owed the card:
    - /api/delete with no card mounted: every file looked absent, so it
    answered 410 "already gone", which the app counts as done. Now 503,
    which it retries at the next sync.
    - /api/files when the listing failed (root not readable, no PSRAM for
    the name table) answered 200 with no files - and a file not in the
    list is taken as deleted. Now 500, and the sync fails instead.
    The /files page says the card could not be read.
2026-10-19 Gauge: a log that cannot be opened no longer takes the whole card down
    When the drive CSV could not be opened (a full card, say) or reopened
    after its rename, the logger marked the whole card unusable: the GPX,
    the track log and the sleep log stopped too, the rim said "no SD card"
    about a card that was there, and /api/files answered 503 - so the phone
    could not even list the card to delete files and make room.
    Now each writer gives up on its own file only (the CSV as the GPX and
    the .vbo already did), still never retrying per pass. A new amber fault,
    "SD card full or failing", says a writer has stopped while the card is
    mounted. When the card comes back from the PC, all three may try again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
2026-10-19 Gauge: a stalled download can no longer trip the watchdog
    /dl wrote each 1 KB through WiFiClient::write(), which (core 3.3.8,
    NetworkClient.cpp) waits up to 1 s in select() per try for up to 10
    tries and then sends with MSG_DONTWAIT. A client that stops reading -
    a phone walking out of range, a backgrounded app - held one write for
    10 s, past the 8 s watchdog, and the pod rebooted. The setTimeout()
    meant to bound it sets SO_SNDTIMEO, which MSG_DONTWAIT ignores.
    sendAll() now writes to the socket itself: 100 ms select() waits, the
    watchdog fed between them, and the client dropped once it has taken
    nothing for DL_CLIENT_TIMEOUT_MS (1.5 s). A transfer cut short closes
    the connection, so the cl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
2026-10-19 Gauge: after a deep sleep the RTC's crystal wins over the drifted clock
    On every wake from deep sleep the sketch set gps.timeSet - "the GNSS set
    the clock" - just because a clock had survived. Two things followed:
    the NMEA resync waited GPS_TIME_RESYNC_MS (10 min) before correcting
    it, and rtc_task(), which writes only GNSS time into the PCF85063,
    wrote the system clock in instead. Through a deep sleep that clock runs
    on the ESP32's RC slow clock, a few percent out - minutes per parked
    hour - so the crystal RTC was overwritten with the drift.
    gps.timeSet now only ever means a GNSS sync this boot; file stamping
    already asks clock_valid(), which a retained clock passes. And at boot
    rtc_init()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
2026-10-19 Gauge: a GPS module that stops talking is reported, and found again
    gps.linkUp was "any sentence ever decoded", so it latched: a module that
    died or lost power mid-drive never raised FAULT_GPS, and the baud hunt
    - which ran only while nothing had ever decoded - never resumed for a
    module that came back at another rate (a power-cycled M9 returns to its
    38400 default).
    The link is now sentences within GPS_LINK_STALE_MS (3 s). When it drops
    the hunt resumes, and the module is configured again once found, since
    it comes back at 1 Hz with every sentence on. The ~2 s of UBX waits at
    configuration, which swallow the NMEA, do not count as a lost link.
2026-10-19 Gauge: one rejected fix no longer merges two laps
    A fix that failed the quality gate, or carried no time, made the lap
    timer forget its previous point - so the next good fix had nothing to
    pair with, a crossing between the two was never tested, and that lap
    ran on into the next. It is now skipped and the previous point kept; a
    real gap is still safe, since a step longer than TRACK_MAX_FIX_GAP_MS
    is never tested.
    Replayed through the real lap timer (tests/replay), the made-up track
    session with every 3rd fix at 0 satellites: 6 laps, as on the clean
    track; the old code found 2.
2026-10-20 Gauge: a moving car keeps the pod awake, CAN bus or not
    The pod decides the car is off when the bus goes quiet. On 2026-10-19
    the OBD cable's CAN-L wire broke, so the bus was quiet while driving:
    the sleep log shows it sleeping after 5 min with canRx=0, waking on
    motion within a second, hearing nothing for its 60 s window and
    sleeping again - the gauge dark every minute, at up to 95 km/h, and
    nothing on it saying why.
    GNSS speed at or above SLEEP_HOLD_MOVING_KMH (10 km/h) now holds sleep
    off like a touch does, for the "Sleep after" window, in both paths: a
    motion wake that finds no bus but a moving car stays up, and the
    key-off path waits. Held awake with no frames, the rim says "not
    connec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
2026-10-20 Gauge: a GPS fix read waits out a pre-empted writer instead of giving up
    gps_read_fix() retried its seqlock eight times in a tight loop. The
    writer holds it for a few instructions, but at priority 4 on core 0 it
    can be pre-empted mid-update by the CAN task, and eight tries from core
    1 (the lap timer) spanned a microsecond or two - a good fix refused.
    Small in practice (the lap timer asks again 5 ms later, well before the
    next fix), but a refusal should mean "torn", not "unlucky". It now
    retries for GPS_READ_WAIT_US (2 ms), pausing 5 us between tries.
2026-10-20 Gauge: a CSV row's raw payload is one OBD reply, never two
    The raw DID payloads (oilPayload, tpmsRaw - the CSV's LOG_FULL hex
    columns) were memcpy'd by the CAN task while the logger printed them a
    byte at a time. Both run on core 0, the CAN task at priority 5 over the
    logger's 1, so a reply landing mid-row pre-empted the print and the cell
    mixed the start of one payload with the end of the next - in exactly
    the columns kept for decoding unknown byte layouts offline.
    The CAN task now writes them under a spinlock, and the logger copies a
    whole reply out under the same lock (obd_copy_raw) before printing.
2026-10-20 Gauge: CAN comes back even if the first restart after bus-off fails
    After a bus-off the TWAI driver recovers into STOPPED and must be
    started again. That was one twai_start() on the BUS_RECOVERED alert; if
    it failed, busOff stayed true, every request stopped, and the alert
    never came again - CAN dead until a reboot, with the gauge showing
    "--" everywhere. A recovered-but-stopped driver is now started again
    every CAN_START_RETRY_MS (1 s) until it runs.
2026-10-20 App: fuel used and consumption for each drive
    A drive's fuel is now worked out from the car's fuel rate (the CSV's
    fuelLh, PID 0x5E) over time, and divided by the distance from the
    car's own speed (obdKmh) over the same rows: "Fuel used" and
    "Consumption" on the drive's screen, l/100 km among the facts in the
    list. A row's rate and speed hold until the next row; a gap over 5 s or
    an uptime restart counts as nothing; under 1 km no figure is shown.
    Not the tank level: on the 2026-10-20 drives it ROSE 7-10 points over
    each drive (slosh), and 1 % of the tank is a third of a short trip.
    Not the GPS distance: the track starts at the first fix, minutes after
    the CSV, and that stretch's fuel would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
2026-10-20 App: the trips list shows the fuel used too, and its figures are switchable
    Each drive in the list can now also show the fuel it burned (litres),
    beside the consumption (l/100 km). A "Trip list" card in Settings
    switches the optional figures on and off: peak boost, peak oil, fuel
    used, consumption - all on by default, read again whenever the list
    comes back into view. Time and top speed always show, and a drive's
    own screen always shows everything.
2026-10-20 App: a drive's distance no longer collapses when the GPS repeats a fix
    Since the gauge moved to the carrier PCB (2026-10-19) its GPS has
    delivered a fix a second, while the gauge still writes a GPX point
    every 40 ms - 95 % of the points are the previous one again, in runs of
    25. The app measured each step from the last copy: a second's travel in
    40 ms, ~500 m/s, taken for a glitch and dropped. A 14 km drive read
    2.1 km.
    parseGpx() now keeps one point per fix (a point at exactly the previous
    position, same segment, is a copy), measuring the next step from the
    first copy; the last copy's time still ends the drive, so a drive ending
    parked keeps its length. Today's drives read 13.4 / 14.0 / 11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
2026-10-20 Gauge: one GPX point per GPS fix, timed by the fix
    The GPX writer ran every logger pass and took whatever position was
    there, new or not, timing its rate limit and jump check by when the
    pass ran. With the receiver at 1 Hz (since the carrier PCB, 2026-10-19)
    every fix was written ~25 times, and the next real step - a second's
    travel - was judged against the last copy 40 ms earlier: ~500 m/s,
    refused. The gauge's trip distance, which goes through the same gate,
    read a fraction of the drive; so did the app.
    Now each fix is taken once (gps_read_fix's seq, and the RMC/GGA double
    publish of one epoch skipped, as the .vbo does), fixes without a time
    are skipped, and the gate runs on the fix's own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
2026-10-20 Gauge: a boot log on the SD card
    The serial console says at every boot whether the GPS took its
    configuration, but in the car there is no console - so a GPS left at
    its 1 Hz default (since the carrier PCB, 2026-10-19) showed only as
    drives with a fraction of their distance, and nothing on the card said
    why.
    Now each boot that stays up appends one line to /bootlog.txt, 30 s in
    (bootlog.cpp): firmware and reset reason; the GPS's baud, sentences,
    how its configuration went (ack / NAK / no answer - gps.configAck, new)
    and the fix rate it actually delivers, counted over 10 s (gps.fixes,
    new); the clock and the RTC; CAN; the card; internal RAM now and its
    low point; the AP. A parked timer wake, a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
2026-10-21 Gauge: an 'x' bench command - is the GPS's RX line really driven?
    The carrier's GPS never acknowledges its configuration, and a meter on
    the module's RX pin reads 3.3 V - which an idle UART line does whether
    the ESP drives it or the module's own pull-up does. 'x' holds
    GPS_TX_GPIO low as a plain output for 15 s, then restarts: 0 V on the
    module's RX proves the ESP side. (2026-10-21: 0 V - the ESP drives it,
    so the fault is on the module's side; and the prototype's own 25 Hz
    firmware gets no ACK on the carrier either, so it is not software.)
2026-10-21 Gauge: a 'p' bench command - does the GPS module take any input?
    u-blox modules filter input by protocol per port, so a module that
    ignores our UBX configuration might still take NMEA. 'p' sends an NMEA
    poll ($PUBX,00) and a UBX poll (MON-VER) from the GPS task, which owns
    the UART, and prints which came back.
    2026-10-21, the carrier's module, after 10 min unpowered: neither
    answered. With the ESP shown to drive the module's RX pin ('x'), its
    receive path is broken between that pin and the chip - which is why it
    stays at its 1 Hz default and cannot be parked before sleep.
2026-10-21 Gauge: log keys from a seeded entropy pool after a wake
    Each encrypted log segment's throwaway secret is BLAKE2b of a pool and fresh
    RNG output. The pool was a plain static, so every wake started it from zeros,
    and the S3's RNG is only true-random with the radio on - while after a deep
    sleep wake the AP is often not up yet when the first file opens. Those keys
    came from an RNG with no entropy source behind it.
    The pool now lives in RTC memory, so it carries over deep sleep, and is
    seeded at every boot from the RNG with the SAR ADC noise source switched on
    (bootloader_random_enable). That runs from logger_init() in setup(), before
    the AP starts in loop(): the source must not run alongside Wi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
2026-10-21 Gauge: what the phone sends is checked before it is kept
    From the 2026-10-19 firmware review, the input half of the risks list:
    - Firmware updates (B3): only images carrying the string "N-Gauge firmware
    image" are installed, scanned as they stream in (calc_mark_scan, tested
    across any chunking). The bootloader only checks the image suits the
    chip, so any ESP32-S3 sketch was taken - and one picked by mistake would
    leave a gauge that cannot take an update back. The image's project name
    cannot tell them apart: it is "arduino-lib-builder" for every Arduino
    sketch. A guard against a mistake, not an attacker.
    - Log key (B7): a public key that is low-order (all zeros among them) gives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
2026-10-21 Gauge: the SD card - failed writes, a stuck lock, full logs, a lost fix
    From the 2026-10-19 firmware review, the card half of the risks list:
    - Failed writes (B1): every write's result was ignored, so a card that
    failed mid-drive went on "logging" into nothing with no fault shown. Now
    a short write (logfile_check_write - a stdio write spills the 4 KB file
    buffer, so a failing card shows on the next one) closes the files, each
    ending at its last good block, and remounts the card; the writers start
    new files. Mounting is retried every 10 s while the card is gone ("no SD
    card" meanwhile). After three remounts that did not help - a full card
    fails every write - writing stops with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
2026-10-21 Gauge: a pulled SD card is noticed - the flush is checked too
    3a04dc0 checked the result of every write, and on the bench (2026-10-21)
    pulling the card mid-log changed nothing: the drive log went on "writing"
    for minutes. A batch smaller than the file's 4 KB stdio buffer reaches the
    card only in flush(), and Arduino's File::flush() drops fflush's result.
    So a commit now checks the flush by its effect: afterwards the size on the
    card (a stat of the path, ~1 ms) must cover the write position. Pulled, the
    card fails even ftell(), which the message now says plainly.
    Same bench test with this: the failed write noticed at once, the remount
    retried every 10 s while the card was out, "SD card remo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
2026-10-21 Gauge: long laps, honest comments on what survives, a bounded fault table
    The last of the 2026-10-19 firmware review's risks list:
    - Lap profile (B12): the best lap's time against distance is uint16 in
    RTC memory, and in 10 ms units it saturated at 10:55 - a slow
    Nordschleife lap - after which the live delta read nonsense. Now 20 ms
    units (CALC_LAP_PROF_UNIT_MS), up to 21:50; a delta shown to 0.1 s loses
    nothing. Tested with a 15-minute lap.
    - What survives (B13): the lap session and the trip distance were said to
    survive everything but a power cycle. RTC_DATA_ATTR is kept across a
    deep-sleep wake only: a watchdog reset, a crash or an update clears them
    as well. The comments n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
2026-10-21 Gauge: comments that no longer told the truth
    D1 of the 2026-10-19 firmware review. No code changes.
    - config.h: the BOOT button is verified (it wakes and pages), not a TODO;
    the fast request lists the PIDs it sends (0x5E, not 0x05); the
    once-a-second PIDs do answer; no beep or "audible" guard exists; the
    TPMS layout is solved; GPX costs ~20 MB an hour at 25 Hz, not 4 at 10;
    the AP password alphabet has 31 characters; the POSIX TZ text described
    a setting that is now an offset and a DST flag; GPX_SEGMENT_GAP_MS sits
    under its own explanation again.
    - webapi.h: the route list, and that the app does delete (drive logs only).
    - bsp.h/.cpp: the audio codec is not driven, the RTC is;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
2026-10-21 Gauge: magic numbers named, and the track log flushes only when written
    D2 of the 2026-10-19 firmware review:
    - Tasks: core, priority and stack of the CAN, GNSS, logger and download
    tasks in one table in config.h (TASK_*) - the priorities only mean
    something against each other, and they were spread over four files.
    - SD_CLK/CMD/D0_GPIO into config.h, out of logger.cpp.
    - The WoM bench used a bare 21 for the IMU's INT2 pin: MOTION_WAKE_GPIO.
    - The rings every screen is drawn with (ui_priv.h: RING_OUTER/INNER_PX/W,
    RING_EDGE_PX), which were 420/16, 372/12 and 440 in six files; make_arc()
    is make_arc_sized() with the outer ring, not a copy of it.
    - GMETER_RED_G for the g-meter's 0.9 g.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
2026-10-21 Gauge: dead UI code out, "no value" drawn one way
    D3 of the 2026-10-19 firmware review:
    - coolState was an alias of oilState kept after coolant lost its own state
    line: gone. The g-meter's "G-FORCE" caption was overwritten by the
    figure at the first sample: it starts as "0.00 g" instead.
    - Boost is clamped to 0 before anything else, so its "bar < 0" branches
    further down could never run: gone.
    - "No value" was drawn three ways: show_no_value() (dim, centred), and on
    the torque, GPS speed and tyre readouts by hand - two of them in
    COL_LINE, which ui_priv.h itself says is too close to the background to
    read. All show_no_value() / show_value_style() now.
    - Tyre temperatures read "3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
2026-10-21 Gauge: one way to measure elapsed time, and a closed log can be deleted
    D4 and D5 of the 2026-10-19 firmware review:
    - Elapsed time (D5): millis() stamps were compared two ways, unsigned
    (now - t >= X) and signed ((int32_t)(now - t) < (int32_t)X), and they
    differ where it matters: a stamp written on the other core can be a
    millisecond newer than this core's `now`. Unsigned, that is 49 days ago
    - the bug power.cpp's comment records (the gauge slept mid-drive). Now
    calc_elapsed() and calc_reached() in calc.h, both signed and tested with
    that case and across the wrap, and every signed cast in power, obd, gps,
    rtc, the logger, the track screen, the download and loop() uses them.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
2026-10-21 Gauge: the web server on its own task (esp_http_server)
    The Arduino WebServer ran inside loop(), the screen's loop, and read a
    request with a 5 s wait per byte: a phone on a weak link - or a client
    dribbling on purpose - froze the gauge for as long as it kept sending, and
    past 8 s the watchdog rebooted the pod. The last open item of the
    2026-10-19 firmware review.
    Now ESP-IDF's esp_http_server, built into the core: its own task on core 0
    (TASK_WEB_*, internal stack - an update writes flash from it), per
    connection receive and send timeouts (WEB_RECV/SEND_TIMEOUT_S), several
    connections, the least recently used purged. Not watched by the watchdog,
    on purpose: a client stuck mid-request must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
2026-10-21 Build: no stray copy of the last image in the sketch folder
    The ESP32 core copies every build's binaries into the sketch's own build/
    folder, car and bench alike, so that folder always held whichever variant
    was built last - check.sh builds the bench one last. On 2026-10-21 that
    copy went to the phone as "the car build" for an update test, and the pod
    came back up running the bench build.
    The real outputs were already separate (.build/car_gauge_v1 and
    .build/car_gauge_v1-bench). build.sh now removes the copy after every
    compile and prints which image it built.
2026-10-21 Gauge: a degree of oil or coolant no longer redraws a whole ring
    Every drive had a ~110-130 ms loop() pass every 4-5 s (loopMaxMs; 2026-10-20
    drives: 129 and 114 of them, every other pass under 20 ms) - about two
    full-panel pushes, a stutter on screen. A column correlation pointed at the
    temperatures: coolantC had changed at 51 % of those rows against 2 %
    elsewhere, oilC at 24 % against 1 %.
    Replaying the drive in the simulator with the new SIM_INVALIDATE=<px>
    (every invalidated area that big, with its screen) showed it: each update
    set both rings' colours again, and LVGL invalidates the whole object on
    any style set, even to the colour it already has - for the coolant ring its
    377x377 box,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
2026-10-22 App: the trips list no longer jumps while syncing
    Asked 2026-10-20: the list jumped around during a sync, and the popup after
    saving to the folder counted every file it skipped.
    - The "Reading new drives…" line sat above the list and came and went,
    pushing every row down and back up. It is a Pill now - floating at the
    foot of the screen, over the list, taking no room in it (Screen's new
    overlay) - as is "Saving i of n" for Save all.
    - Each drive appeared on its own as soon as it was read, while the sync was
    still landing files: the list moved down once per drive. New drives are
    read once the sync has finished, and with a list already showing they are
    added to it together, in o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
2026-10-22 Build: scripts/build-apk.sh - the app for arm64 only, 54 MB not 137
    The generated android/ project builds all four ABIs, and the APK grew to
    137 MB; the phones this is for are 64-bit ARM. android/ is Expo's to
    regenerate, so the choice is made at build time
    (-PreactNativeArchitectures=arm64-v8a; APK_ABIS overrides).
    It also sets Java 17 and the Android SDK itself: with the system default
    switched to Java 8 and no ANDROID_HOME in the shell, the build failed
    outright (2026-10-22). `install` puts it on the phone over adb.
2026-10-22 Gauge: no one-point track from a parked wake
    A motion wake - a door, a bump - keeps the pod up for a minute. With sky
    view it got a fix, the GPX opened on that first accepted point, and the pod
    slept again: a one-point "drive" at the parking spot in the app's trip
    list, per wake (2026-10-20: two, at 20:37 and 21:36). The track now opens
    only once the car is on (a CAN frame, as the drive CSV waits for) or moving
    (LOG_IDLE_SPEED_KMH and up, so a track without the car's bus still works).
    The trip distance is counted as before - its gate runs first.
    One of those points also read <sat>0</sat> hdop 0.0. After a boot RMC
    brings a position before GGA gives any satellite count, and the quality
    check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
2026-10-22 Gauge: the GPS speed slides too, at most ten new numbers a second
    The GPS screen's speed slides like oil and coolant (asked 2026-10-22). At
    25 fixes a second a rising speed changes the number faster than any slide
    could finish, so a new speed is shown at most every GPS_SPEED_SHOW_MS (100
    ms) and slides in over as long: each slide ends before the next number
    comes, and none is cut short. The latest speed shows on the first pass
    after. slide_text() takes the slide's duration (oil and coolant stay at
    SLIDE_MS, 180 ms).
    The simulator starts a replay just before the track when it begins more
    than 10 s after the car data - the 2026-10-20 drive's GPS found its fix
    three minutes in, and the GPS scr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
2026-10-22 Gauge: the AP's beacons say which drive is the last, for the phone
    Asked 2026-10-22: the phone should learn there are drives it has not synced
    without joining the pod's WiFi. A BLE advertisement was tried first and
    dropped: NimBLE's controller takes ~21 KB of internal RAM, and with the AP
    up the pod fell to 13 KB free and crashed. The AP already beacons, so the
    news rides in it instead - a vendor IE, which costs nothing.
    The IE is in the beacons and the probe responses: 0xDD, OUI 02:4E:47 (a
    locally administered one), type 1, then 8 bytes - logcrypt_beacon(): a
    BLAKE2b-8 of the log key's public half, "n-gauge beacon v1" and the last
    drive's 6-char session id. Not the session itself: with th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
2026-10-22 App: a note when the gauge has a drive the phone does not
    The other half of the gauge's beacon (asked 2026-10-22): the phone reads
    the vendor element the parked gauge's WiFi beacons carry from its own WiFi
    scan results, without joining, and tells you when it names a drive the
    phone has not had.
    PodBeacon.kt reads the newest scan result carrying OUI 02:4E:47 type 1,
    and a WorkManager job checks every 15 minutes (the shortest it allows) with
    the app closed: a fingerprint not among the known ones posts one note
    ("New drives on the gauge"), once per fingerprint. The note goes by itself
    once that drive is on the phone. The comparing is native, so the check
    needs no JS; the app says which fingerp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
2026-10-22 Gauge: a rise slides in from the top; GPS speed 0 when standing
    Seen in the car 2026-10-22: the slides ran the wrong way round. Now a
    number that went up comes in from the top and the old one leaves at the
    bottom; one that went down comes up from the bottom.
    Standing at a fuel pump the GPS speed went 0, 1, 0, 1 - the fix wanders a
    little even when the car does not move, and 0.5 km/h rounded up. Under
    GPS_SPEED_STILL_KMH (2 km/h) it shows 0. A cut-off, not rounding down:
    the wander reaches 1.5 km/h, and rounding down would still flick to 1.
2026-10-22 App: fill-ups in the trips list
    Asked 2026-10-22: a line in the list where the tank was filled, among the
    drives at its time - "Filled up · 8 → 100 % · ≈ 46 l", when and where.
    parseCsv() reads the tank level (fuelPct) with the engine running only. With
    it off the level reads ~20 points high, likely because the sender is
    measured against a supply that drops when the alternator stops. Parked
    without filling, 2026-10-18 read 44 % running and 66 % just after; on
    2026-10-22, 31 % off and 10.6 % at the next start. Running, a low tank
    sloshes 8-15 %, so a level is the median of three minutes at either end of
    an engine-running stretch, and a fill-up is a rise of 20 points or more
    across a st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
2026-10-22 App: the gauge's WiFi found sooner, and joined by hand counts
    2026-10-22 at a fuel pump: tapping the gauge waited the whole 30 s for
    Android's network request to find the pod, then failed. Joining it by hand
    in Android's WiFi list did not help: the app knew only the network its own
    request gave it, so the connect failed anyway and had to be tried again.
    connect() now also watches every WiFi network the phone is on, or joins
    while it waits. One that answers at 4.3.2.1 with the pod's settings, its
    SSID in them, is used as it is, and the request and its prompt are
    withdrawn. A pod joined by hand, before or during the wait, is taken at
    once. The SSID check matters: 4.3.2.1 is a public address,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
2026-10-22 App: a fill-up shown on its drive's card
    A fill-up is always on a drive (asked 2026-10-22), so it is a line in that
    drive's card - "Filled up · 8 → 100 % · ≈ 46 l", and where - not a row of
    its own between the cards. One during the drive is on that drive; one
    found between two drives (the gauge slept through it) is on the later
    one, which set off with the fuller tank.
    A short hop that has a fill-up is no longer hidden with the very short
    drives: a trip to the pump is one. The week grouping is back to drives
    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
2026-10-22 Gauge: the drive log says whether the car is off, on or running
    2026-10-22: two stops with the car switched off, the gauge awake through
    both, read in the app's charts as gaps nobody could explain. The log only
    showed them as the car's columns going empty.
    A `car` column at the end of each row: 0 off (no frame from the car for
    OBD_STALE_MS, as the sleep logic counts it), 1 on with the engine off
    (talking, but under ENGINE_RUNNING_RPM, 300, or no rpm), 2 running. The
    ECU answers 0 rpm with the ignition on and the engine off, and idle is ~750.
2026-10-22 App: the charts shade where the car was off
    Asked 2026-10-22, after a drive with two stops whose car-off minutes were
    plain gaps in the charts. Every chart now shades them behind the lines:
    darker with the car off, lighter with it on and the engine off. A key
    under the charts names what the drive has, and the cursor's line says
    "car off" or "engine off" there.
    The series carries the car's state per bucket (the highest in it): from
    the gauge's new `car` column, or for older logs from the readings -
    running at 300 rpm, on while any of the car's own readings (oil, coolant,
    rpm, OBD speed) come, else off. A bucket with no row keeps the state
    before it: parked, the gauge writes a row only every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
2026-10-23 Gauge: one state for the car, its motion and what follows (not used yet)
    Asked 2026-10-23: the gauge's parts each judged the car by themselves, from
    raw readings, each its own way. Sleep went by CAN frames and GPS over 10
    km/h; the WiFi by GPS over 20 km/h for 5 s and under 5 for 60 s; the
    parked logging by GPS under 3 km/h for 3 minutes; the drive log's `car`
    column by CAN and rpm. They could disagree, and every feature added one.
    podstate.h is the one place, pure like calc.h, worked out once per pass:
    facts copied from the modules (CAN, rpm, speeds, GPS, card, clock,
    WiFi, USB, the last touch, wake cause, firmware state, the
    temperature warnings)
    situati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
2026-10-23 Gauge: the state is worked out each pass; the car and faults come from it
    The first two steps of switching the gauge over to podstate.h (asked
    2026-10-23), the ones that change nothing it does.
    podstate.cpp gathers the facts once per loop() pass, right after the
    temperature states, and works the state out. loop() reads its own; the
    logger and the web server take a copy under a spinlock (podstate_copy).
    power.cpp and ota.cpp say what only they knew: a USB host, the last touch,
    the "Sleep after" window, what woke the board, a firmware on probation.
    The serial port gets a line when the car, the drive, the WiFi, the log
    rate or sleep changes - not every flick between moving and still at a
    crawl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
2026-10-23 Bench: 'D' plays a drive to the gauge's state, with no car
    Asked 2026-10-23: something to test the state (podstate.h) with the bare
    ESP on the desk. 'D' writes the car's frames, rpm and speed each pass, as
    the OBD task would, through a timeline: ignition on, the engine started,
    creeping off, 50 km/h, stopped idling, the engine off, the key out. The
    state then does what a drive would, and its serial lines and the drive
    CSV's car / motion / awake columns show it.
    Run on the desk that day, every change came at its time: driving 5 s
    into 50 km/h, the drive over 60 s after stopping, the car off 5 s after the
    last frame, parked 180 s still; each hold on sleep - the swipe, the motion,
    the car, a p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
2026-10-24 Gauge: the WiFi and the parked log rate follow the gauge's state
    Steps 3 and 4 of switching the gauge over to podstate.h (asked
    2026-10-24).
    The WiFi goes down while driving and back once stopped by the state's
    decision (wifiWanted): by the car's own speed, the GPS's only when the car
    is silent. By the GPS alone, as it was, the AP stayed up until the first fix
    - on 2026-10-23, 5.5 minutes into the 17:45 drive and 2.75 into the 21:26
    one, where the state, replayed from the same logs, knew it was a drive
    within seconds. A phone on it still keeps it up, and a wake still checking
    keeps it down, as before. The thresholds are the same (AP_DRIVE_*).
    The CSV and GPX thin out when the state says pa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
2026-10-24 Gauge: it sleeps when the gauge's state says nothing holds it awake
    The last step of switching the gauge over to podstate.h (asked
    2026-10-24): power_task() sleeps on the state's sleepOk - nothing in
    awakeBecause - instead of its own checks, one by one, of the same things:
    USB, a phone on the WiFi or just gone, a touch, moving, the car talking,
    a cold boot with no car yet, each for the "Sleep after" window after it
    ends. The reasons for each, which were here, are now beside the rule in
    podstate_step.
    Checked first against what the gauge did: on 2026-10-23's 17:45 drive
    the state's last hold, the car, let go at 16:34:56 and the old code slept
    at 16:34:57, the first pass after. On the desk th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
2026-10-25 Decisions: the WiFi beacon, the gauge's state, and what they changed
    Asked 2026-10-25: the beacon was explained only in code comments and
    commit messages.
    New: "New drives are announced in the AP's beacons, not over Bluetooth" -
    why not BLE (NimBLE's RAM, the crash at 13 KB free), the vendor element's
    format, why a keyed fingerprint and not the session or a timestamp, why a
    partly synced drive counts as known, the phone side's location permission
    and its 15-minute floor. And "One state for the car and what follows from
    it" (podstate.h): the five opinions it replaced, its three layers, why
    the car's speed with the GNSS as fallback, one writer and a spinlock.
    Changed, not replaced, where the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
2026-10-26 App: a connect that fails says why - and with WiFi off, offers the switch
    2026-10-26: with the phone's WiFi switched off, a tap on the gauge in
    the header seemed to do nothing. The network request waited its whole 30 s
    for a network it could never find, and the failure went into pod.error,
    which nothing on the chip showed: back to "Not connected", no word why.
    The native connect now checks first: WiFi off is ERR_WIFI_OFF at once. A
    failed connect says why in a toast - WiFi off (and Android's WiFi panel
    opens, one tap to switch it on), the gauge not found or the prompt
    declined (it must be awake), else the error - and the chip shows the
    short reason in red until the next try. The connect on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
2026-10-26 App: WiFi switched on after "WiFi is off" connects by itself
    Asked 2026-10-26: the connect said WiFi was off and opened Android's
    WiFi panel, but switching it on there changed nothing - the chip kept
    "WiFi is off", and the gauge had to be tapped again.
    The module hears the phone's WiFi being switched on (the system's
    WIFI_STATE_CHANGED broadcast, a receiver registered while the app runs) and
    says so (onWifiOn). The "WiFi is off" reason then goes; and after a connect
    you asked for failed for it, it connects again - which syncs. Once: a later
    switch-on, with nothing asked, does not connect.
2026-10-26 App: save new logs into the folder after each sync, if asked
    Asked 2026-10-26: the drives should reach the logs folder - the one
    synced to the PC - without "Save all" after every sync.
    Settings > Logs folder gets "Save new logs after each sync" (off by
    default). With it on, a sync that brought files saves into the folder
    the way "Save all" does: decrypted, under the plain names, skipping what
    is there - so only the new files are written. Said in a toast: how many,
    how many failed, or why it could not. It never opens the folder picker by
    itself - nobody may be looking, the sync on opening the app among them -
    so switching it on without a folder asks for one first, and "Ask every
    time" turns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
2026-10-26 Gauge: every GNSS fix queued for the logs, so a card stall loses none
    Found 2026-10-26 measuring the flush time per encrypted batch: a few
    times a drive the card stalls a write for 0.6-1.35 s (logMaxMs), and the
    GPX has a hole of just that length while moving - 10-28 of 0.2-1.3 s a
    drive, matching logMaxMs to the tenth. The logs read only the latest fix,
    once per logger pass; during a stall the GNSS task kept replacing it, and
    ~30 fixes at 25 Hz were gone. Harmless for a drive's track; a hole in a
    lap's .vbo at a track.
    fixring.h: a ring one task writes and each reader reads at its own pace,
    pure and host-tested (test_fixring) - order, a stall shorter than the ring
    losing nothing, a longer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
2026-10-26 Gauge: log level Normal by default - the raw hex columns are done with
    Asked 2026-10-26: the drive CSV still carried the raw diagnostic bytes.
    LOG_LEVEL_DEFAULT was Full "while values are still being verified against
    the car" (2026-10-16) - and they are: oil from byte 34, coolant 25, the
    tyres. The two raw columns were 44 % of every CSV (2026-10-25 17:42, 1.77
    MB: oilRawPayload 30 %, tpmsRaw 14 %) - half of what the card writes and
    seals for the drive log, and the phone pulls and decrypts.
    Normal by default now. At Normal the two columns stay in the header,
    empty, so the layout is the same at every level. Full is still the phone
    setting's top choice, for the next thing to decode. A gauge ke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
2026-10-30 Logs: the raw hex columns and the Full level are gone
    Asked 2026-10-30. The drive CSV's tpmsRaw and oilRawPayload - the whole
    tyre DID and oil DID replies, as hex - decoded the tyre layout and the oil
    byte; done with since, they were 44 % of every CSV. 72f04f3 made Normal the
    default, but a gauge keeps the level it has: this one still wrote them.
    Gone now: the two columns, the Full level (3) that switched them on, and
    the CAN task's copy of each reply under its spinlock (obd_copy_raw, the two
    48-byte buffers) that existed only for them. The level is 0-2 on the gauge,
    its settings page and in the app; a gauge with 3 stored loads the default,
    Normal (settings.cpp: an out-of-range value loads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
2026-11-02 Gauge: one GPS spike at a standstill is no movement
    2026-11-01, a parked wake (the car opened, not driven, no CAN frame):
    the GPS read 13 km/h for one fix among 4491. That one fix was "moving"
    by the gauge's state (GPS over SLEEP_HOLD_MOVING_KMH with the car silent),
    which held sleep off for the 5-minute window, and it passed the track's own
    opening rule (3 km/h), so a GPX opened: a 0.3 km "drive" in the app. The
    position itself had jumped 200 m off just after the receiver woke from
    backup, and slid back over ~3.5 minutes - the solution settling, the
    receiver's own speed ~0 throughout but for that fix.
    Moving by the GPS (the car silent) now needs its speed held over
    SLEEP_HOLD_MOVING_KMH fo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
2026-11-02 Gauge: GPS points only while the car talks, or really moves
    Asked 2026-11-02, after the 0.3 km "drive" of a parked wake: discard GPS
    points when the car is not talking. With the car off and standing, every
    point is the receiver's noise - the slide after waking from backup, the
    drift through the 5 minutes awake after switching off, appended to every
    track.
    A point is written while the car is on (podstate: car not off), or while
    the state says it moves or drives - the GPS's speed held over 10 km/h for
    3 s (d61c8ae), so one spike cannot fake it, and a CAN fault or a tow still
    has its track (2026-10-19: a broken CAN wire, the GPX that drive's only
    record). Applied to every point, not only to op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
2026-11-02 WireGuard test: does a tunnel to the home VPN fit the gauge's ESP32-S3
    For uploading the logs to a server from the car (asked 2026-10-31): over
    WireGuard rather than TLS, whose two 16 KB record buffers this core puts
    in internal RAM - the gauge's scarce memory, ~105 KB free parked with its
    AP down. WireGuard seals a packet at a time, with the same cryptography
    the logs already use.
    firmware/wgtest: a sketch, not the gauge's firmware. It joins an allowed
    network (a phone's hotspot), sets the clock, brings up a tunnel to the
    home VPN, fetches a page from the server on its LAN, and prints the
    internal RAM - free, largest block, lowest - after each step.
    lib/WireGuard-ESP32: Kenta Ida's librar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
2026-11-02 WireGuard test: it works - a tunnel home costs 0.6 KB of internal RAM
    Run 2026-11-02 on the bench ESP, through a phone's hotspot to the home
    VPN (a Turris router) and on to the server's LAN address: handshake 0.3 s
    after start, then GET 200, 1033 bytes. Internal RAM, from 232.6 KB at
    boot: the WiFi station -43.7 KB, the WireGuard tunnel -0.6 KB, a request
    -2 KB; 48.5 KB below boot at the lowest. On the gauge, parked with its own
    AP down (~105 KB free), ~55 KB would be left - where TLS alone would need
    ~45 KB.
    Two fixes on the way, both on the router: the peer was not in the running
    interface until it was restarted, and its allowed IP did not match the
    gauge's tunnel address (the handshake p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
2026-11-02 Gauge: scan the WiFi around where it parks, before sleeping
    The first part of uploading the logs from where the car parks (asked
    2026-11-02): the gauge has to know which networks are there, so the app
    can show them and the user can allow one, with its password if it has one.
    Just before the sleep after a drive (power.cpp: sleepOk, and a CAN frame
    this wake - the hourly parked wakes do not scan, the car has not moved),
    netscan_parked() takes the AP down as the sleep would next, scans as a
    station (active, 120 ms a channel, hidden networks left out: ~2 s) and
    merges what it saw into a list kept in NVS, a namespace of its own:
    netlist.h, pure and host-tested (test_netlist) - one entry per name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
2026-11-02 App: say the parked-WiFi list is 2.4 GHz only
    The ESP32-S3 radio has no 5 GHz band, so a home network on 5 GHz alone
    never shows up in the card - a note under it says so, rather than
    leaving that to look like a failed scan.
2026-11-03 WiFi/GPS test build: does an upload over the hotspot hurt the fix
    The logs are to go home over the phone's hotspot, which the phone now
    turns on in the car - so the gauge would transmit during the drive, a
    few centimetres from the GNSS antenna. That the AP hurts the fix was
    the premise of AP_DRIVE_OFF, never measured, and an upload is far more
    airtime than an AP's beacons.
    FW_TEST_DEFINE=WIFI_GPS_TEST: while driving, 60 s radio off, then 60 s
    joined to the hotspot (wifitest_secrets.h, not published) sending UDP
    flat out to the hotspot's own discard port - as busy as an upload, no
    mobile data used. GSV comes back on, once a second, for the C/N0 of the
    four strongest satellites: it moves with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
2026-11-04 WiFi/GPS test: an idle step and two low TX powers
    The first two drives (2026-11-04) answered the first question: sending
    flat out at full power cost 6.5 dB of C/N0 in every on-half, the sats
    and the fix held. What they could not say is how much of that is the
    power and whether a radio that is merely on - about what the AP costs
    - matters at all.
    Now four steps of 60 s, round and round while driving: off; joined and
    idle at 19.5 dBm; sending at 8.5 dBm; sending at 2 dBm. The hotspot is
    a metre away at -55 dBm, so even 2 dBm should hold the link. Joined
    stays joined between the on-steps; the CSV gets wtTxDbm, and wtPhase 3
    for idle.
2026-11-06 Which part holds the internal RAM: a ledger, and the app shows it
    The upload over the hotspot needs internal RAM the gauge does not have
    to spare (the WiFi test fell to 23 KB free), and "RAM free" said how
    much was left, never who had the rest. The heap keeps no owners, so
    each part is measured as it starts: the free internal RAM and PSRAM
    before and after its init, which takes in its allocations and the
    stack of any task it starts - the panel, the drawing buffer, the
    screens, CAN, GPS, the card and logger, the USB drive, and the WiFi AP
    each time it comes up (cleared when it goes down). The firmware's own
    variables come from the linker, what the core took before setup() from
    the heap's tota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
2026-11-06 Draw buffer and GPS stack to PSRAM: 42 KB of internal RAM back
    The upload over the hotspot needs internal RAM (the WiFi test fell to
    23 KB free) while 8 MB of PSRAM sits mostly empty.
    LVGL's 40-line strip, 36 KB, was the biggest single block, allocated
    DMA-capable on the belief that the SPI DMA sends it. It does not:
    Arduino_ESP32QSPI::writePixels byte-swaps each piece into its own 2 KB
    internal DMA buffer and sends that, so the strip is only read by the
    CPU and can be anywhere.
    The GPS task's 6 KB stack, with xTaskCreatePinnedToCoreWithCaps: that
    task never writes flash, the one thing a PSRAM-stack task must not do.
    The logger stays internal - it writes the last drive's name to NVS.
    Both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
2026-11-06 Upload server: where the gauge sends its logs over the hotspot
    The first part of the upload: a small service on the home server that
    the gauge reaches through the phone's hotspot and a WireGuard tunnel,
    as the car starts.
    Plain HTTP inside the tunnel, which already encrypts and authenticates
    the gauge; a shared token as a second lock for the rest of the home
    network. Every log only grows on the card, so it resumes by size as the
    phone's sync does: POST /plan with "name size" lines answers what is
    missing from where, PUT /f/<name>?offset=N appends - 409 with the held
    size when N is not it, offset 0 replaces. Written to a side file and
    renamed in, so a cut-off upload leaves the old file whole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
2026-11-06 Gauge: upload the logs home over the phone's hotspot as the car starts
    The phone turns its hotspot on when it joins the car's Bluetooth, so
    the way home is there whenever the car is used. Once per wake, as the
    car starts talking: the AP goes down (apTask sees the hold), a task
    joins the hotspot (up to 90 s - it comes up after the phone's BT),
    brings up the WireGuard tunnel, sends POST /plan with the card's logs
    and PUTs each one's missing part, then gives the radio back. Not while
    a phone is on the AP, not without a valid clock (the handshake carries
    a timestamp the router checks), and no sleep in the middle of it.
    The card is read 4 KB at a time under the logger's lock, as downloads
    are, s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
2026-11-06 App: an Upload card - the hotspot, the server and the tunnel
    Where the gauge's log upload is set up once: the hotspot's name and
    password, the server's URL and token, the router's address, port and
    public key, and the gauge's address in the tunnel. Only what changed
    is sent; the password and token are never read back - their fields
    say whether they are set, and an empty one leaves them as they are.
    The gauge's own WireGuard public key is shown, to copy onto the router
    as a peer, and the last upload's result: files and KB, or why not.
2026-11-06 Upload settings: save every value, say what looks wrong
    The first try in the app (2026-11-06): values were refused - a server
    without http://, a tunnel address as the router shows it (/32) - and
    the card then reloaded from the gauge, so what was typed was gone and
    had to be typed again.
    The gauge now saves whatever comes, cleaned up where the usual forms
    differ: http:// added, a trailing / dropped, /32 cut from the address,
    host:port split into the port. What still looks wrong (a password under
    8, a key not 44 characters, not an IP) comes back as "Saved, but ...".
    The app reloads only on a Saved answer; anything else leaves the form
    as typed.
2026-11-06 Upload card: three sections, the VPN's words left in English
    One list of eight fields did not say which was the VPN and which the
    server at home. Now in the order the way goes: the phone hotspot (name,
    password), the WireGuard VPN (endpoint, port, router public key, the
    gauge's address in the tunnel, and the gauge's public key to put on the
    router as a peer), the upload server (address, token).
    The VPN section is English in every language: those are the words the
    router's page and WireGuard use, to be matched against them.
2026-11-06 Upload: the clock from NTP when there is none, and say why not
    First bench run (2026-11-06): 'U' did nothing and said nothing - the
    bench board's RTC had lost its time, and the upload waited for a valid
    clock. The handshake does need one (the router checks its timestamp),
    but the hotspot can give it: with no clock, the task sets it from NTP
    after joining - esp_sntp directly, since configTime() would also set
    TZ over the gauge's own.
    When an upload is asked for and cannot start, the console says why:
    not set up, no card, a phone on the AP. And a line per step - joined,
    clock, tunnel up with the internal RAM left, logs on the card, the
    plan's answer - since the first run looked hung while it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
2026-11-06 Upload: closing the tunnel crashed the gauge - fixed in the library
    Every upload ended in a reset (bench, 2026-11-06): the first one after
    11 minutes, at its time cap, and then each one at its end - a crash,
    seen only as reset=crash in the boot log, since the panic goes to a
    console the gauge does not have.
    Breadcrumbs in RTC memory (wg_end_step, kept across the reset, printed
    by the next boot) put it in WireGuard::end(), at netif_remove(): the
    library freed the device (netif->state) in wireguardif_shutdown() and
    only then removed the interface, which still ran on it. Now removed
    first, freed after. Seen: closed, radio off, the AP back, and a second
    upload in the same boot opened and closed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
2026-11-06 Upload: the time limit is a setting, minutes, in the Upload card
    The cap on one upload was 10 minutes, fixed - how long the phone's
    hotspot is the gauge's. Now upMaxMin, 1-60 (default 10), in the app's
    Upload server section; the UP_SHORT_TEST build that cut it to 60 s for
    the bench goes, a setting of 1 does the same.
    And the result says what it means: "time limit - the rest goes next
    time" rather than "out of time", and only with files still to go - a
    run whose last file ended just past the limit is done.
2026-11-06 READMEs: the upload home, the server, the RAM breakdown
    The main README gains what the gauge does now: the logs uploaded home
    as the car starts, over the phone's hotspot and a WireGuard tunnel, to
    the service in server/ (in the repository table, and how to run it);
    GPS points only while the car talks or moves; the new-drive
    notification, saving after a sync, which part holds the RAM; the boot
    log naming a watchdog's task. The CSV no longer has raw payloads -
    dropped 2026-10-30.
    The app's README lists /api/ram and /api/upload and the Upload and
    System cards; the firmware's, upload.cpp, ramlog/taskwdt and the
    WiFi/GPS test build, and no longer a Full log level that is gone.
2026-11-06 App: pull the drives from the home server, by themselves
    The gauge uploads its logs home as the car starts; now the phone pulls
    them from there too, so the drives are on it almost all the time - no
    visit to the gauge's WiFi. The same files, by the same names, into the
    same inbox as the gauge's sync, and as encrypted: decrypted on the
    phone as ever.
    By itself when the app opens or comes back and once the phone has left
    the gauge's WiFi, at most every 5 minutes, and quietly where the server
    is not reachable (it is at home, or with the phone's VPN up); or from
    the new Home server card in Settings - its address and token (kept in
    SecureStore), the last sync from it, and a Sync button. Never whi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
2026-11-06 App: the home server is set once, in the gauge's Upload card
    It is the gauge's server, and the gauge already had its address and
    token - typing them again in the phone's Settings was the same thing
    twice. Now the Upload card is the one place: saving there keeps them
    on the phone too, and the address follows the gauge each time the card
    opens. The token goes to the phone only when typed there, since the
    gauge never gives it back (anyone who scans its WiFi QR could read it);
    the card asks for it once if the phone lacks it.
    The phone's Home server card is left with what is the phone's own: the
    address it pulls from, the last sync from it, and the Sync button.
2026-11-06 App: no Home server card in Settings
    It showed the address the phone pulls from, the last sync and a Sync
    button - little use: the address and token are set in the gauge's
    Upload card, and the sync runs by itself whenever the phone is where
    the server is (a toast says what came). Gone, with its words.
2026-11-06 Gauge: a phone on the WiFi shows on every screen, in blue
    Asked 2026-10-18: like the over-temperature warning, the notification
    rim and its line over whichever screen is up - "phone connected"
    while a phone is on the gauge's WiFi, so a sync or a settings change is
    seen from the driver's seat.
    It is no fault: FAULT_PHONE is the last bit, below every real one, so
    a fault wins the text (a tap still steps through) and the rim's colour;
    and it is blue, the rim's third level after red and amber - shown blue
    only when nothing else is up, never to be read as a fault. The colour
    change stays guarded, as the rim's redraw cost needs.
2026-11-06 Speed in mph and distance in miles - a setting, on the gauge and in the app
    Asked 2026-10-20; decided 2026-11-06: speed and distance only.
    Temperatures, pressures and consumption stay metric, the track
    screen's distance to the line stays in metres, the logs stay metric.
    The gauge: "mph" in the settings table (Display), and the GPS screen
    reads mph and miles by it, its unit's name too - redrawn when it
    changes. The app: the same setting in Gauge settings, and a copy kept
    on the phone each time it reads the gauge's (units.ts), so the drives
    read as the gauge shows when it is not connected. Every speed and
    distance the app shows goes through units.ts - the drive list, the
    drive's figures, the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
2026-11-06 Gauge: the big numbers centred in their slots, the symbols smaller
    With the 96 px digits a two-digit "88°" left most of its three-digit
    slot empty on the right - left-aligned - and the whole row sat ~30 px
    left of centre (seen in the sim, 2026-11-06). Now centred in the slot:
    the row always looks centred, the symbol still never moves; only its
    gap to the number changes a little with the digit count. Coolant shares
    the oil's slot width, so the two numbers share a centre line.
    The temperature symbols 44 px high (52 was a touch much).
2026-11-06 Setting: the numbers' slide, on or off
    Asked 2026-11-06: the slide of a changing number (2026-10-19 - the new
    one in, the old one out) switchable, to have it off for now. "slide"
    (slideNumbers) in the settings table, on by default as before; off,
    slide_text() just sets the new text - after ending any slide under way,
    so switching it off never leaves a half-slid number. In the app's
    Gauge settings, Display.
2026-11-06 App: Gauge settings save by themselves - every card, no Save button
    Asked 2026-11-06. A change goes to the gauge a second after the last
    one (the Upload card's typed fields, 1.5 s), whatever changed and is
    valid in one /save - switches flipped together, a number typed digit by
    digit, go as one. A number out of range waits, marked, as before; the
    gauge's answer is a quiet line ("Saving…", then "Saved." or what went
    wrong), no longer an alert.
    What was sent leaves the edits once the gauge has it, the rest stays:
    a field typed in meanwhile is not wiped by the save's reload, and goes
    with the next one. The settings, the screen order and the Upload card
    alike; the Upload card stops a running s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
2026-11-07 Logger: card writes 16 KB at a time, not 4
    The SD driver DMAs only from internal RAM, so every card write passes
    through ioBuf - 4 KB, when internal RAM was short. With the draw buffer
    and the GNSS stack in PSRAM (~44 KB back) it is 16 KB: a batch goes to
    the card in a quarter of the commands, bigger writes kinder to the
    card's flash, whose own stalls were the logger's longest waits. An
    encrypted record is a chunk, so they are 16 KB too - both readers (the
    app's logcrypt.ts, logcrypt.h) take up to 256 KB. ~105 KB of internal
    RAM left with the AP up, against the 80 it needs. Asked 2026-11-07.
2026-11-07 Upload: three files at once - 2.3x faster on mobile data
    One connection here keeps at most the stack's send buffer in flight,
    ~5.7 KB (lwIP's TCP_SND_BUF, fixed in the core's build), so it runs at
    that over the round trip: through the tunnel on mobile data ~90 ms, so
    ~64 KB/s - measured so (2026-11-07), against several MB/s from the
    gauge's own WiFi, where the round trip is a millisecond.
    Now three workers take the plan's files in turn, each on its own
    connection: measured 145 KB/s on large files (38.5 MB in 267 s), 118
    on the small ones, which pay a connection each. Each worker has its own
    4 KB card buffer; the card is still read a chunk at a time under the
    logger's lock, and the turn give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
2026-11-09 Firmware updates from the home server, signed
    The gauge can now update itself from the upload server. Before the logs
    (a firmware is one file, the logs' time limit would crowd it out) it asks
    /fw/latest; one built later than its own, not tried before, it downloads
    to the card, checks against its signature and renames to /firmware.bin,
    which the SD install puts on before the next sleep - the logs closed, the
    running firmware confirmed first, so a rollback lands on it. A failed
    step never fails the upload. On by default once a server is set up; the
    app's Home server card (renamed from "Upload to the home server": it is
    the phone's sync and the updates too now) has the switch.
    The signature is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
2026-11-09 The gauge's WiFi only from its screen, and a status screen for the upload
    The AP was up whenever the gauge was awake and not driving, so as the
    car started the log upload took the radio from it for minutes - the
    phone could not connect and nothing said why. With an upload server set
    up, the AP now comes up only when asked for: the WiFi screen swiped to,
    or a phone on it, and AP_LINGER_MS (3 min) after the last of them. Asked
    for while driving, it comes up too - someone wants it. The radio is
    otherwise the upload's, and not transmitting by the GNSS antenna. A
    setting (Power, "Gauge WiFi only from its screen", on); without a server
    the AP is always up, as before - the only way the logs leave t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
2026-11-09 CI: the checks on every push, a firmware release for a version tag
    GitHub Actions had nothing to run. Now every push and pull request runs
    scripts/check.sh - the host tests, the car and bench firmware, the
    simulator, the upload server - with the Arduino core and libraries
    cached, and the app's typecheck, lint and tests. A tag v* also releases
    the car firmware: the image as an update takes it, and a full image at
    the flash offsets build.sh uses, for a first flash; with the commits
    since the last tag as its notes. The firmware carries the public half of
    the update signing key from the repository variable FW_SIGN_PUB. The APK
    stays a local build: in CI it would need the app's signing key.
2026-11-09 CI: the car image's own build stamp in the log, not the bench build's
    The log printed build_info.h after check.sh, which by then is the bench
    build's (built last) - the released image is the car build, as its own
    stamp says.
2026-11-09 Clock: no 27-year "drift" after the chip lost power
    A boot after a full power loss (2026-11-09) logged drift=-847534460s.
    Nothing was wrong with the time: the PCF85063 has no backup cell, came
    back at its reset value 2000-01-01 with the oscillator-stop flag set,
    and was rightly not trusted until the GNSS fix. But when the fix came,
    rtc_task measured the chip against it as if the chip had kept time, and
    the boot line showed that gap as drift. Now a chip whose oscillator had
    stopped is simply set: drift stays 0, and the boot line says lost=1.
2026-11-11 Firmware from the server: after the logs, and a cut-off download resumes
    Two downloads in a row failed on 2026-11-10/11 - the garage's mobile
    signal: the gauge gives up after UP_HTTP_MS without data - and the
    second took the whole upload with it, logs and all: the firmware came
    first. Now the logs go first, the firmware after with the time they
    left (stopped at the time limit, it goes on next time too).
    And a download cut off is not started over: OTA_SD_NEW stays on the
    card with NVS fwPart naming the release it is of; next time the card's
    part is read back into the SHA-256 (the signature covers the whole
    image) and only the rest asked for, with Range - the server answers it
    already. Anothe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
2026-11-11 Firmware from GitHub Releases, signed: CI signs, the app fetches and installs
    A release (a v* tag) now carries the image's signature and "latest" next
    to it, signed in CI by the private key in the secret FW_SIGN_KEY exactly
    as release-fw.py signs for the home server (--sign-into, new: an existing
    build, no copy). CI builds the car image once more after check.sh, so
    build_info.h - the signed build time - is the car's, not the bench's.
    The app, while it is open in front with internet and at most once a day
    (kept across restarts; never from the background task - the battery),
    looks at the latest release on GitHub; one newer than the gauge runs it
    downloads and checks - whole, the image it says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
2026-11-11 Upload: the gauge joins the hotspot as "n-gauge"
    The phone's hotspot listed it as the ESP32's default, esp32s3-xxxxxx.
    The station now sends WIFI_STA_HOSTNAME with its DHCP request - set
    before the interface starts, or it would only count from the next.
2026-11-11 App: a button to look for a newer gauge firmware now
    Settings > About: "Look for a newer gauge firmware" - the same look as
    the day's one (fw-download.ts), now and past the once-a-day limit; says
    what came of it (downloaded and checked: install it in Gauge settings).
    Not while on the gauge's WiFi, which has no internet.
2026-11-12 App: "Save all to a folder" asks - all logs, or the last 7 days
    All of them were 500 MB by 2026-11-12, and saving them took long - when
    what is wanted after a sync is mostly the new ones. The drives and track
    sessions by when they started; the gauge's boot and sleep logs always.
2026-11-12 docs/flows.md: how the gauge decides, as diagrams
    Mermaid, which GitHub draws from the text: where the logs go, the log
    upload (start, steps, retries, giving way to the WiFi), the gauge's WiFi,
    firmware updates (the three ways in, checked, on probation), the screens,
    sleep and wake. Each names the file holding the real rules; edited with
    the code, in the same commit - nothing to regenerate.
2026-11-12 An analog clock screen
    Hour numbers and minute ticks round the panel (LVGL's round scale, drawn
    once), three hands as line objects - one redraw a second, of the boxes
    the hands sweep - the date under the centre. Local time, as the gauge's
    TZ setting makes it; without a valid clock the hands are hidden and it
    says it waits for GPS. Asked 2026-11-13.
    It takes view slot 1, the old coolant screen's: the screen order is one
    digit per view and 1 was the last free digit - no stored order or last
    view could hold it. Optional like the status screen: switched on in the
    app's screen order ("Clock").
2026-11-13 An overview screen, first; the screens numbered in their natural order
    The overview (ui_overview.cpp): oil and coolant as the oil screen has
    them - the two rings and their colours - boost large in the centre, the
    fuel below (this drive's average large, from the car's fuel rate and
    speed summed since the wake; the instant value - per 100 km rolling, per
    hour standing - and the tank level small), and the four tyre pressures
    round a small car, red outside their axle's limits. Asked 2026-11-13.
    The screens renumbered in their natural order - overview, oil, boost,
    tyres, GPS, track, g-meter, clock, status, WiFi as 0-9; the sync screen
    and the screen saver, never ordered nor stored, after. No map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
2026-11-13 Server: pass the latest GitHub release on to the gauge
    The gauge's /fw/latest, /fw/bin and /fw/sig are now fetched from
    FW_GITHUB_REPO's latest release on each request, over HTTPS, and
    handed to the gauge as plain HTTP inside the WireGuard tunnel - the
    gauge needs no TLS, and its signature check still decides what is
    installed. Nothing is cached: a Range goes on to GitHub (past the
    asset redirect), so a cut-off download still resumes; GitHub's status,
    Content-Length and Content-Range are passed through, as the gauge
    reads them. 404 without a repo or a release, 502 when GitHub is not
    reached.
    A release is now only a v* tag: release-fw.py --to (scp to the
    server) is gone; --init, --pub and --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
2026-11-13 Mark a drive that did not end: an end row, an end mark, a note in the app
    A drive uploaded while still being driven (or cut off by a power loss
    or a reset) showed in the app as a whole, short drive - 2.3 km of a
    much longer one. Nothing in the logs told the two apart: the plain GPX
    gets its closing tags after every batch on purpose, and an encrypted one
    never has them.
    Gauge: the CSV gets an "end" column, empty on every row, and on close
    (sleep, reboot, the card shared, a key change) one last row with the
    time and end=1. The GPX gets an "<!-- end -->" comment on close. The
    column's presence says the file can tell; old logs stay unknown.
    App: parseCsv/parseGpx read them (the end row counts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
2026-11-13 App: mark a cut-off drive as finished
    A drive whose logs did not end gets a note (4d2354a) - but one cut off
    by a power loss will never get its end, and the note would stay for
    good. Its screen's menu now has "Mark as finished" (and "Mark as not
    finished" to take it back): the note goes, there and in the list.
    Kept by the drive's file names (finished.json), not its key, which
    moves from the CSV to the GPX when that arrives; in the backup too.
2026-11-13 build-apk.sh: sign with the app's own key from ~/.config/n-gauge
    The script never set APP_KEYSTORE, so a plain run signed with the debug
    key and the phone, which has the N Gauge-signed app, refused it
    (INSTALL_FAILED_UPDATE_INCOMPATIBLE). It now takes app-signing.jks and
    .pass from there when APP_KEYSTORE is not set, warns when it falls back
    to the debug key, and prints the APK's signer.
2026-11-14 Upload: take the hotspot's interface down before the radio stops
    2026-11-14 16:40 the gauge crashed ~30 s after an upload had closed
    (crash recorder: InstrFetchProhibited, pc 0; backtrace etharp_tmr ->
    etharp_request -> etharp_raw -> ethernet_output -> wlanif.c
    low_level_output). lwIP's ARP timer re-asked for the router through the
    station interface after the WiFi driver beneath it had gone: the close
    runs wg.end(), WiFi.disconnect(true) and WiFi.mode(WIFI_OFF) back to
    back, and lwIP's interface can outlive the driver. An entry in use is
    re-asked shortly before it expires, which would explain why it strikes
    only now and then.
    Now the station's lwIP netif is set link-down and down under the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
